Roboy/iceboard/datasheets/pcb_components.png

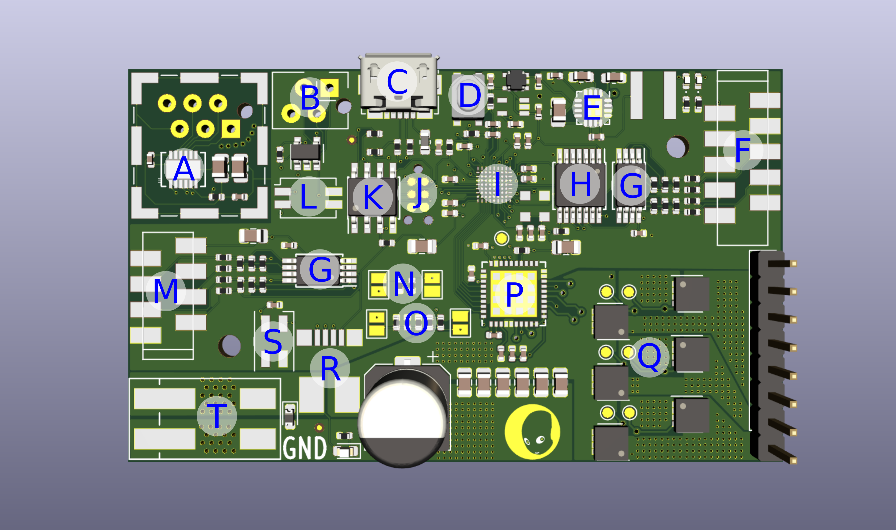
datasheets/pcb_components.png
