Roboy/iceboard/datasheets/tinyfpga_bx-pinout.jpg

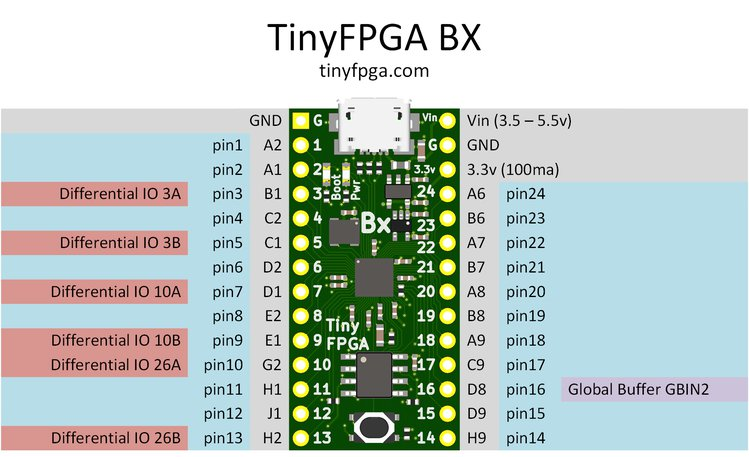
datasheets/tinyfpga_bx-pinout.jpg
