Roboy/iceboard/README.md

# bldc_motorboard
awesome motorboard for myoFamily muscles
