Roboy/iceboard/board/icebus.png

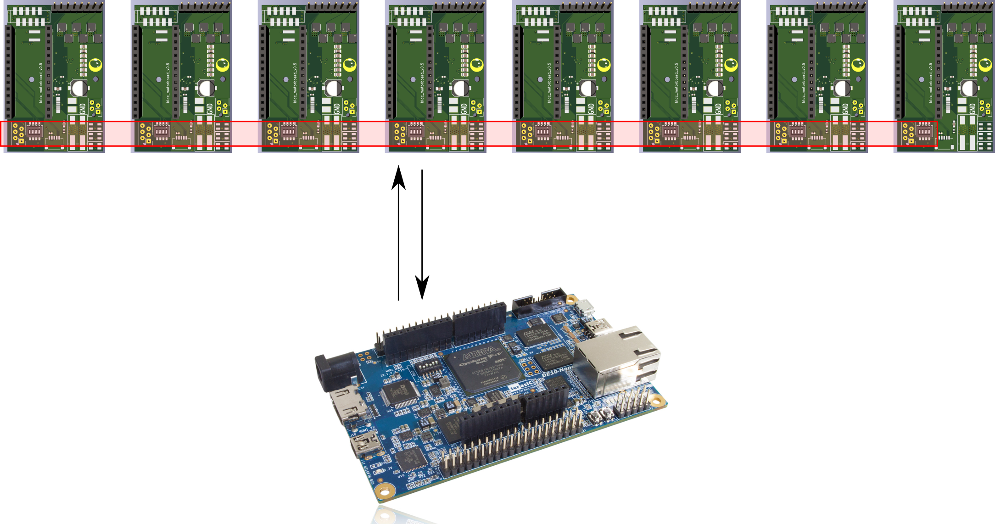
board/icebus.png
