Roboy/iceboard/board/overview.png

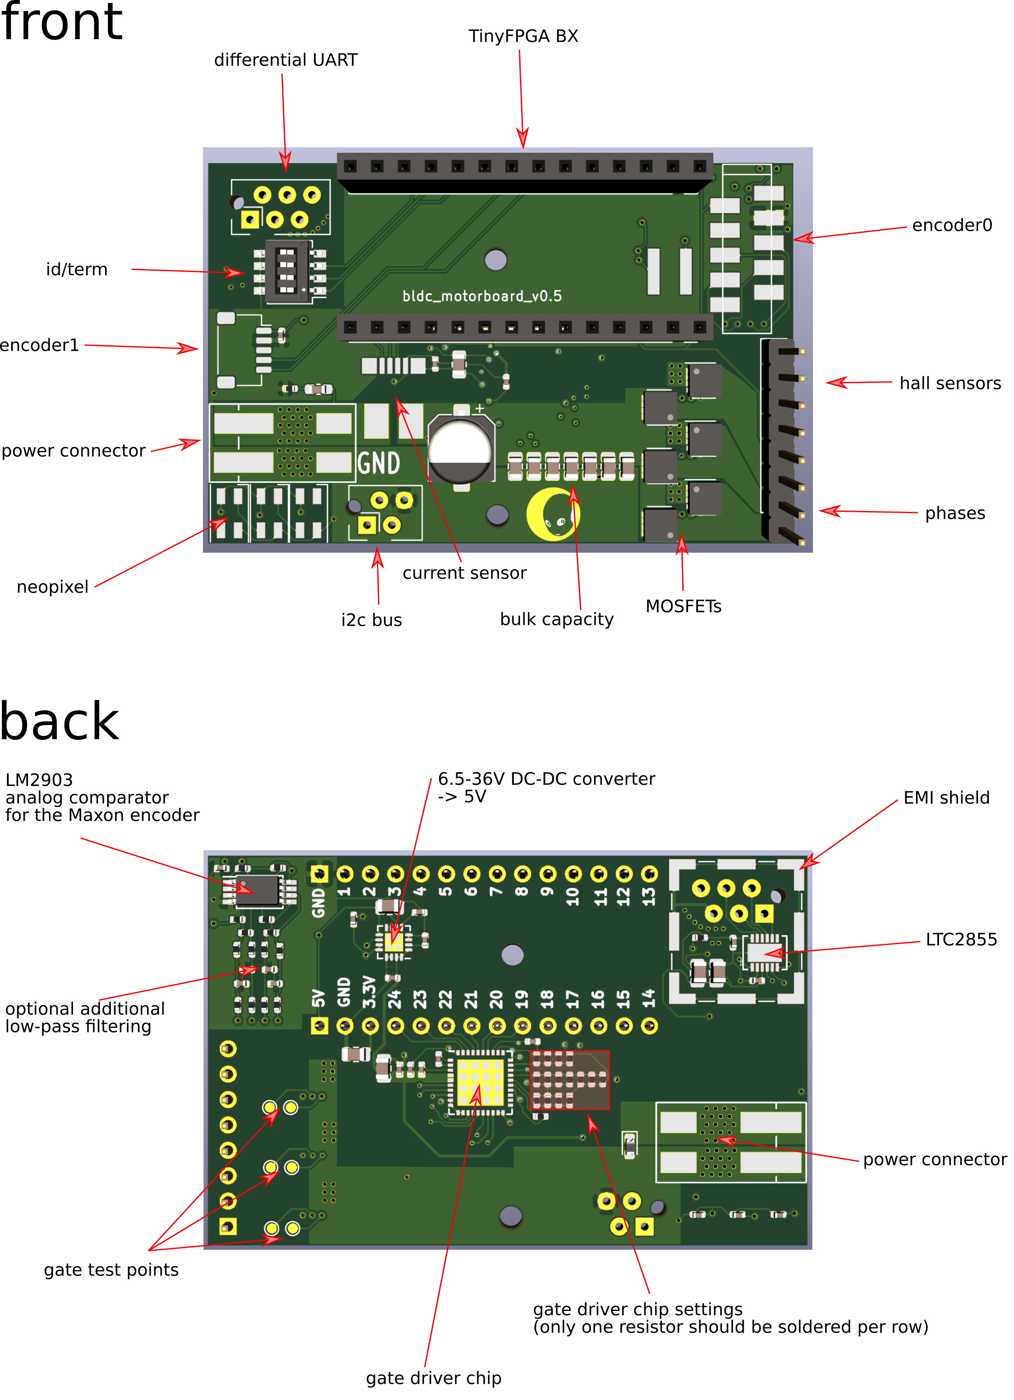
board/overview.png
