Roboy/iceboard/board/shield.png

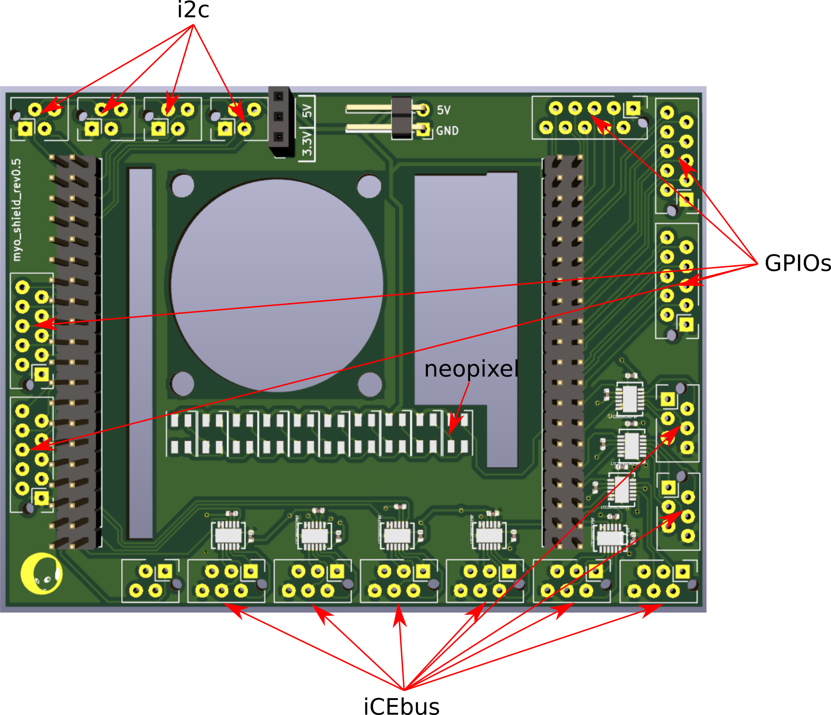
board/shield.png
