Roboy/iceboard/board/uart_protocol.jpg

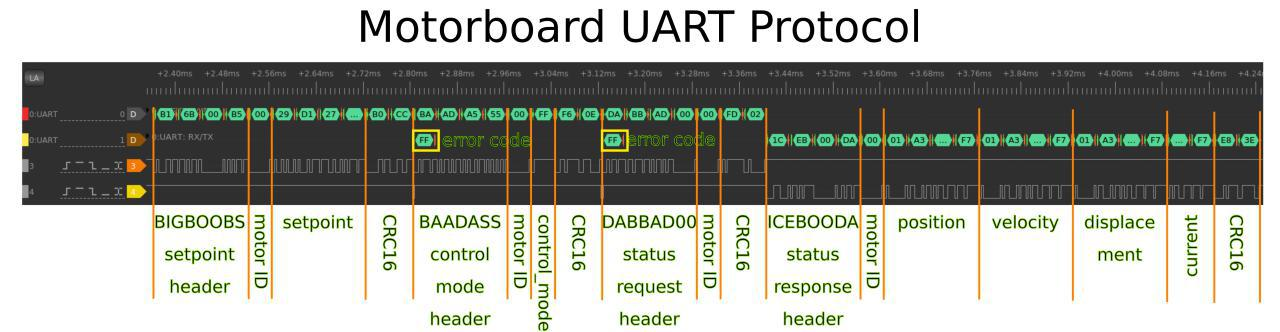
board/uart_protocol.jpg
