Roboy/iceboard/datasheets/icebus_command.png

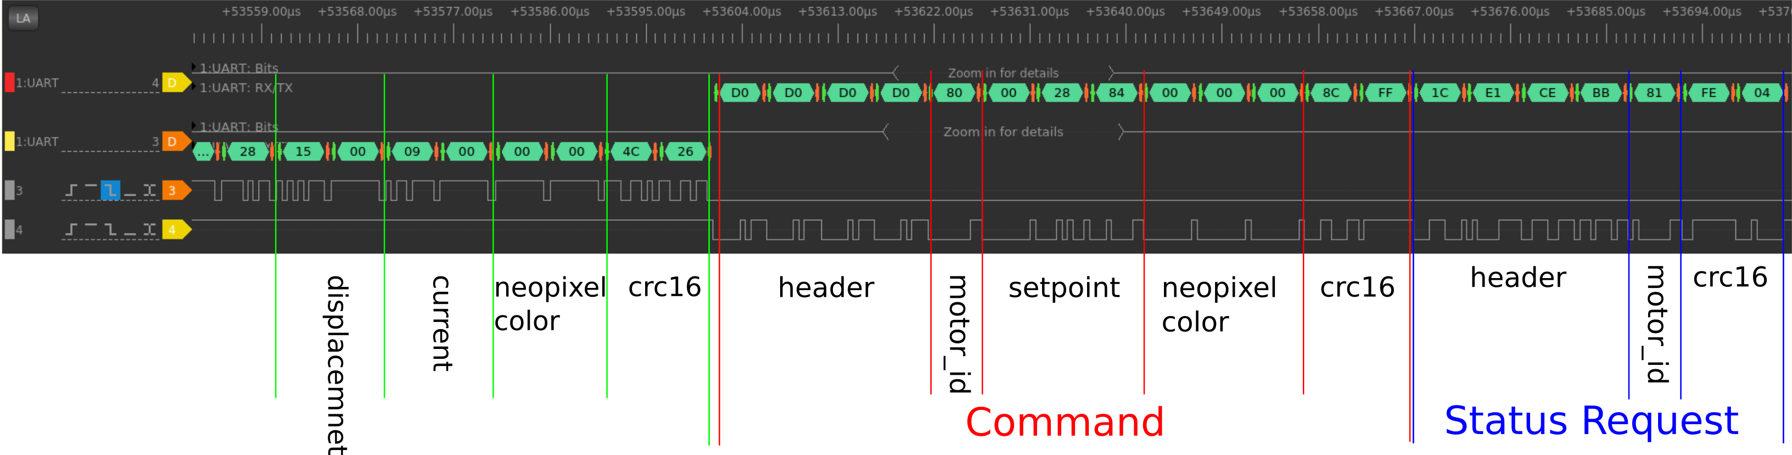
datasheets/icebus_command.png
