Roboy/iceboard/datasheets/icebus_status.png

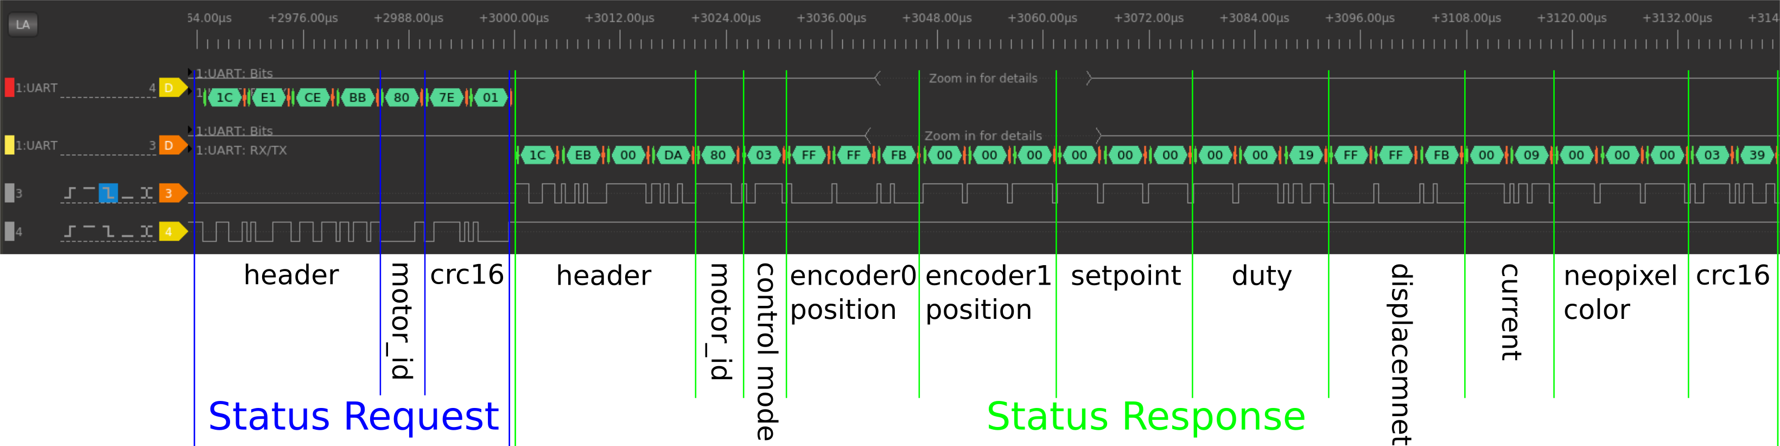
datasheets/icebus_status.png
