Roboy/iceboard/board/BOM.ods

Id | Designator | Package | Quantity | Designation | Supplier and ref
4 | C29,C26,C24,C15,C23,C18,C17,Cf1,C16,C14,C13,C8,C6,C2 | C_0402_1005Metric | 14 | 0.1uF
5 | U1 | BGA-25_6.35x6.35mm_Layout5x5_P1.27mm | 1 | LTM8074 | https://www.mouser.de/ProductDetail/Analog-Devices-Linear-Technology/LTM8074IYPBF
6 | D3 | LED_WS2812B-PLCC4_3.5x3.5 | 1 | NeoPixel_THT
7 | U2 | TSSOP-8_3x3mm_P0.65mm | 1 | LM2903 | https://www.mouser.de/ProductDetail/595-LM2903EPWRQ1
8 | R17,R16 | R_0402_1005Metric | 2 | 100k
9 | R15,R14,R13,R12,R11,R10,R9,R8,R7,R6,R5,R4,Rled1,R3 | R_0402_1005Metric | 14 | 10k
12 | D2 | D_0603_1608Metric | 1 | D_TVS
13 | J1 | MIRCO_MATCH | 1 | OpticalEncoder
14 | U3 | LTC8252_DD_DFN-10_DD | 1 | LTC2852HDDPBF
15 | J2 | PinHeader_1x08_P2.54mm_Vertical | 1 | PHASES
16 | D1 | C_0603_1608Metric_Pad1.05x0.95mm_HandSolder | 1 | LED
17 | Rt1 | R_0402_1005Metric | 1 | 22k
18 | Rfb1 | R_0402_1005Metric | 1 | 45.6k
19 | C12,C11,C10,C9 | C_0402_1005Metric | 4 | 22u
20 | J8 | Wago_2060_2_SMD | 1 | POWER_OUT
21 | J3 | Wago_2060_2_SMD | 1 | POWER_IN
22 | U7,U6,U5 | TLI4970 | 3 | TLI4970 | https://www.mouser.de/Sensors/Current-Sensors/Board-Mount-Current-Sensors/_/N-7gqfe?Keyword=TLI4970&FS=True
23 | Q1,Q4,Q5,Q3,Q2,Q6 | VSON-8_3.3x3.3mm_P0.65mm_NexFET | 6 | CSD18534Q5A
24 | R2 | R_0402_1005Metric | 1 | >500k -> 20V/V
25 | R1 | R_0402_1005Metric | 1 | 18k -> 570/1140mA
26 | DRV8323H1 | QFN-40-1EP_6x6mm_Pitch0.5mm | 1 | DRV8323HRTA | https://www.mouser.de/ProductDetail/Texas-Instruments/DRV8323HRTAR
27 | C27,C22,C21,C20,C19,C7 | C_0805_2012Metric | 6 | 22u/50V
28 | C25 | CP_Elec_6.3x4.5 | 1 | 220u
29 | C5,C3 | C_0402_1005Metric | 2 | 1uF
30 | C4 | C_0402_1005Metric | 1 | 47nF
31 | C1 | C_0402_1005Metric | 1 | 10uF
32 | J5 | TE-Connectivity_Micro-Match_connector_02x03_Pitch_1.27mm | 1 | UART
33 | J4 | TE-Connectivity_Micro-Match_connector_02x02_Pitch_1.27mm | 1 | Encoder1
34 | SW1 | SW_DIP_SPSTx03_Slide_KingTek_DSHP03TS_W7.62mm_P1.27mm | 1 | SW_DIP_x03
