Roboy/iceboard/board/bldc_board_v0.8.6/BOM.csv

Pos | Package | Value | Weborder | Quantity
C35,C34,C32,C31,C40 | C_0805_2012Metric | 100u/6.3V | https://www.mouser.de/ProductDetail/Murata-Electronics/GRM21BR60J107ME15L | 5
U11 | TSSOP-14_4.4x5mm_P0.65mm | TXB0104PW | https://www.mouser.de/ProductDetail/Texas-Instruments/TXB0104PWR | 1
L1 | XAL5050-103MEC | 10uH | https://www.mouser.de/ProductDetail/Coilcraft/XAL5050-103MEC | 1
U8 | iCE40-PL9K-CM81 | iCE40-LP8K-CM81 | https://www.mouser.de/ProductDetail/Lattice/iCE40LP8K-CM81 | 1
J4 | micro_match_female_8pos_SMT | ENCODER1 | https://www.mouser.de/ProductDetail/?qs=tddCKBGf4%252BORyb3AeIHMhg%3D%3D | 1
DRV8323H1 | QFN-40-1EP_6x6mm_Pitch0.5mm | DRV8323HRTA | https://www.mouser.de/ProductDetail/Texas-Instruments/DRV8323HRTAR | 1
U2,U5 | TSSOP-8_4.4x3mm_P0.65mm | LM2903 | https://www.mouser.de/ProductDetail/Texas-Instruments/LM2903PWR | 2
Q2,Q1,Q4,Q5,Q3,Q6 | VSON-8_3.3x3.3mm_P0.65mm_NexFET | BSZ100N06NS | https://www.mouser.de/ProductDetail/Infineon-Technologies/BSZ100N06NS | 6
U1 | ltc2855 | LTC2855CDEPBF | https://www.mouser.de/ProductDetail/Analog-Devices/LTC2855CDEPBF | 1
R27,R15,R14,R4,Rled1,R3,R35,R36,R45,R46,R48,R49,R47 | R_0402_1005Metric | 10k |  | 21
C23,C22,C11,Cf1,C6,C2,C24,Cf2,C13,C14,C16,C29,C41,C44,C46,C47 | C_0402_1005Metric | 0.1uF | https://www.mouser.de/ProductDetail/Wurth-Elektronik/885012105018 | 16
C21,C19,C18,C27,C20,C7,C30 | C_0805_2012Metric | 22uF/35V | https://www.mouser.de/ProductDetail/TDK/C2012JB1V226M125AC | 7
C25 | CP_Elec_6.3x4.5 | 220uF | https://www.mouser.de/ProductDetail/Nichicon/UUR1V221MNL6GS?qs=sGAEpiMZZMvwFf0viD3Y3drhLzO8cB0SKlUrwx8MzyQ%3D | 1
C8,C9 | C_0603_1608Metric | 2.2uF | https://www.mouser.de/ProductDetail/Murata-Electronics/GRM188R6YA225MA12D | 2
C12 | C_0805_2012Metric | 22uF | https://www.mouser.de/ProductDetail/KEMET/C0805C226M9PACTU?qs=sGAEpiMZZMs0AnBnWHyRQHfJxnYD9SALQCiwVfbOcCo%3D | 1
MAX176321 | QFN-16-1EP_3x3mm_Pitch0.5mm | MAX17632 | https://www.mouser.de/ProductDetail/Maxim-Integrated/MAX17632BATE%2b | 1
C10 | C_0402_1005Metric | 5600pF/6.3V |  | 1
R11,R10,R9,R8,R7,R6,R5,R32,R17,R16,R37,R38 | R_0402_1005Metric | 1k |  | 8
D2 | D_0603_1608Metric | D_TVS | https://www.mouser.de/ProductDetail/Comchip-Technology/CPDU24V0U-HF | 1
J3 | Wago_2060_2_SMD | POWER_IN | https://www.reichelt.com/de/en/smd-pcb-terminal-2-pole-rm-4-mm-white-wago-2060-452-p163243.html?trstct=vrt_pdn | 1
C5,C3,C17,C26,C28,C36 | C_0402_1005Metric | 1uF |  | 6
C4 | C_0402_1005Metric | 47nF |  | 1
C15,C38 | C_0402_1005Metric | 10uF | https://www.mouser.de/ProductDetail/Murata-Electronics/GRJ155R60J106ME11D | 2
D3 | LED_SK6812MINI_PLCC4_3.5x3.5mm_P1.75mm | SK6812MINI | https://www.aliexpress.com/item/32434844290.html | 1
U3 | TLI4970 | TLI4970 | https://www.mouser.de/ProductDetail/Infineon-Technologies/TLI4970D025T5XUMA1 | 1
J1 | micro_match_female_10pos_SMT | ENCODER0 | https://www.mouser.de/ProductDetail/TE-Connectivity/1-2178711-0 | 1
R39 | R_0402_1005Metric | 100 |  | 1
R40 | R_0402_1005Metric | 1.5k |  | 1
R41,R42 | R_0402_1005Metric | 68 |  | 2
R43,R44 | R_0402_1005Metric | 270 |  | 2
U4 | SOT-23-5 | EEPROM | https://www.mouser.de/ProductDetail/Microchip-Technology-Atmel/AT24C16D-STUM-T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 | 1
J6 | USB_Micro-B_Molex_47346-0001 | USB_OTG | https://www.mouser.de/ProductDetail/Molex/47346-0001 | 1
U9 | SOIC-8_3.9x4.9mm_P1.27mm | AT25SF081-SSHD-B | https://www.mouser.de/ProductDetail/Adesto-Technologies/AT25SF081-SSHD-B | 1
SW2 | PTS_810_SMT_Switch | SW_Push | https://www.mouser.de/ProductDetail/CK/PTS810SJK250SMTRLFS?qs=sGAEpiMZZMsgGjVA3toVBGTSKfeK9LPKcu5sgFDgdHE%3D | 1
U6 | SC70-5 | TLV70033DCKR | https://www.mouser.de/ProductDetail/595-TLV70033DCKR | 1
U7 | SC-70-C5 | MIC5365-1.2YC5-TR | https://www.mouser.de/ProductDetail/Microchip-Technology-Micrel/MIC5365-12YC5-TR | 1
U10 | CDFN3225-4LD-PL-1 | DSC6001CI2A-016.0000T | https://www.mouser.de/ProductDetail/Microchip-Technology/DSC6001CI2A-0160000T | 1
C37,C39,C42,C43 | C_0402_1005Metric | 10nF/6.3V |  | 4
D1 | LED_0603_1608Metric | LED | https://www.mouser.de/ProductDetail/ROHM-Semiconductor/SMLD12BN1WT86 | 1
L2 | L_0603_1608Metric | Bead | https://www.mouser.de/ProductDetail/Murata-Electronics/BLM18PG600SZ1D | 1
SW1 | SW_DIP_SPSTx02_Slide_Copal_CHS-02A_W5.08mm_P1.27mm_JPin | SW_DIP_x02 | https://www.digikey.de/product-detail/de/nidec-copal-electronics/CHS-02TB/563-1006-1-ND/948407 | 1
D4,D5 | LED_0402_1005Metric | LED_Small | https://www.mouser.de/ProductDetail/ROHM-Semiconductor/SML-P11VTT86R | 2
J10 | BMI-S-201-F_13.66x12.7mm | Shielding | https://www.mouser.de/ProductDetail/Laird-Performance-Materials/BMI-S-201-F | 1
 |  |  |  | 113
