Roboy/iceboard/board/bldc_board_v0.8.6/assembly.png

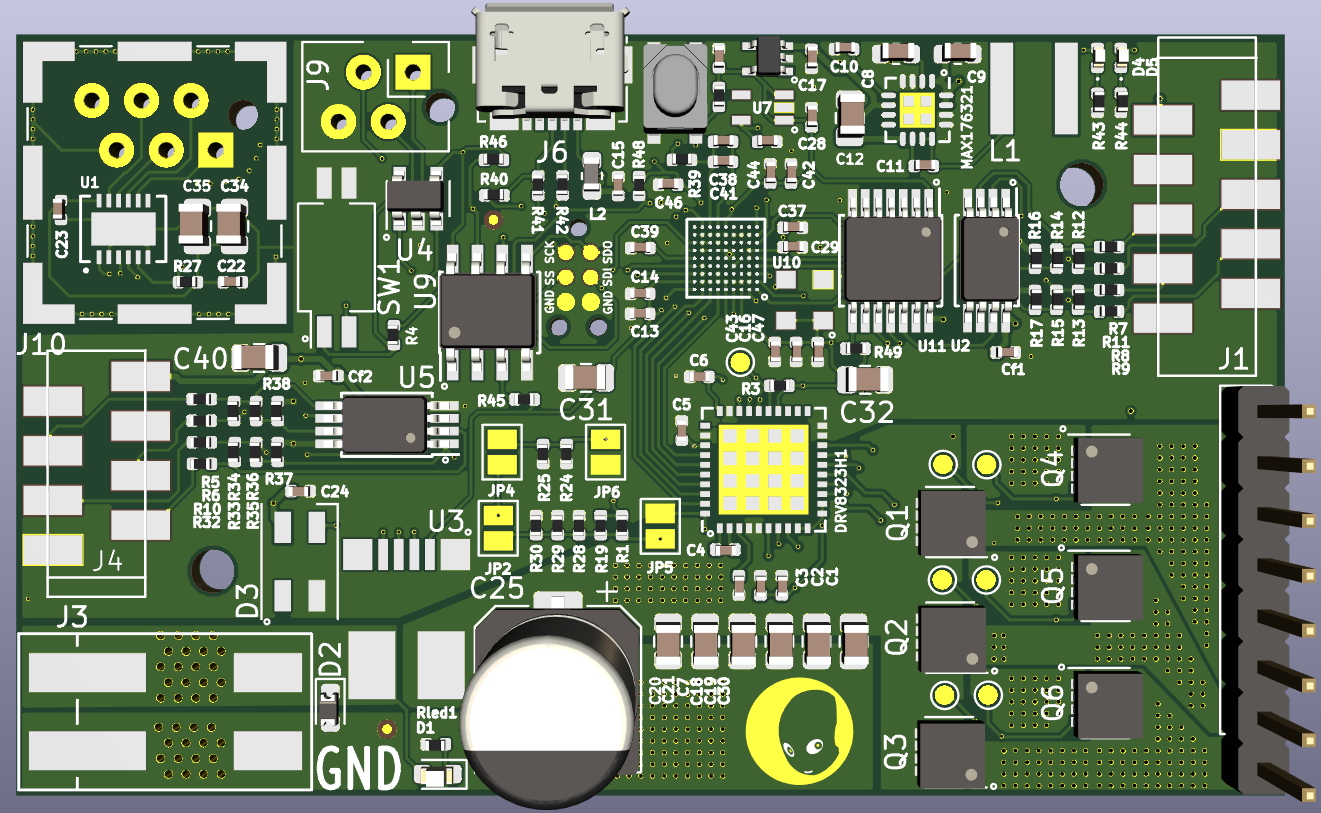
board/bldc_board_v0.8.6/assembly.png
