Roboy/iceboard/(threads)

Thread 3 (2023-08-08):

decimation

peepo, 2023-08-08:
Hi there,

is this: https://github.com/Roboy/iceboard/blob/master/software/adc_lvds/verilog/cic.v
working code?

Two queries:
1]  data_in <= diff_input; but one is wire the other [7:0] which might not normally be intentional?
ie what am I not understanding?

2] output d_clk is not currently connected. Does it have an essential purpose?

thanks for any guidance!!

I need a CIC module for ADC and there are few available
