Roboy/iceboard/board/overview.pdf

# front

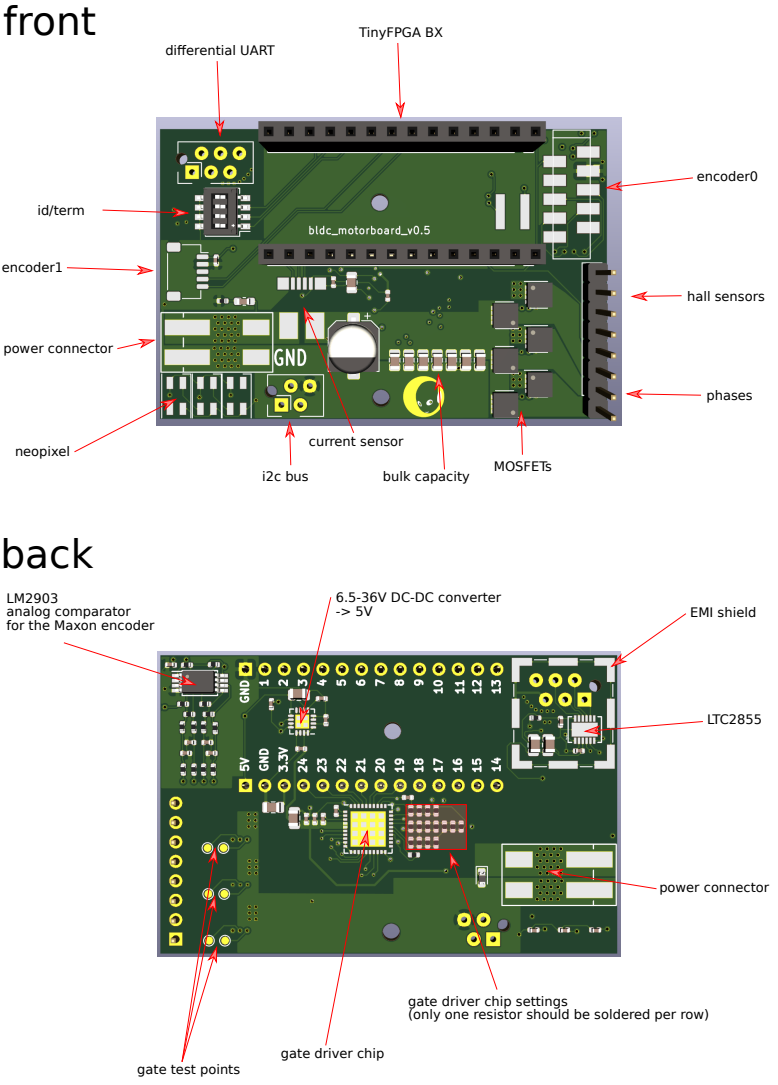
[picture p10: page 1]
back; power connector; neopixel; encoder1; id/term; differential UART; TinyFPGA BX; encoder0; phases; hall sensors; i2c bus; current sensor; LTC2855; EMI shield

MOSFETs bulk capacity

6.5-36V DC-DC converter

analog comparator
for the Maxon encoder

gate driver chip settings
(only one resistor should be soldered per row)

gate driver chip

gate test points
