Roboy/iceboard/board/board.pdf

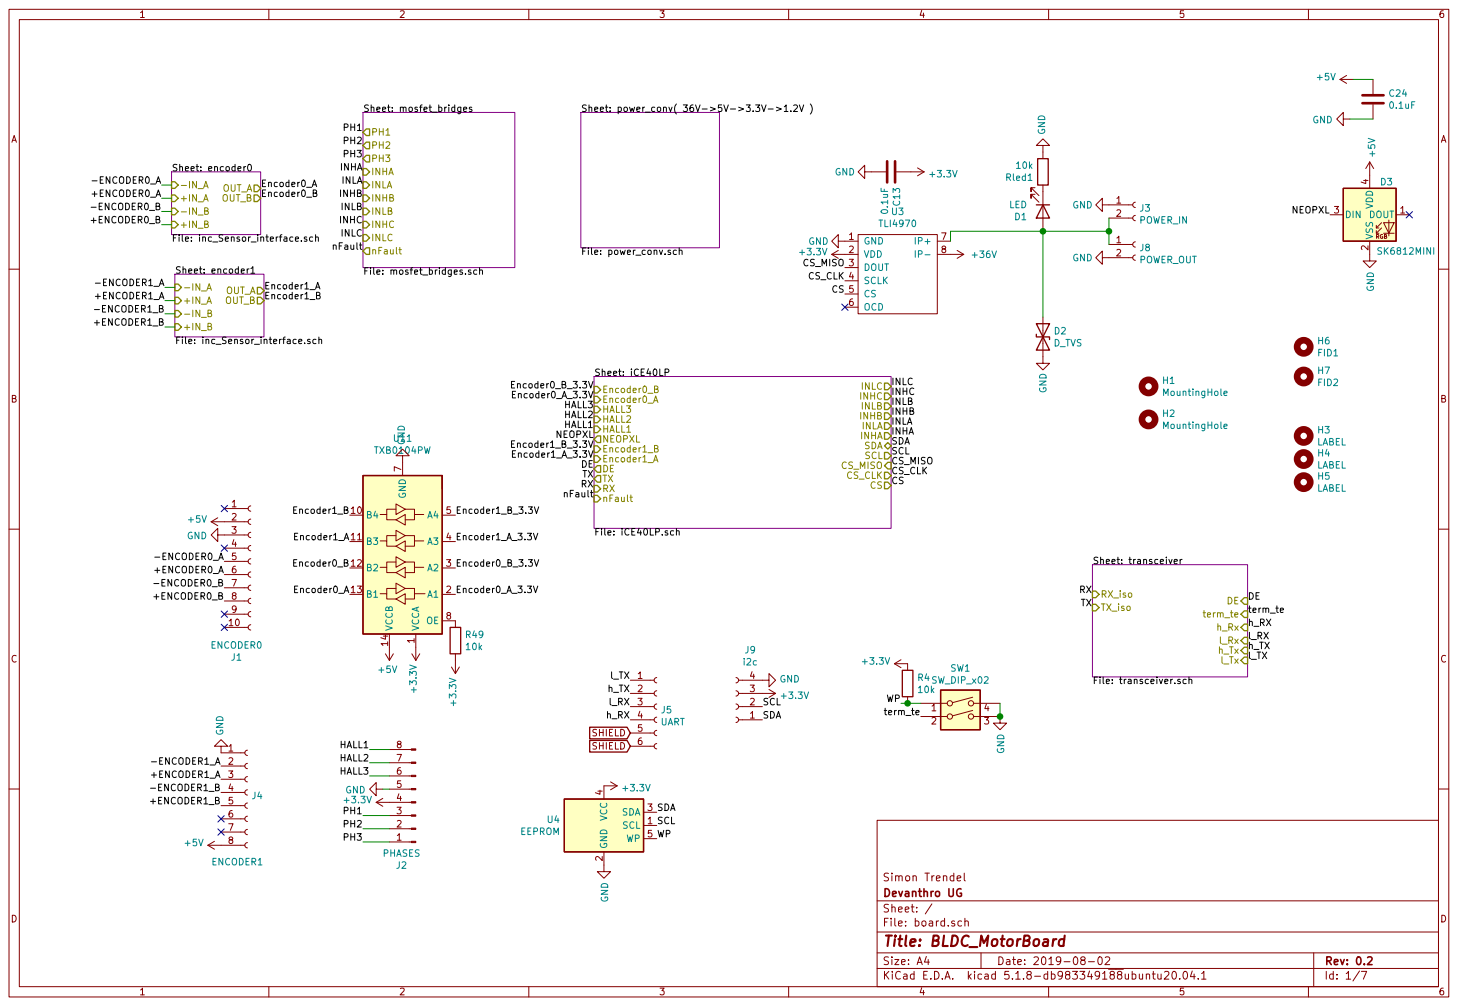
[picture p11: page 1]

4 WP 5 U4 EEPROM GND GND GND

File: power_conv.sch Sheet: encoder0 File: inc_Sensor_interface.sch +IN_A

Sheet: transceiver File: transceiver.sch RX_iso TX_iso

Simon Trendel
File: board.sch Sheet: / Devanthro UG
