Roboy/iceboard/board/board.kicad_pcb

## KiCad design board/board.kicad_pcb (2020-05-19)

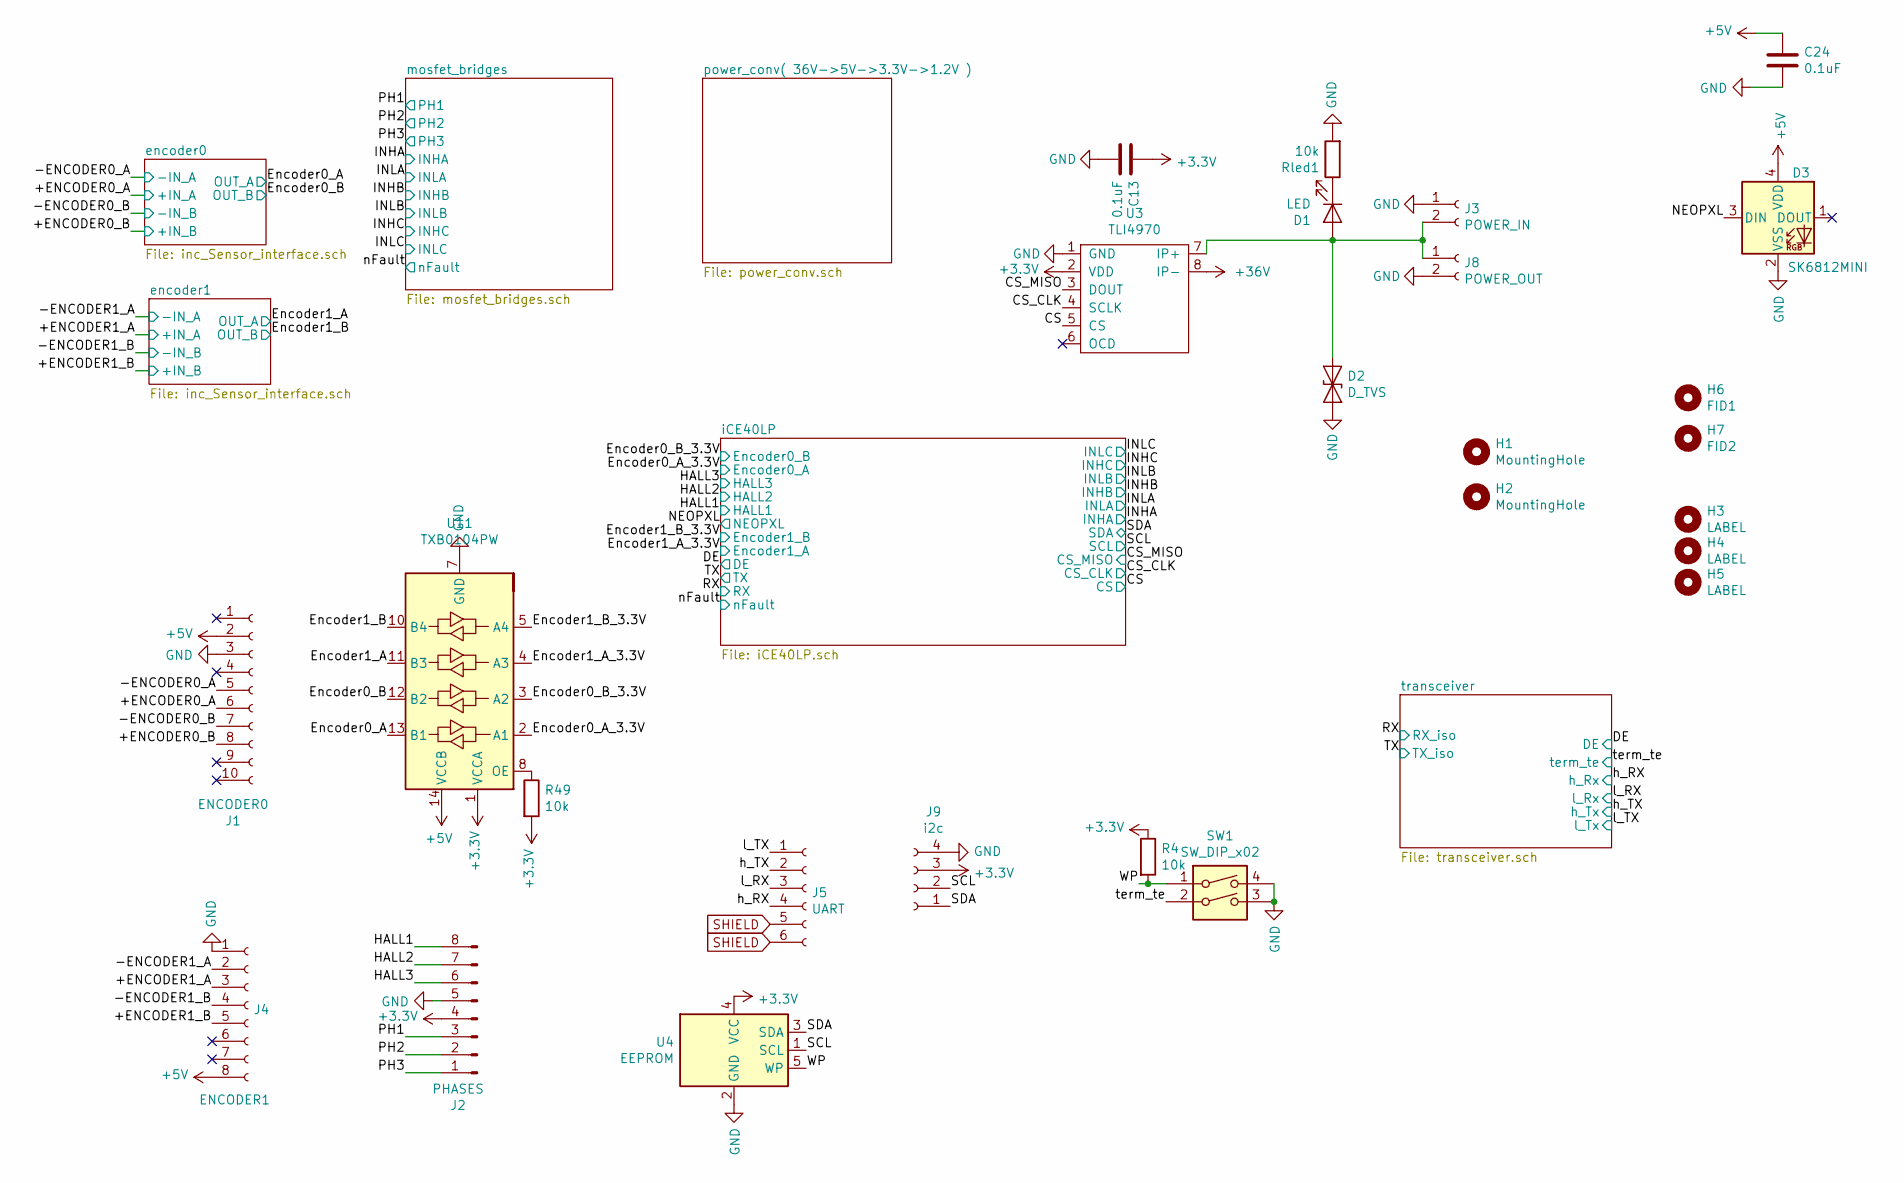
[picture p12: schematic board.sch, BLDC_MotorBoard]

Parts:
C13, C24: 0.1uF; C_0402_1005Metric
D1: LED; LED_0603_1608Metric
D2: D_TVS; D_0603_1608Metric
D3: SK6812MINI; LED_SK6812MINI_PLCC4_3.5x3.5mm_P1.75mm
H1, H2: MountingHole; MountingHole_2.2mm_M2
H3: LABEL; R1_ear_silk_5.5mm
H4: LABEL; R1_eyes_mask_5.5mm
H5: LABEL; R1_face_mask_5.5mm
H6: FID1; Fiducial_0.5mm_Dia_1mm_Outer
H7: FID2; Fiducial_0.5mm_Dia_1mm_Outer
J1: ENCODER0; micro_match_female_10pos_SMT
J2: PHASES; PinHeader_1x08_P2.54mm_Vertical
J3: POWER_IN; Wago_2060_2_SMD
J4: ENCODER1; micro_match_female_8pos_SMT
J5: UART; TE-Connectivity_Micro-Match_connector_02x03_Pitch_1.27mm
J8: POWER_OUT; Wago_2060_2_SMD
J9: i2c; TE-Connectivity_Micro-Match_connector_02x02_Pitch_1.27mm
R4, R49: 10k; R_0402_1005Metric
Rled1: 10k; R_0402_1005Metric
SW1: SW_DIP_x02; SW_DIP_SPSTx02_Slide_Copal_CHS-02B_W7.62mm_P1.27mm
U3: TLI4970
U4: EEPROM; SOT-23-5
U11: TXB0104PW; TSSOP-14_4.4x5mm_P0.65mm

Connections:
+5V: C24.1, D3.4 (VDD), J1.2, J4.8, U11.14 (VCCB); also elsewhere on the board
+36V: U3.8 (IP-); also elsewhere on the board
/+ENCODER0_A: J1.6; also elsewhere on the board
/+ENCODER0_B: J1.8; also elsewhere on the board
/+ENCODER1_A: J4.3; also elsewhere on the board
/+ENCODER1_B: J4.5; also elsewhere on the board
/-ENCODER0_A: J1.5; also elsewhere on the board
/-ENCODER0_B: J1.7; also elsewhere on the board
/-ENCODER1_A: J4.2; also elsewhere on the board
/-ENCODER1_B: J4.4; also elsewhere on the board
/CS: U3.5 (CS); also elsewhere on the board
/CS_CLK: U3.4 (SCLK); also elsewhere on the board
/CS_MISO: U3.3 (DOUT); also elsewhere on the board
/Encoder0_A: U11.13 (B1); also elsewhere on the board
/Encoder0_A_3.3V: U11.2 (A1); also elsewhere on the board
/Encoder0_B: U11.12 (B2); also elsewhere on the board
/Encoder0_B_3.3V: U11.3 (A2); also elsewhere on the board
/Encoder1_A: U11.11 (B3); also elsewhere on the board
/Encoder1_A_3.3V: U11.4 (A3); also elsewhere on the board
/Encoder1_B: U11.10 (B4); also elsewhere on the board
/Encoder1_B_3.3V: U11.5 (A4); also elsewhere on the board
/HALL1: J2.8; also elsewhere on the board
/HALL2: J2.7; also elsewhere on the board
/HALL3: J2.6; also elsewhere on the board
/NEOPXL: D3.3 (DIN); also elsewhere on the board
/PH1: J2.3; also elsewhere on the board
/PH2: J2.2; also elsewhere on the board
/PH3: J2.1; also elsewhere on the board
/SCL: J9.2, U4.1 (SCL); also elsewhere on the board
/SDA: J9.1, U4.3 (SDA); also elsewhere on the board
/WP: R4.2, SW1.1, U4.5 (WP)
/h_RX: J5.4; also elsewhere on the board
/h_TX: J5.2; also elsewhere on the board
/l_RX: J5.3; also elsewhere on the board
/l_TX: J5.1; also elsewhere on the board
/term_te: SW1.2; also elsewhere on the board
GND: C13.2, C24.2, D2.2 (A2), D3.2 (VSS), J1.3, J2.5, J3.1, J4.1, J8.2, J9.4, Rled1.2, SW1.3, SW1.4, U3.1 (GND), U4.2 (GND), U11.7 (GND); also elsewhere on the board
unnamed: D1.1 (K), Rled1.1
unnamed: D1.2 (A), D2.1 (A1), J3.2, J8.1, U3.7 (IP+)
unnamed: R49.1, U11.8 (OE)
SHIELD: J5.5, J5.6; also elsewhere on the board

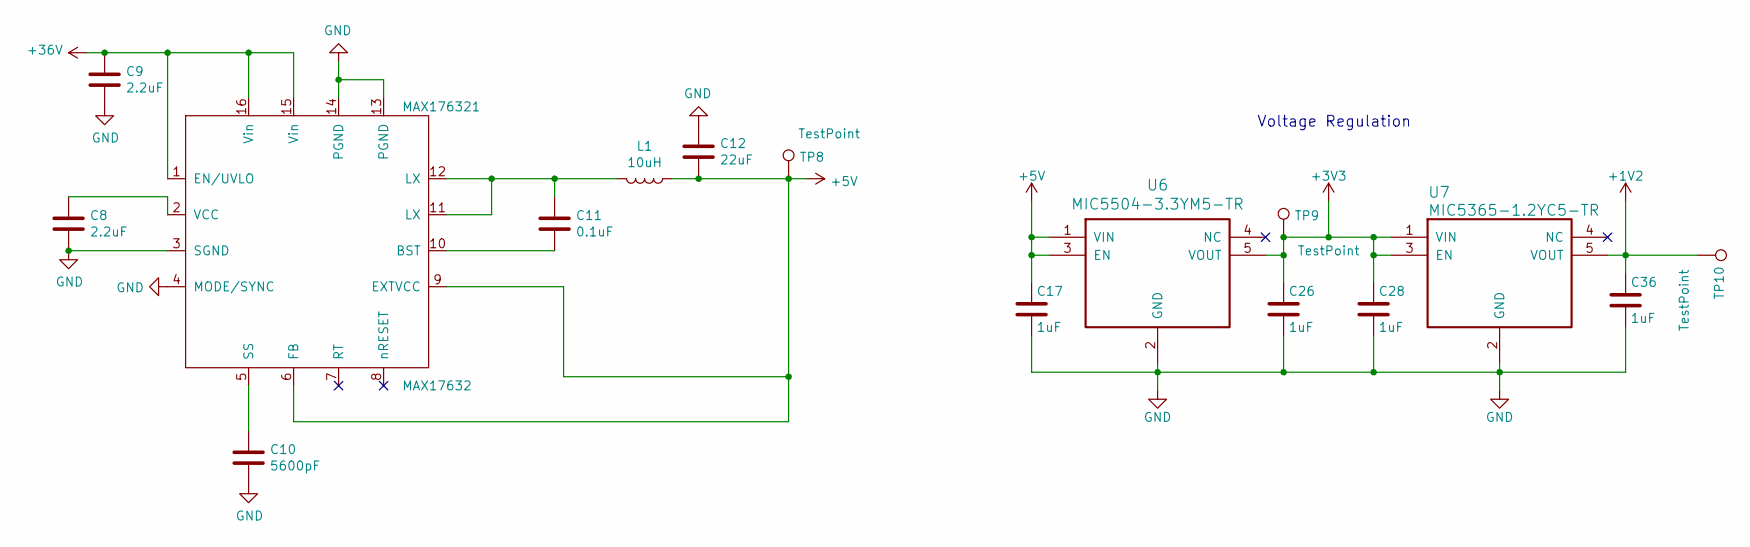
[picture p13: schematic power_conv.sch]

Parts:
C8, C9: 2.2uF; C_0603_1608Metric
C10: 5600pF; C_0402_1005Metric
C11: 0.1uF; C_0402_1005Metric
C12: 22uF; C_0805_2012Metric
C17, C26, C28, C36: 1uF; C_0402_1005Metric
L1: 10uH; XAL5050-103MEC
MAX176321: MAX17632; QFN-16-1EP_3x3mm_Pitch0.5mm
TP8, TP9, TP10: TestPoint; TestPoint_Pad_D1.0mm
U6: MIC5504-3.3YM5-TR; SC70-5
U7: MIC5365-1.2YC5-TR; SC-70-C5

Connections:
+1V2: C36.1, TP10.1, U7.5 (VOUT); also elsewhere on the board
+5V: C12.2, C17.1, L1.1, MAX176321.6 (FB), MAX176321.9 (EXTVCC), TP8.1, U6.1 (VIN), U6.3 (EN); also elsewhere on the board
+36V: C9.1, MAX176321.1 (EN/UVLO), MAX176321.15 (Vin), MAX176321.16 (Vin); also elsewhere on the board
GND: C8.2, C9.2, C10.2, C12.1, C17.2, C26.2, C28.2, C36.2, MAX176321.3 (SGND), MAX176321.4 (MODE/SYNC), MAX176321.13 (PGND), MAX176321.14 (PGND), U6.2 (GND), U7.2 (GND); also elsewhere on the board
unnamed: C8.1, MAX176321.2 (VCC)
unnamed: C10.1, MAX176321.5 (SS)
unnamed: C11.1, L1.2, MAX176321.11 (LX), MAX176321.12 (LX)
unnamed: C11.2, MAX176321.10 (BST)
unnamed 107: U6.4 (NC); also elsewhere on the board

Notes on the sheet:
Voltage Regulation

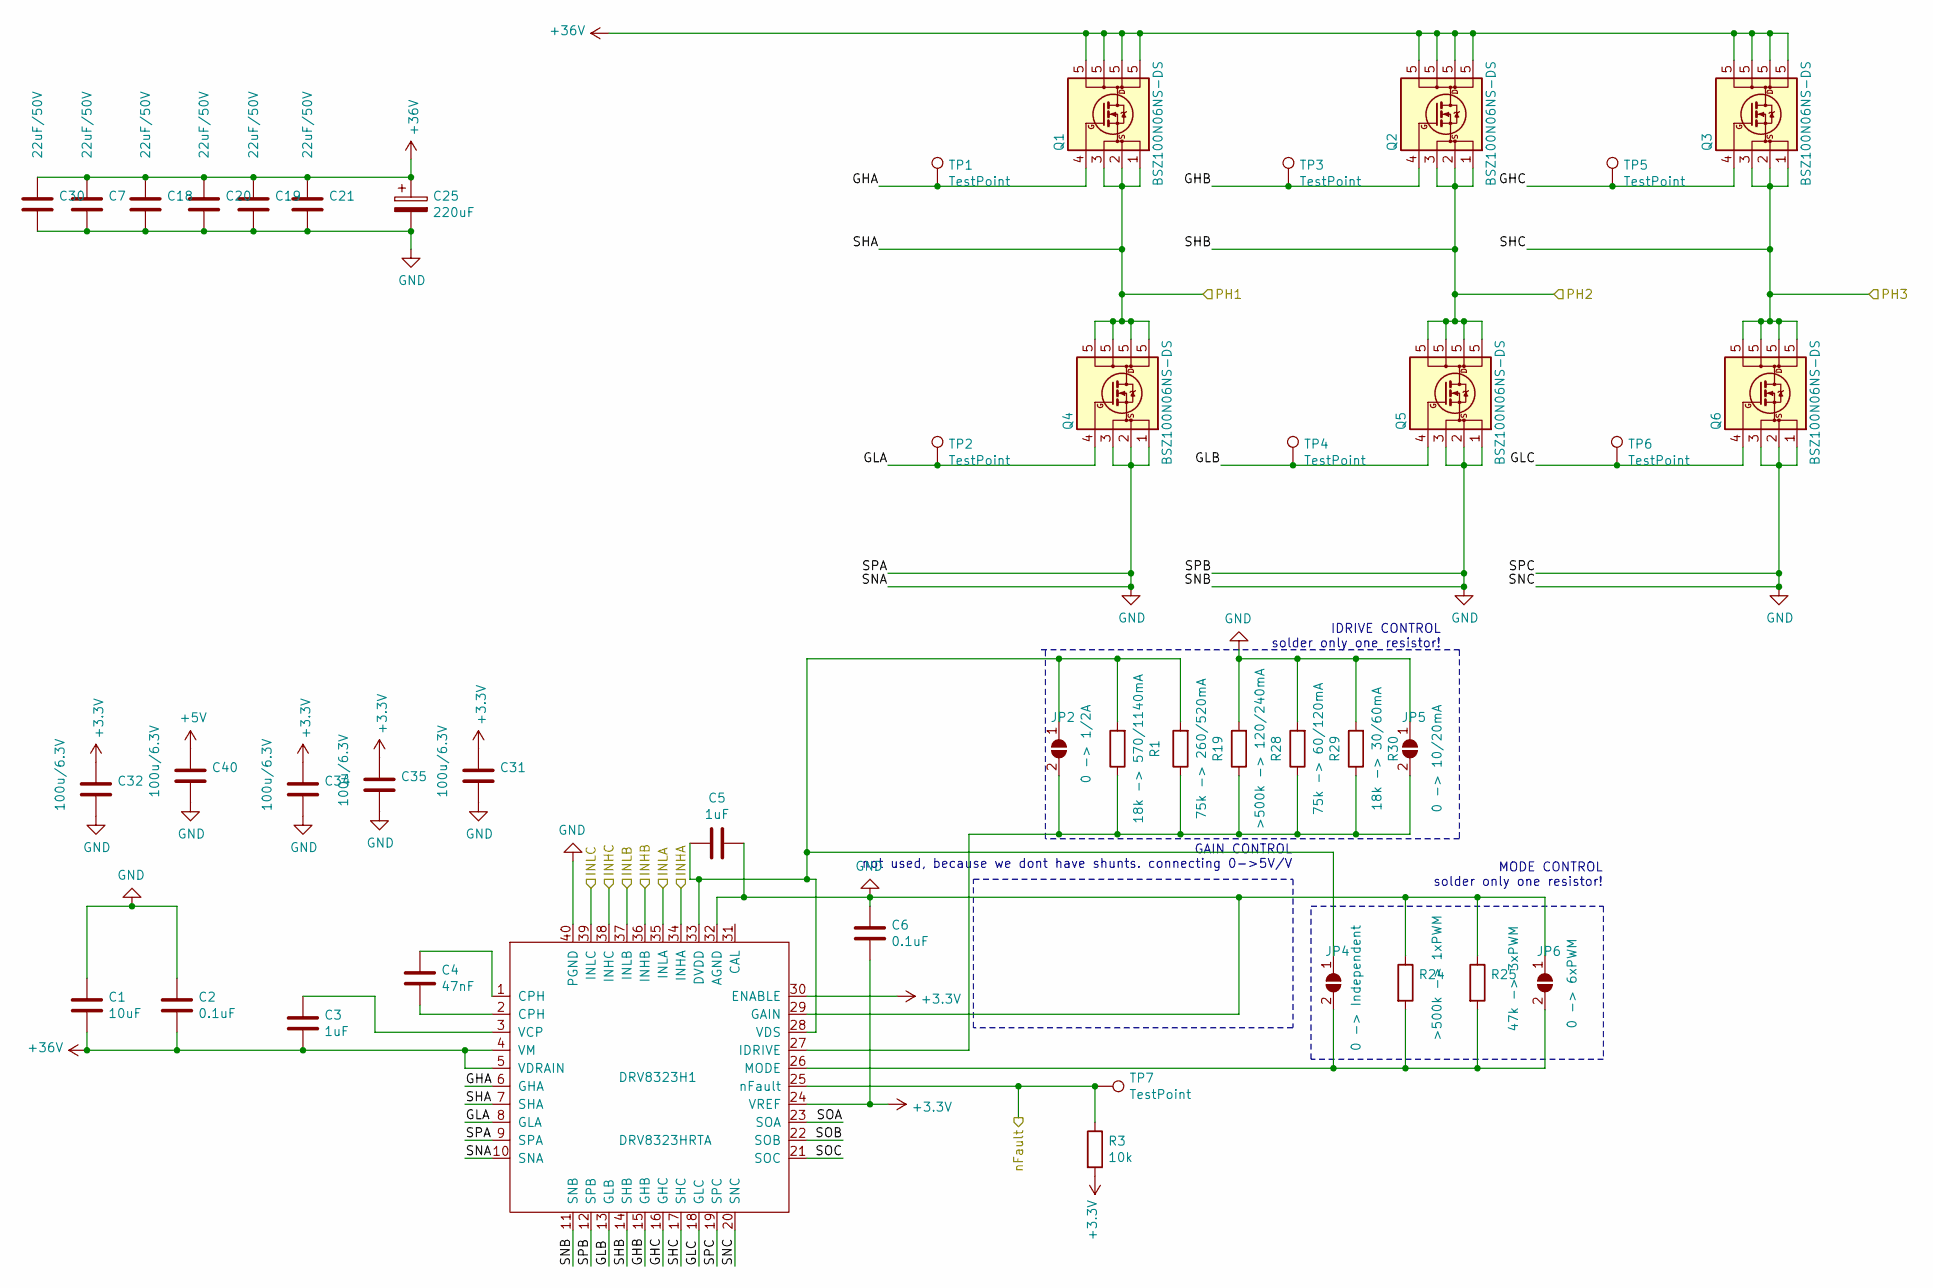
[picture p14: schematic mosfet_bridges.sch, BLDC_MotorBoard]

Parts:
C1: 10uF; C_0402_1005Metric
C2, C6: 0.1uF; C_0402_1005Metric
C3, C5: 1uF; C_0402_1005Metric
C4: 47nF; C_0402_1005Metric
C7, C18, C19, C20, C21, C30: 22uF/50V; C_0805_2012Metric
C25: 220uF; CP_Elec_8x10
C31, C32, C34, C35, C40: 100u/6.3V; C_0805_2012Metric
DRV8323H1: DRV8323HRTA; QFN-40-1EP_6x6mm_Pitch0.5mm
JP2: 0 -> 1/2A; SolderJumper-2_P1.3mm_Open_Pad1.0x1.5mm
JP4: 0 -> Independent; SolderJumper-2_P1.3mm_Open_Pad1.0x1.5mm
JP5: 0 -> 10/20mA; SolderJumper-2_P1.3mm_Open_Pad1.0x1.5mm
JP6: 0 -> 6xPWM; SolderJumper-2_P1.3mm_Open_Pad1.0x1.5mm
Q1, Q2, Q3, Q4, Q5, Q6: BSZ100N06NS-DS; VSON-8_3.3x3.3mm_P0.65mm_NexFET
R1: 18k -> 570/1140mA; R_0402_1005Metric
R3: 10k; R_0402_1005Metric
R19: 75k -> 260/520mA; R_0402_1005Metric
R24: >500k -> 1xPWM; R_0402_1005Metric
R25: 47k -> 3xPWM; R_0402_1005Metric
R28: >500k -> 120/240mA; R_0402_1005Metric
R29: 75k -> 60/120mA; R_0402_1005Metric
R30: 18k -> 30/60mA; R_0402_1005Metric
TP1, TP2, TP3, TP4, TP5, TP6, TP7: TestPoint; TestPoint_Pad_D1.0mm

Connections:
+5V: C40.1; also elsewhere on the board
+36V: C1.2, C2.2, C3.2, C7.1, C18.1, C19.1, C20.1, C21.1, C25.1, C30.1, DRV8323H1.4 (VM), DRV8323H1.5 (VDRAIN), Q1.5 (D), Q2.5 (D), Q3.5 (D); also elsewhere on the board
/INHA: DRV8323H1.34 (INHA); also elsewhere on the board
/INHB: DRV8323H1.36 (INHB); also elsewhere on the board
/INHC: DRV8323H1.38 (INHC); also elsewhere on the board
/INLA: DRV8323H1.35 (INLA); also elsewhere on the board
/INLB: DRV8323H1.37 (INLB); also elsewhere on the board
/INLC: DRV8323H1.39 (INLC); also elsewhere on the board
/PH1: DRV8323H1.7 (SHA), Q1.1 (S), Q1.2 (S), Q1.3 (S), Q4.5 (D); also elsewhere on the board
/PH2: DRV8323H1.14 (SHB), Q2.1 (S), Q2.2 (S), Q2.3 (S), Q5.5 (D); also elsewhere on the board
/PH3: DRV8323H1.17 (SHC), Q3.1 (S), Q3.2 (S), Q3.3 (S), Q6.5 (D); also elsewhere on the board
/mosfet_bridges/GHA: DRV8323H1.6 (GHA), Q1.4 (G), TP1.1
/mosfet_bridges/GHB: DRV8323H1.15 (GHB), Q2.4 (G), TP3.1
/mosfet_bridges/GHC: DRV8323H1.16 (GHC), Q3.4 (G), TP5.1
/mosfet_bridges/GLA: DRV8323H1.8 (GLA), Q4.4 (G), TP2.1
/mosfet_bridges/GLB: DRV8323H1.13 (GLB), Q5.4 (G), TP4.1
/mosfet_bridges/GLC: DRV8323H1.18 (GLC), Q6.4 (G), TP6.1
/mosfet_bridges/SOA: DRV8323H1.23 (SOA)
/mosfet_bridges/SOB: DRV8323H1.22 (SOB)
/mosfet_bridges/SOC: DRV8323H1.21 (SOC)
/nFault: DRV8323H1.25 (nFault), R3.1, TP7.1; also elsewhere on the board
GND: C1.1, C2.1, C5.1, C6.1, C7.2, C18.2, C19.2, C20.2, C21.2, C25.2, C30.2, C31.2, C32.2, C34.2, C35.2, C40.2, DRV8323H1.9 (SPA), DRV8323H1.10 (SNA), DRV8323H1.11 (SNB), DRV8323H1.12 (SPB), DRV8323H1.19 (SPC), DRV8323H1.20 (SNC), DRV8323H1.29 (GAIN), DRV8323H1.32 (AGND), DRV8323H1.40 (PGND), JP5.1 (A), JP6.1 (A), Q4.1 (S), Q4.2 (S), Q4.3 (S), Q5.1 (S), Q5.2 (S), Q5.3 (S), Q6.1 (S), Q6.2 (S), Q6.3 (S), R24.1, R25.1, R28.2, R29.2, R30.2; also elsewhere on the board
unnamed: C3.1, DRV8323H1.3 (VCP)
unnamed: C4.1, DRV8323H1.1 (CPH)
unnamed: C4.2, DRV8323H1.2 (CPH)
unnamed: C5.2, DRV8323H1.28 (VDS), DRV8323H1.33 (DVDD), JP2.1 (A), JP4.1 (A), R1.2, R19.2
unnamed: DRV8323H1.26 (MODE), JP4.2 (B), JP6.2 (B), R24.2, R25.2
unnamed: DRV8323H1.27 (IDRIVE), JP2.2 (B), JP5.2 (B), R1.1, R19.1, R28.1, R29.1, R30.1

Notes on the sheet:
MODE CONTROL solder only one resistor!
GAIN CONTROL not used, because we dont have shunts. connecting 0->5V/V
IDRIVE CONTROL solder only one resistor!

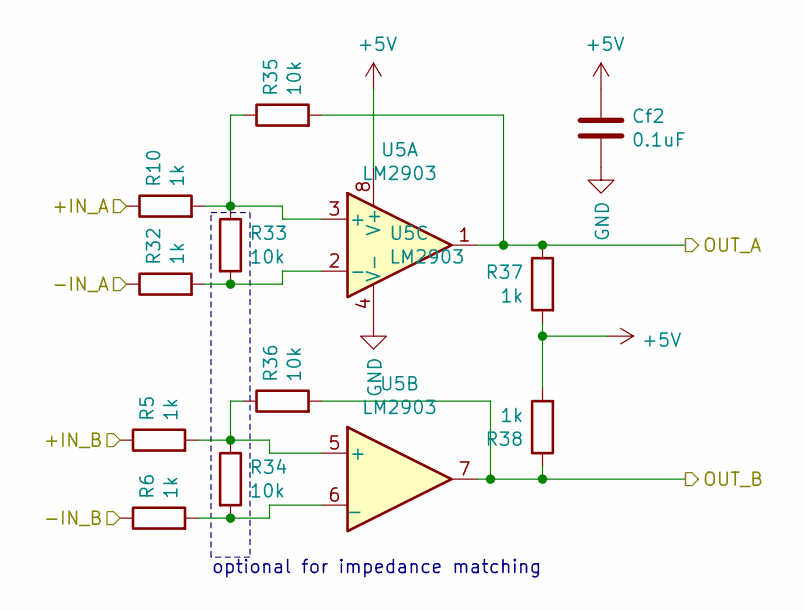
[picture p15: schematic inc_Sensor_interface.sch]

Parts:
Cf1: 0.1uF; C_0402_1005Metric
R7, R8, R9, R11, R16, R17: 1k; R_0402_1005Metric
R12, R13, R14, R15: 10k; R_0402_1005Metric
U2: LM2903; TSSOP-8_4.4x3mm_P0.65mm

Connections:
+5V: Cf1.1, R16.2, R17.2, U2.8 (V+); also elsewhere on the board
/+ENCODER0_A: R7.1; also elsewhere on the board
/+ENCODER0_B: R8.1; also elsewhere on the board
/-ENCODER0_A: R11.1; also elsewhere on the board
/-ENCODER0_B: R9.1; also elsewhere on the board
/Encoder0_A: R14.2, R16.1, U2.1; also elsewhere on the board
/Encoder0_B: R15.2, R17.1, U2.7; also elsewhere on the board
GND: Cf1.2, U2.4 (V-); also elsewhere on the board
unnamed: R11.2, R12.2, U2.2 (-)
unnamed: R7.2, R12.1, R14.1, U2.3 (+)
unnamed: R8.2, R13.1, R15.1, U2.5 (+)
unnamed: R9.2, R13.2, U2.6 (_)

Parts of its further copies:
Cf2, Cf3: 0.1uF; C_0402_1005Metric
R5, R6, R10, R32, R37, R38: 1k; R_0402_1005Metric
R33, R34, R35, R36: 10k; R_0402_1005Metric
U5: LM2903; TSSOP-8_4.4x3mm_P0.65mm

Connections of its further copies:
+5V: Cf2.1, R37.2, R38.2, U5.8 (V+); also elsewhere on the board
/+ENCODER1_A: R10.1; also elsewhere on the board
/+ENCODER1_B: R5.1; also elsewhere on the board
/-ENCODER1_A: R32.1; also elsewhere on the board
/-ENCODER1_B: R6.1; also elsewhere on the board
/Encoder1_A: R35.2, R37.1, U5.1; also elsewhere on the board
/Encoder1_B: R36.2, R38.1, U5.7; also elsewhere on the board
GND: Cf2.2, U5.4 (V-); also elsewhere on the board
unnamed: R10.2, R33.1, R35.1, U5.3 (+)
unnamed: R32.2, R33.2, U5.2 (-)
unnamed: R5.2, R34.1, R36.1, U5.5 (+)
unnamed: R6.2, R34.2, U5.6 (_)

Notes on the sheet:
optional for impedance matching

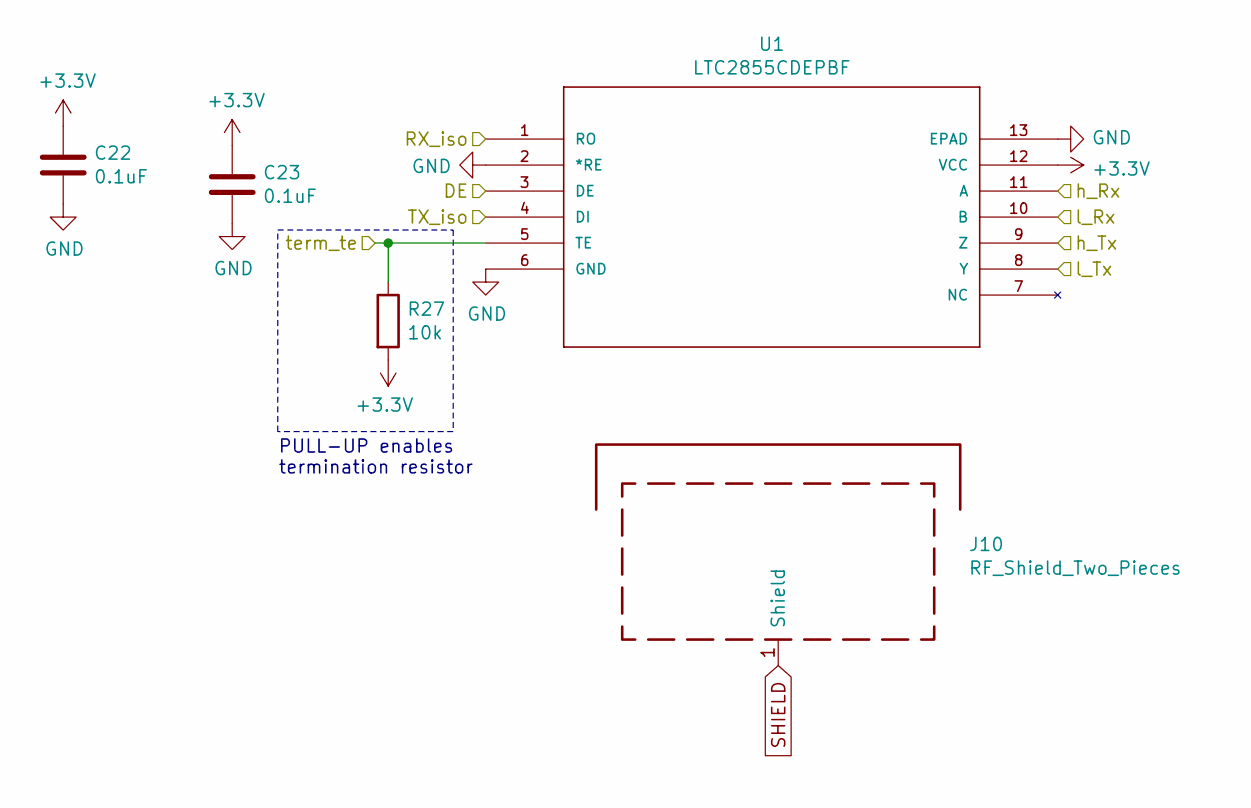
[picture p16: schematic transceiver.sch]

Parts:
C22, C23: 0.1uF; C_0402_1005Metric
J10: RF_Shield_Two_Pieces; Laird_Technologies_BMI-S-201-F_13.66x12.70mm
R27: 10k; R_0402_1005Metric
U1: LTC2855CDEPBF; ltc2855

Connections:
/DE: U1.3 (DE); also elsewhere on the board
/RX: U1.1 (RO); also elsewhere on the board
/TX: U1.4 (DI); also elsewhere on the board
/h_RX: U1.11 (A); also elsewhere on the board
/h_TX: U1.9 (Z); also elsewhere on the board
/l_RX: U1.10 (B); also elsewhere on the board
/l_TX: U1.8 (Y); also elsewhere on the board
/term_te: R27.1, U1.5 (TE); also elsewhere on the board
GND: C22.2, C23.2, U1.2 (*RE), U1.6 (GND), U1.13 (EPAD); also elsewhere on the board
SHIELD: J10.1; also elsewhere on the board

Notes on the sheet:
PULL-UP enables termination resistor

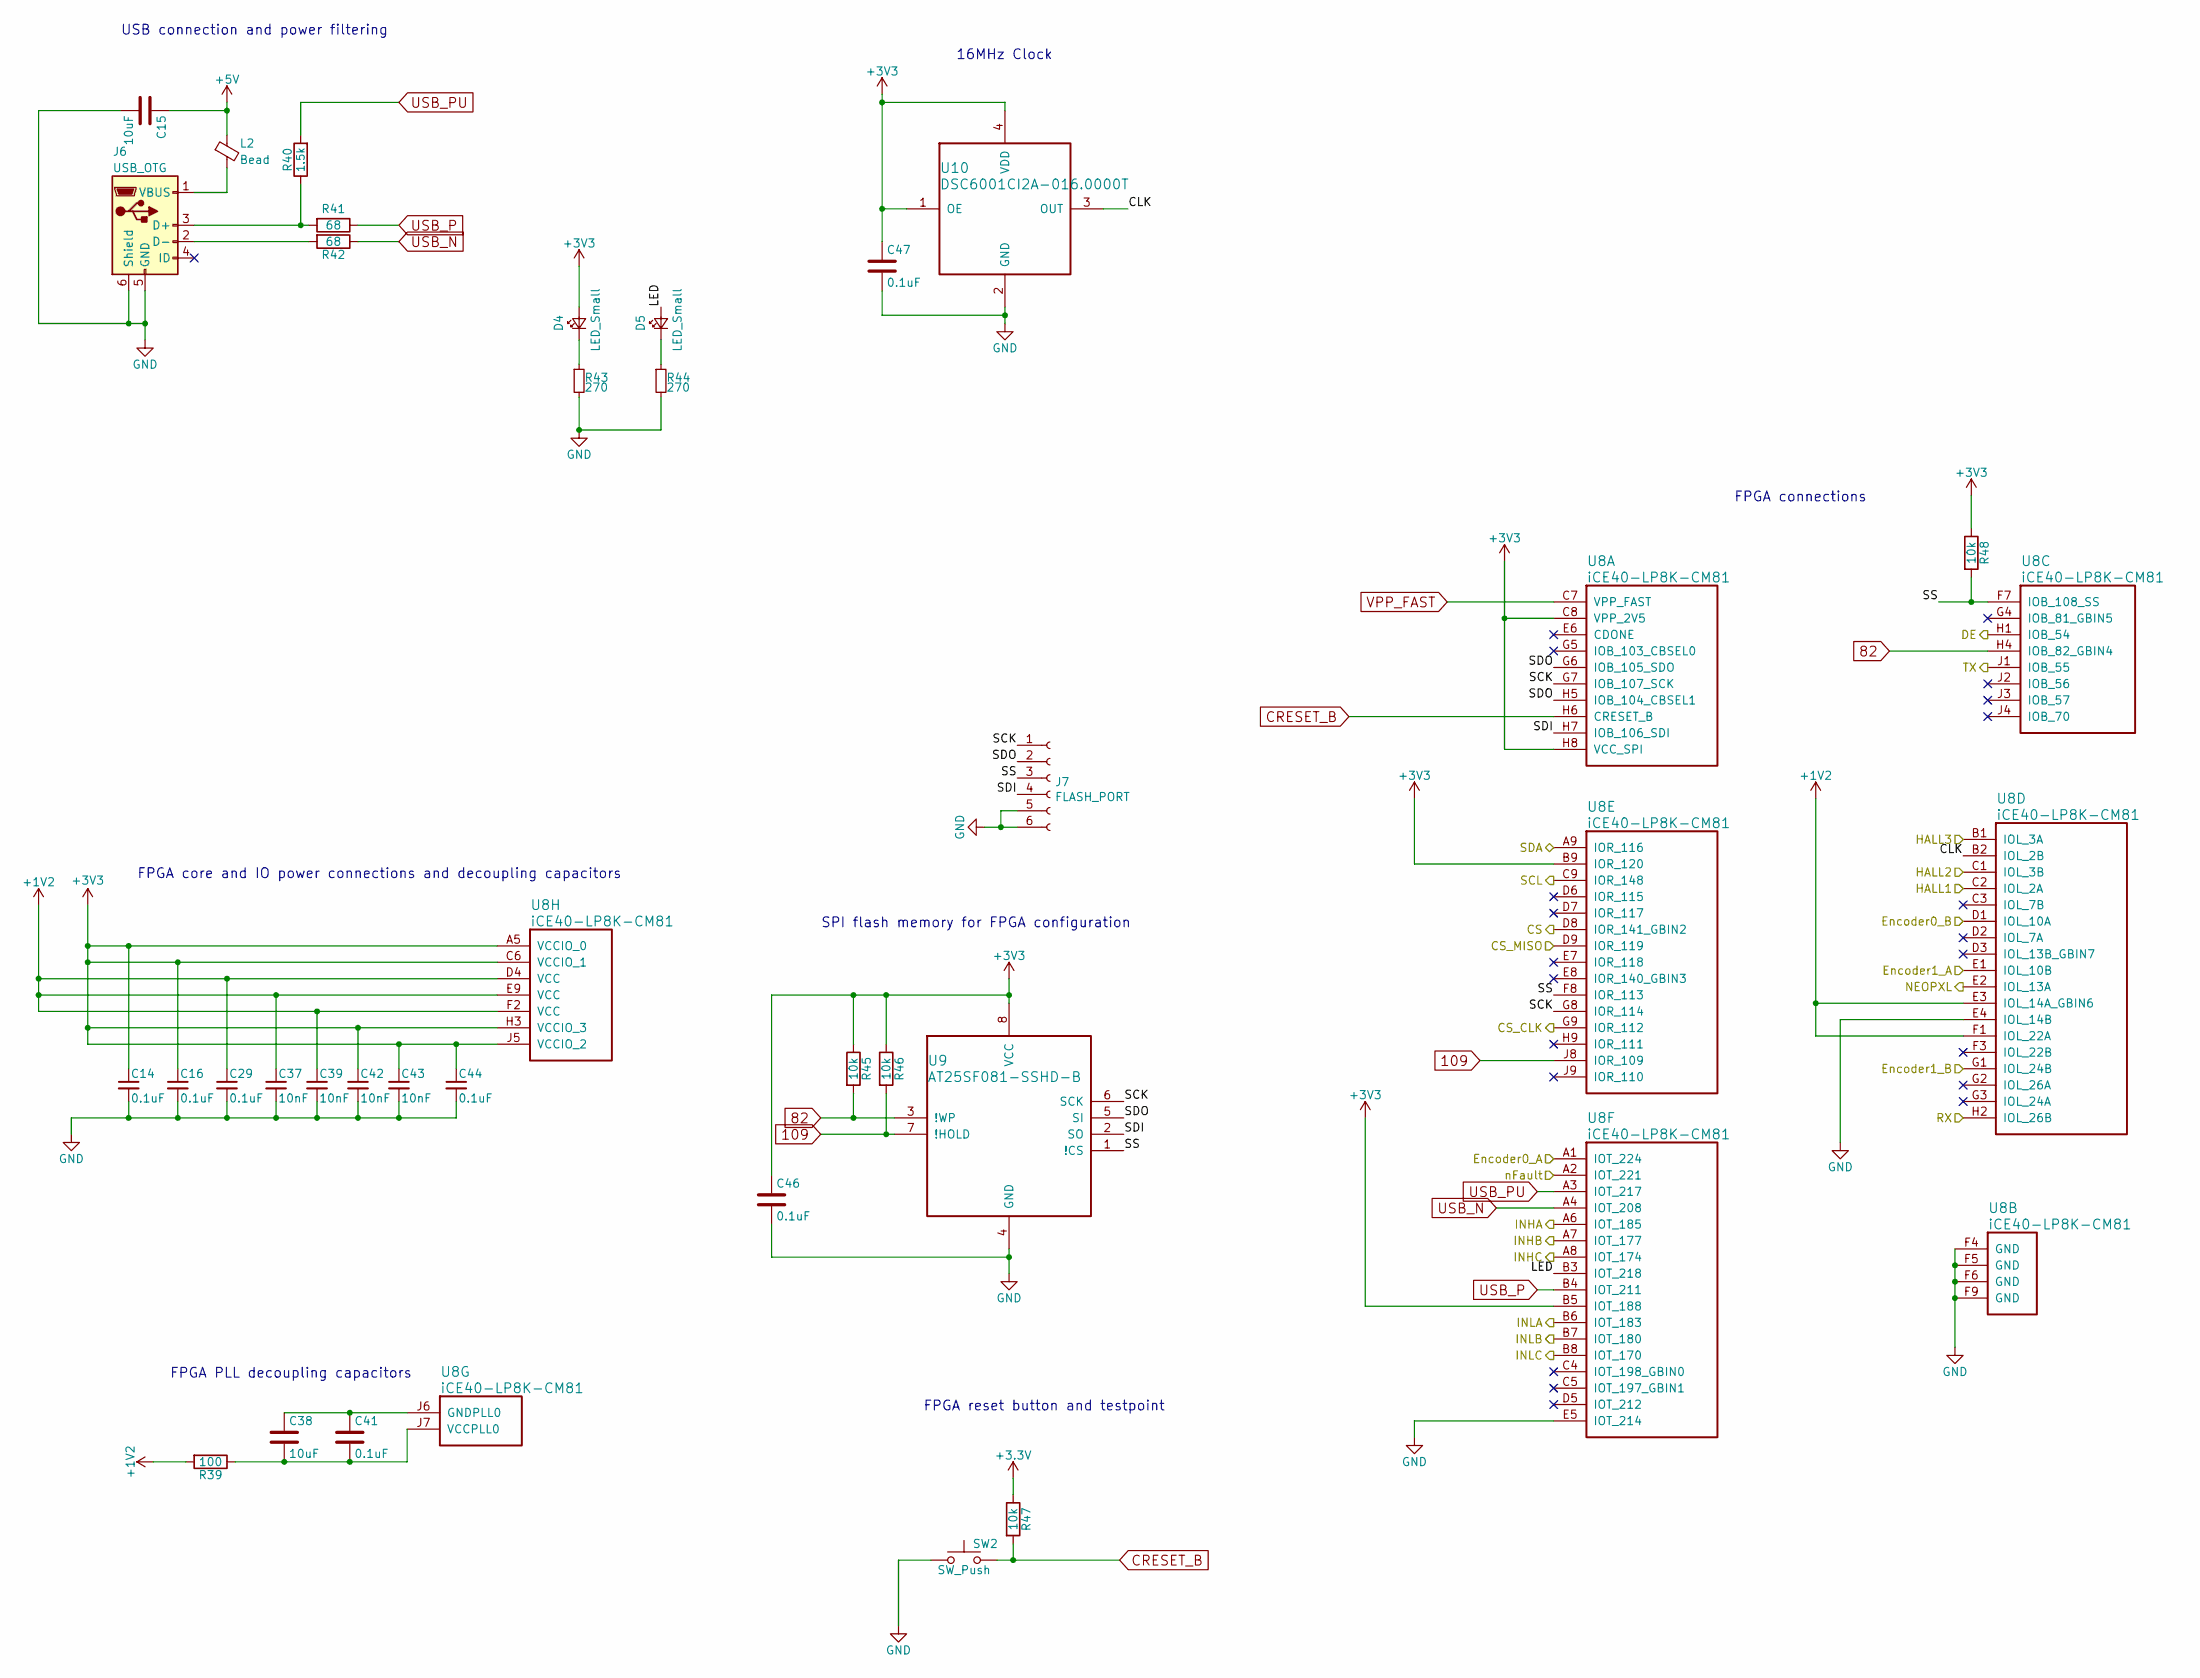
[picture p17: schematic iCE40LP.sch]

Parts:
C14, C16, C29, C41, C44, C46, C47: 0.1uF; C_0402_1005Metric
C15, C38: 10uF; C_0402_1005Metric
C37, C39, C42, C43: 10nF; C_0402_1005Metric
D4, D5: LED_Small; LED_0402_1005Metric
J6: USB_OTG; USB_Micro-B_Molex_47346-0001
J7: FLASH_PORT; TC2030-MCP-NL
L2: Bead; L_0603_1608Metric
R39: 100; R_0402_1005Metric
R40: 1.5k; R_0402_1005Metric
R41, R42: 68; R_0402_1005Metric
R43, R44: 270; R_0402_1005Metric
R45, R46, R47, R48: 10k; R_0402_1005Metric
SW2: SW_Push; PTS_810_SMT_Switch
U8: iCE40-LP8K-CM81; CM81
U9: AT25SF081-SSHD-B; SOIC-8_3.9x4.9mm_P1.27mm
U10: DSC6001CI2A-016.0000T; CDFN3225-4LD-PL-1

Connections:
82: R45.2, U8.H4 (IOB_82_GBIN4), U9.3 (!WP)
109: R46.2, U8.J8 (IOR_109), U9.7 (!HOLD)
+1V2: C29.1, C37.1, C39.1, R39.2, U8.D4 (VCC), U8.E3 (IOL_14A_GBIN6), U8.E9 (VCC), U8.F1 (IOL_22A), U8.F2 (VCC); also elsewhere on the board
+5V: C15.1, L2.1; also elsewhere on the board
/CS: U8.D8 (IOR_141_GBIN2); also elsewhere on the board
/CS_CLK: U8.G9 (IOR_112); also elsewhere on the board
/CS_MISO: U8.D9 (IOR_119); also elsewhere on the board
/DE: U8.H1 (IOB_54); also elsewhere on the board
/Encoder0_A_3.3V: U8.A1 (IOT_224); also elsewhere on the board
/Encoder0_B_3.3V: U8.D1 (IOL_10A); also elsewhere on the board
/Encoder1_A_3.3V: U8.E1 (IOL_10B); also elsewhere on the board
/Encoder1_B_3.3V: U8.G1 (IOL_24B); also elsewhere on the board
/HALL1: U8.C2 (IOL_2A); also elsewhere on the board
/HALL2: U8.C1 (IOL_3B); also elsewhere on the board
/HALL3: U8.B1 (IOL_3A); also elsewhere on the board
/INHA: U8.A6 (IOT_185); also elsewhere on the board
/INHB: U8.A7 (IOT_177); also elsewhere on the board
/INHC: U8.A8 (IOT_174); also elsewhere on the board
/INLA: U8.B6 (IOT_183); also elsewhere on the board
/INLB: U8.B7 (IOT_180); also elsewhere on the board
/INLC: U8.B8 (IOT_170); also elsewhere on the board
/NEOPXL: U8.E2 (IOL_13A); also elsewhere on the board
/RX: U8.H2 (IOL_26B); also elsewhere on the board
/SCL: U8.C9 (IOR_148); also elsewhere on the board
/SDA: U8.A9 (IOR_116); also elsewhere on the board
/TX: U8.J1 (IOB_55); also elsewhere on the board
/iCE40LP/CLK: U8.B2 (IOL_2B), U10.3 (OUT)
/iCE40LP/LED: D5.2 (A), U8.B3 (IOT_218)
/iCE40LP/SCK: J7.1, U8.G7 (IOB_107_SCK), U8.G8 (IOR_114), U9.6 (SCK)
/iCE40LP/SDI: J7.4, U8.H7 (IOB_106_SDI), U9.2 (SO)
/iCE40LP/SDO: J7.2, U8.G6 (IOB_105_SDO), U8.H5 (IOB_104_CBSEL1), U9.5 (SI)
/iCE40LP/SS: J7.3, R48.2, U8.F7 (IOB_108_SS), U8.F8 (IOR_113), U9.1 (!CS)
/nFault: U8.A2 (IOT_221); also elsewhere on the board
CRESET_B: R47.2, SW2.2, U8.H6 (CRESET_B)
GND: C14.2, C15.2, C16.2, C29.2, C37.2, C39.2, C42.2, C43.2, C44.2, C46.2, C47.2, J6.5 (GND), J6.6 (Shield), J7.5, J7.6, R43.2, R44.2, SW2.1, U8.E4 (IOL_14B), U8.E5 (IOT_214), U8.F4 (GND), U8.F5 (GND), U8.F6 (GND), U8.F9 (GND), U9.4 (GND), U10.2 (GND); also elsewhere on the board
unnamed: C38.1, C41.1, U8.J6 (GNDPLL0)
unnamed: C38.2, C41.2, R39.1, U8.J7 (VCCPLL0)
unnamed: D4.1 (K), R43.1
unnamed: D5.1 (K), R44.1
unnamed: J6.1 (VBUS), L2.2
unnamed: J6.2 (D-), R42.2
unnamed: J6.3 (D+), R40.1, R41.2
USB_N: R42.1, U8.A4 (IOT_208)
USB_P: R41.1, U8.B4 (IOT_211)
USB_PU: R40.2, U8.A3 (IOT_217)
VPP_FAST: U8.C7 (VPP_FAST)

Notes on the sheet:
FPGA core and IO power connections and decoupling capacitors
FPGA PLL decoupling capacitors
USB connection and power filtering
16MHz Clock
SPI flash memory for FPGA configuration
FPGA reset button and testpoint
FPGA connections

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
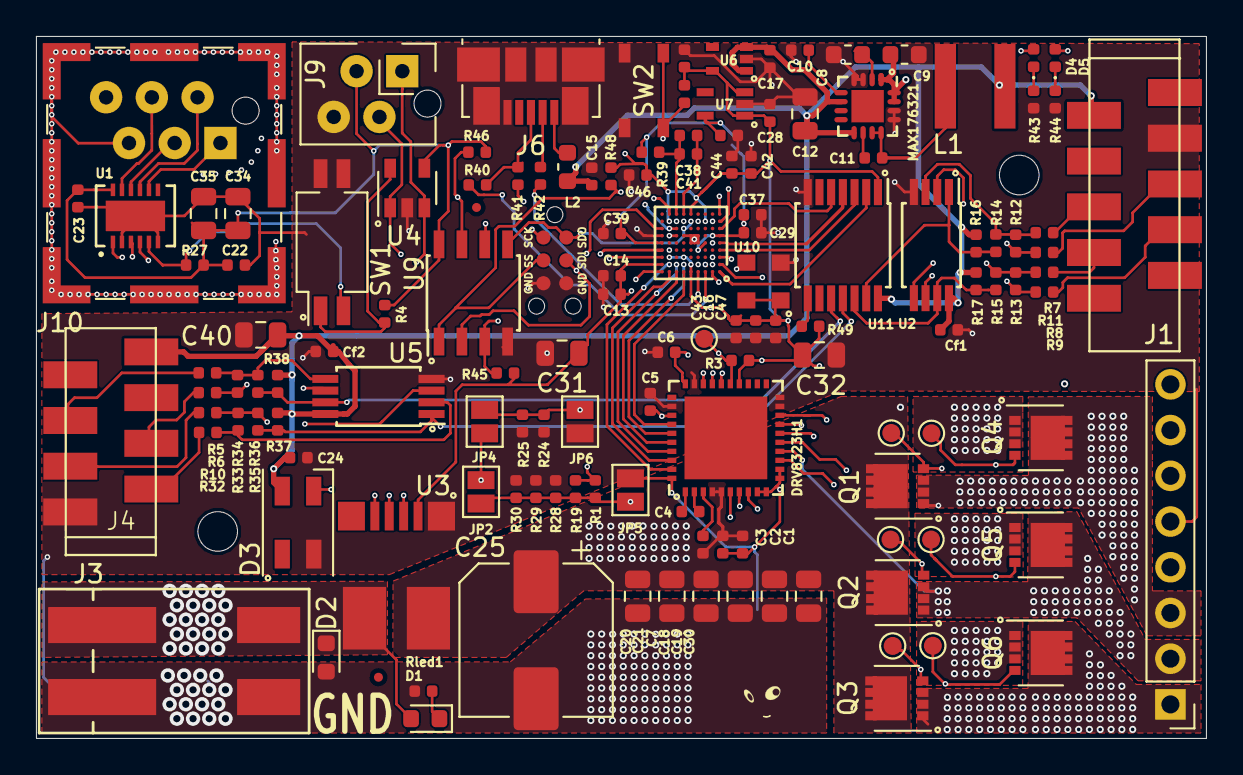
[picture p18: board board.kicad_pcb from above]

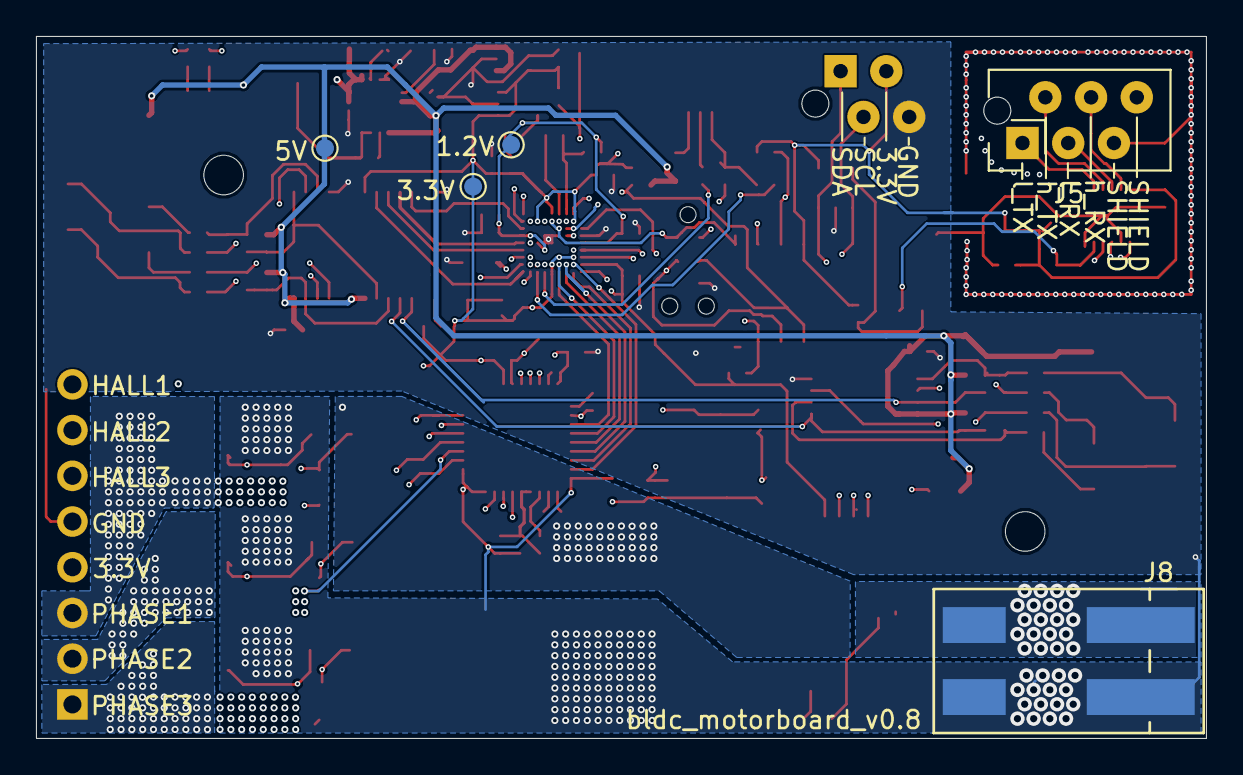
[picture p19: board board.kicad_pcb from below]

Board: 4 copper layers, 65.0 x 39.0 mm, 148 parts (5 on the bottom side), 97 nets.

Other parts of the board:
U6#2, U6#3: MIC5504-3.3YM5-TR; SC70-5

Their connections:
+5V: U6#2.1, U6#2.3, U6#3.1, U6#3.3; also elsewhere on the board
GND: U6#2.2, U6#3.2; also elsewhere on the board
unnamed 107: U6#2.4, U6#3.4; also elsewhere on the board
