Roboy/iceboard/board/rs485_adapter/rs485_adapter.kicad_pcb

## KiCad design board/rs485_adapter/rs485_adapter.kicad_pcb (2020-05-04)

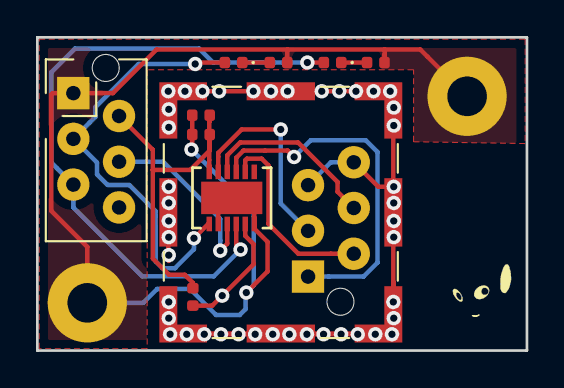
[picture p20: board rs485_adapter.kicad_pcb from above]

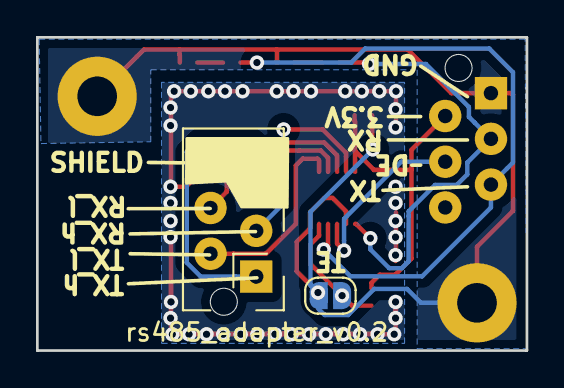
[picture p21: board rs485_adapter.kicad_pcb from below]

Board: 2 copper layers, 27.2 x 17.4 mm, 17 parts (2 on the bottom side), 13 nets.

Parts:
C1, C2: 0.1uF; C_0402_1005Metric
D1, D2: LED; LED_0402_1005Metric
H1, H2: MountingHole_Pad; MountingHole_2.2mm_M2_Pad
H3: ears; R1_ear_silk_5.5mm
H4: eyes; R1_eyes_mask_5.5mm
H5: face; R1_face_mask_5.5mm
J1: RF_Shield_Two_Pieces; Laird_Technologies_BMI-S-201-F_13.66x12.70mm
J2: uart; TE-Connectivity_Micro-Match_connector_02x03_Pitch_1.27mm
J3: diff_uart; TE-Connectivity_Micro-Match_connector_02x03_Pitch_1.27mm
JP1: SolderJumper_2_Open; SolderJumper-2_P1.3mm_Open_RoundedPad1.0x1.5mm
R1: 10k; R_0402_1005Metric
R2, R3: 1k; R_0402_1005Metric
U1: LTC2855CDEPBF; ltc2855

Connections:
+3V3: C1.1, C2.1, J2.2, R1.2, U1.12
/DE: J2.4, U1.3
/RX_iso: D2.2, J2.3, U1.1
/TX_iso: D1.2, J2.5, U1.4
/h_Rx: J3.3, U1.11
/h_Tx: J3.1, U1.9
/l_Rx: J3.4, U1.10
/l_Tx: J3.2, U1.8
/term_te: JP1.1, R1.1, U1.5
GND: C1.2, C2.2, H1.1, H2.1, J2.1, JP1.2, R2.1, R3.1, U1.2, U1.6, U1.13
unnamed: D1.1, R2.2
unnamed: D2.1, R3.2
SHIELD: J1.1, J3.5, J3.6
