Roboy/iceboard/board/rs485_usb_adapter/rs485_usb_adapter.kicad_pcb

## KiCad design board/rs485_usb_adapter/rs485_usb_adapter.kicad_pcb (2020-05-04)

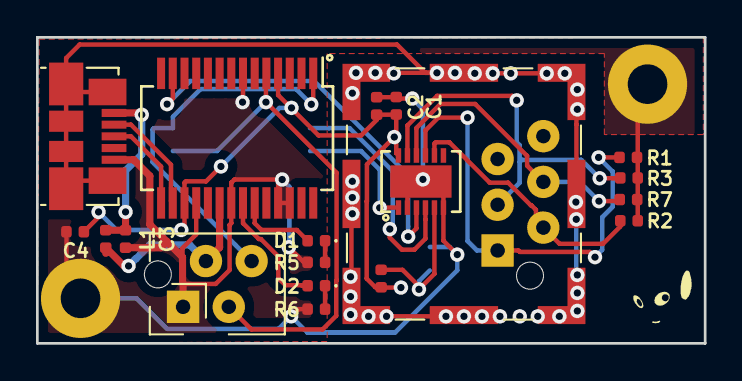
[picture p22: board rs485_usb_adapter.kicad_pcb from above]

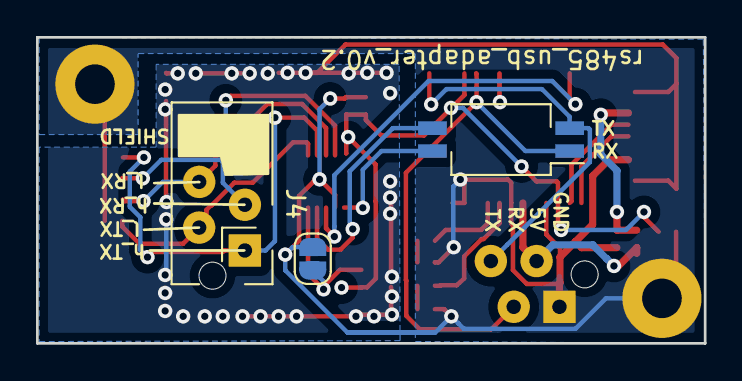
[picture p23: board rs485_usb_adapter.kicad_pcb from below]

Board: 2 copper layers, 37.1 x 17.0 mm, 27 parts (3 on the bottom side), 21 nets.

Parts:
C1, C2, C4: 0.1uF; C_0402_1005Metric
C3: 10nF; C_0402_1005Metric
D1, D2: LED; LED_0402_1005Metric
H1, H2: MountingHole_Pad; MountingHole_2.2mm_M2_Pad
H3: ears; R1_ear_silk_5.5mm
H4: eyes; R1_eyes_mask_5.5mm
H5: face; R1_face_mask_5.5mm
J1: USB_OTG; USB_Micro-B_Molex_47346-0001
J2: RF_Shield_Two_Pieces; Laird_Technologies_BMI-S-201-F_13.66x12.70mm
J3: uart; TE-Connectivity_Micro-Match_connector_02x02_Pitch_1.27mm
J4: diff_uart; TE-Connectivity_Micro-Match_connector_02x03_Pitch_1.27mm
JP1: SolderJumper_2_Open; SolderJumper-2_P1.3mm_Open_RoundedPad1.0x1.5mm
L1: Ferrite_Bead_Small; R_0402_1005Metric
R1, R2, R3, R4, R7: 10k; R_0402_1005Metric
R5, R6: 1k; R_0402_1005Metric
SW1: RS485_enable; SW_DIP_SPSTx02_Slide_Copal_CHS-02B_W7.62mm_P1.27mm
U1: LTC2855CDEPBF; ltc2855
U2: FT232RL; SSOP-28_5.3x10.2mm_P0.65mm

Connections:
+3V3: C1.1, C2.1, C4.1, R4.2, U1.12, U2.4, U2.17
+5V: J3.2, L1.1, U2.20
/DE: U1.3, U2.13
/RX_iso: J3.3, SW1.1, U2.5
/TX_iso: J3.4, SW1.2, U2.1
/USB_N: J1.2, U2.16
/USB_P: J1.3, U2.15
/h_Rx: J4.3, R3.2, U1.11
/h_Tx: J4.1, R1.2, U1.9
/l_Rx: J4.4, R7.2, U1.10
/l_Tx: J4.2, R2.2, U1.8
/term_te: JP1.1, R4.1, U1.5
GND: C1.2, C2.2, C3.2, C4.2, H1.1, H2.1, J1.5, J3.1, JP1.2, R1.1, R2.1, R3.1, R5.1, R6.1, R7.1, U1.2, U1.6, U1.13, U2.7, U2.18, U2.21, U2.25, U2.26
unnamed: C3.1, J1.1, L1.2
unnamed: D1.1, R5.2
unnamed: D1.2, U2.23
unnamed: D2.1, R6.2
unnamed: D2.2, U2.22
unnamed: SW1.3, U1.4
unnamed: SW1.4, U1.1
SHIELD: J1.6, J2.1, J4.5, J4.6
