Roboy/iceboard/board/rs422/rs422.kicad_pcb

## KiCad design board/rs422/rs422.kicad_pcb (2020-01-23)

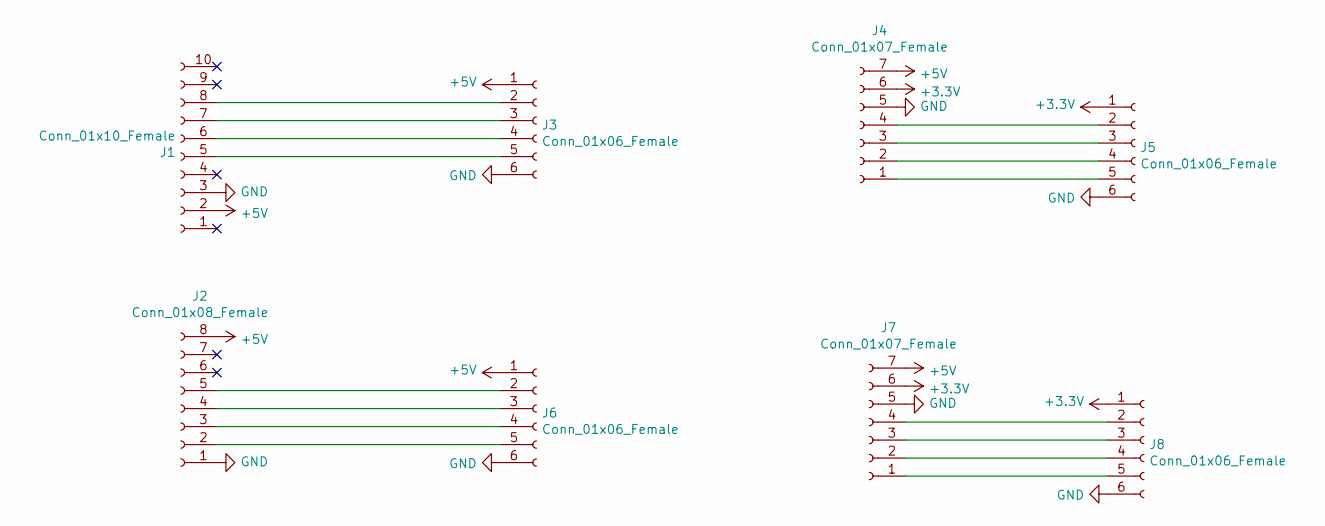
[picture p24: schematic rs422.sch]

Parts:
J1: Conn_01x10_Female; micro_match_female_10pos_SMT
J2: Conn_01x08_Female; micro_match_female_8pos_SMT
J3, J5, J6, J8: Conn_01x06_Female; PinSocket_1x06_P2.54mm_Vertical
J4, J7: Conn_01x07_Female; PinSocket_1x07_P2.54mm_Vertical

Connections:
+3V3: J4.6, J5.1, J7.6, J8.1
+5V: J1.2, J2.8, J3.1, J4.7, J6.1, J7.7
GND: J1.3, J2.1, J3.6, J4.5, J5.6, J6.6, J7.5, J8.6
unnamed: J1.5, J3.5
unnamed: J1.6, J3.4
unnamed: J1.7, J3.3
unnamed: J1.8, J3.2
unnamed: J2.2, J6.5
unnamed: J2.3, J6.4
unnamed: J2.4, J6.3
unnamed: J2.5, J6.2
unnamed: J4.1, J5.5
unnamed: J4.2, J5.4
unnamed: J4.3, J5.3
unnamed: J4.4, J5.2
unnamed: J7.1, J8.5
unnamed: J7.2, J8.4
unnamed: J7.3, J8.3
unnamed: J7.4, J8.2

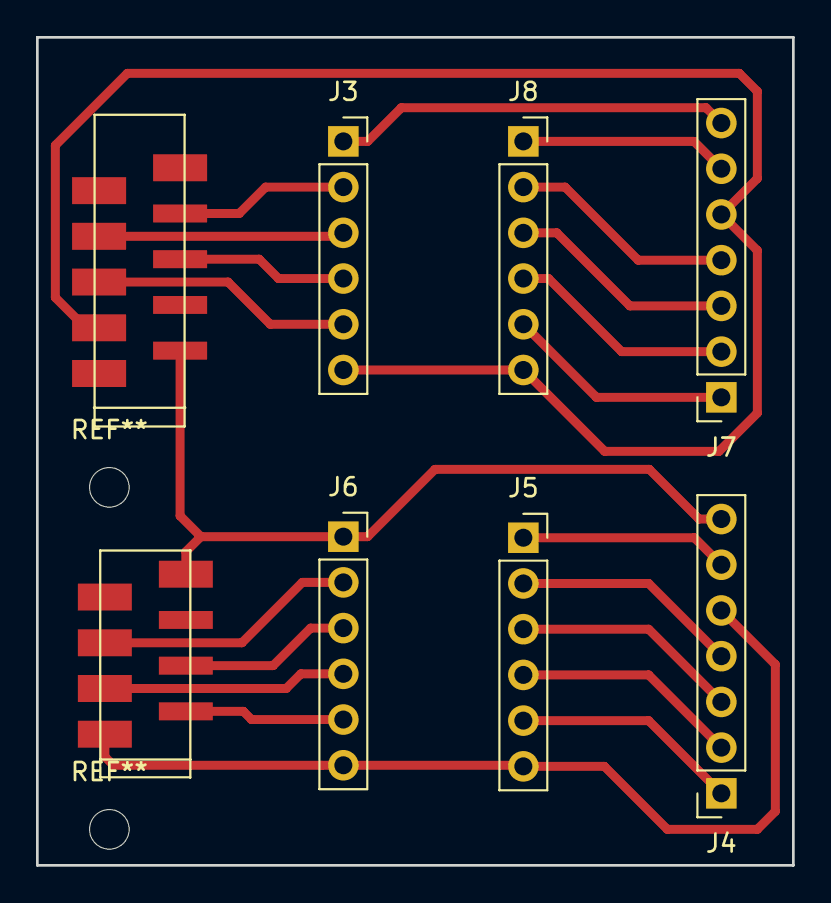
[picture p25: board rs422.kicad_pcb from above]

Board: 2 copper layers, 42.0 x 46.0 mm, 8 parts (0 on the bottom side), 19 nets.
