Roboy/iceboard/board/position_encoder/position_encoder.kicad_pcb

## KiCad design board/position_encoder/position_encoder.kicad_pcb (2019-09-22)

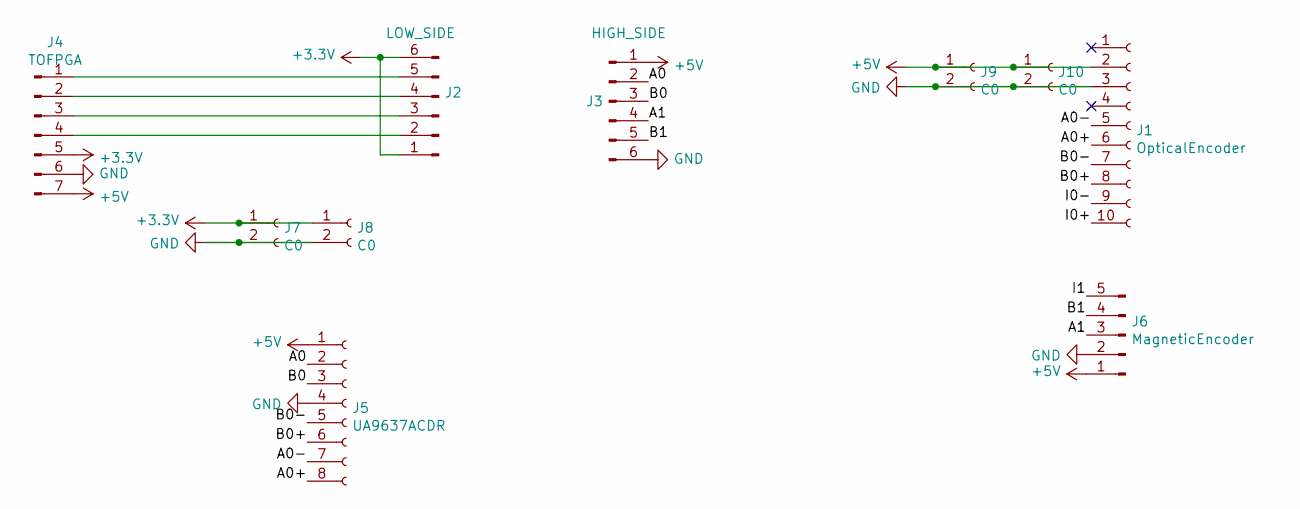
[picture p26: schematic position_encoder.sch]

Parts:
J1: OpticalEncoder; PinSocket_1x10_P2.54mm_Vertical
J2: LOW_SIDE; PinSocket_1x06_P2.54mm_Vertical
J3: HIGH_SIDE; PinSocket_1x06_P2.54mm_Vertical
J4: TOFPGA; PinSocket_1x07_P2.54mm_Vertical
J5: UA9637ACDR; SOIC-8_3.9x4.9mm_P1.27mm
J6: MagneticEncoder; PinHeader_1x05_P2.54mm_Vertical
J7, J8, J9, J10: C0; PinHeader_1x02_P2.54mm_Vertical

Connections:
+3V3: J2.1, J2.6, J4.5, J7.1, J8.1
+5V: J1.2, J3.1, J4.7, J5.1, J6.1, J9.1, J10.1
/A0: J3.2, J5.2
/A0+: J1.6, J5.8
/A0-: J1.5, J5.7
/A1: J3.4, J6.3
/B0: J3.3, J5.3
/B0+: J1.8, J5.6
/B0-: J1.7, J5.5
/B1: J3.5, J6.4
/I0+: J1.10
/I0-: J1.9
/I1: J6.5
GND: J1.3, J3.6, J4.6, J5.4, J6.2, J7.2, J8.2, J9.2, J10.2
unnamed: J2.2, J4.4
unnamed: J2.3, J4.3
unnamed: J2.4, J4.2
unnamed: J2.5, J4.1

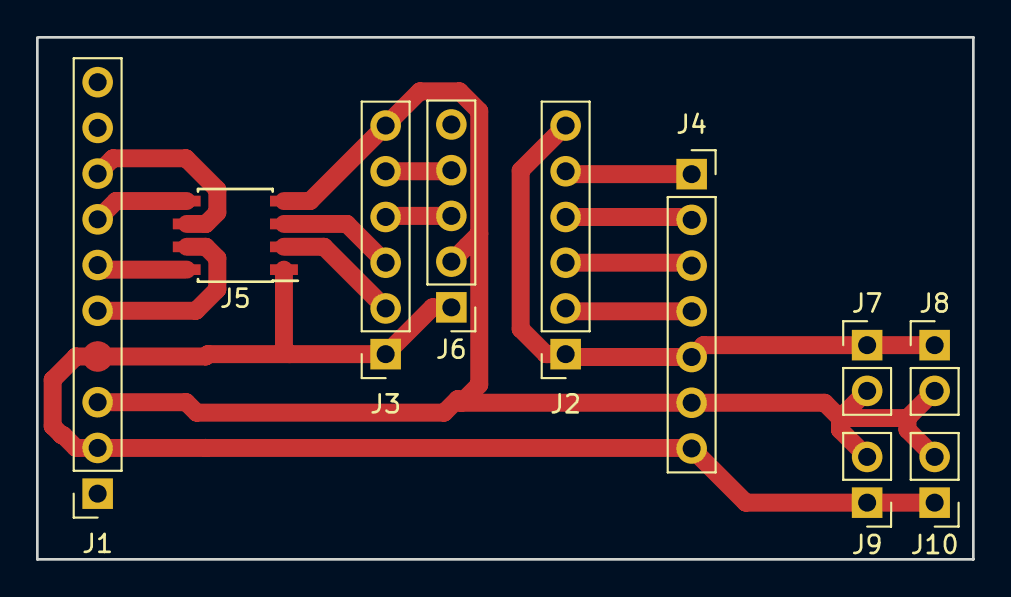
[picture p27: board position_encoder.kicad_pcb from above]

Board: 2 copper layers, 52.0 x 29.0 mm, 10 parts (0 on the bottom side), 15 nets.
