Roboy/iceboard/board/differential_uart/differential_uart.kicad_pcb

## KiCad design board/differential_uart/differential_uart.kicad_pcb (2019-09-22)

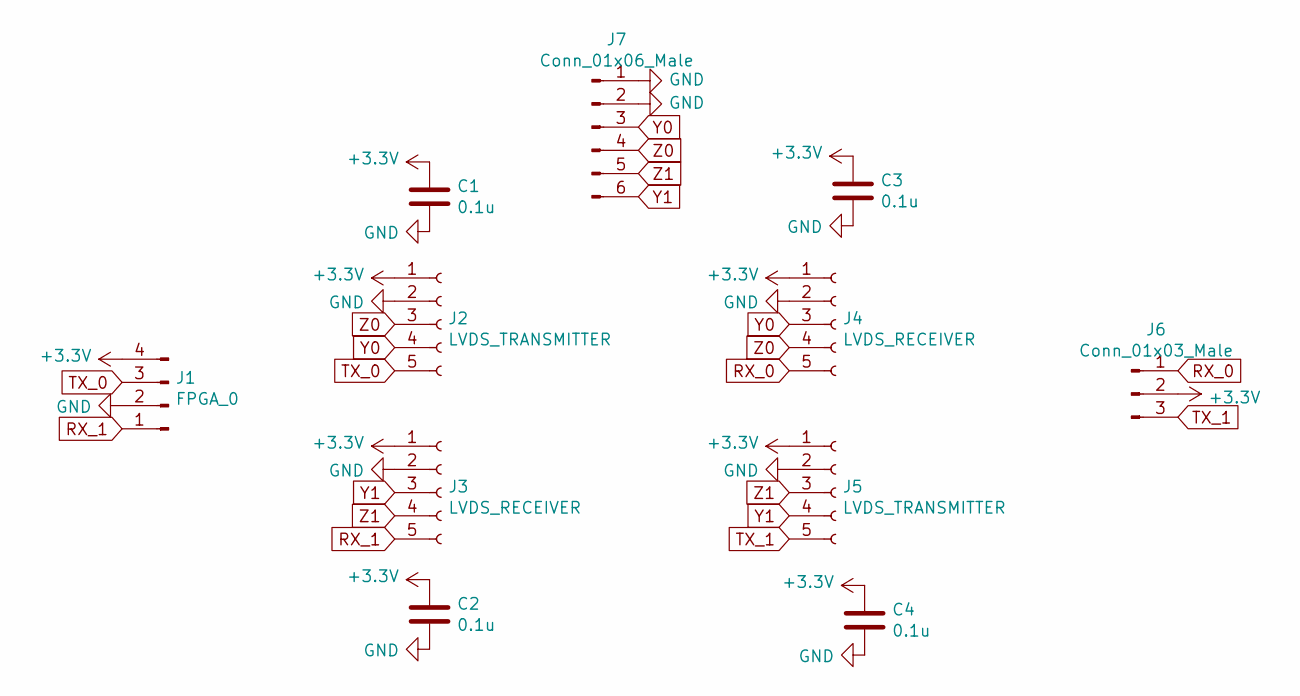
[picture p28: schematic differential_uart.sch]

Parts:
C1, C2, C3, C4: 0.1u; C_01005_0402Metric
J1: FPGA_0; PinHeader_1x04_P2.54mm_Vertical
J2, J5: LVDS_TRANSMITTER; SOT-23-5
J3, J4: LVDS_RECEIVER; SOT-23-5
J6: Conn_01x03_Male; PinHeader_1x03_P2.54mm_Vertical
J7: Conn_01x06_Male; PinHeader_1x06_P2.54mm_Vertical

Connections:
+3V3: C1.1, C2.1, C3.1, C4.1, J1.4, J2.1, J3.1, J4.1, J5.1, J6.2
GND: C1.2, C2.2, C3.2, C4.2, J1.2, J2.2, J3.2, J4.2, J5.2, J7.1, J7.2
RX_0: J4.5, J6.1
RX_1: J1.1, J3.5
TX_0: J1.3, J2.5
TX_1: J5.5, J6.3
Y0: J2.4, J4.3, J7.3
Y1: J3.3, J5.4, J7.6
Z0: J2.3, J4.4, J7.4
Z1: J3.4, J5.3, J7.5

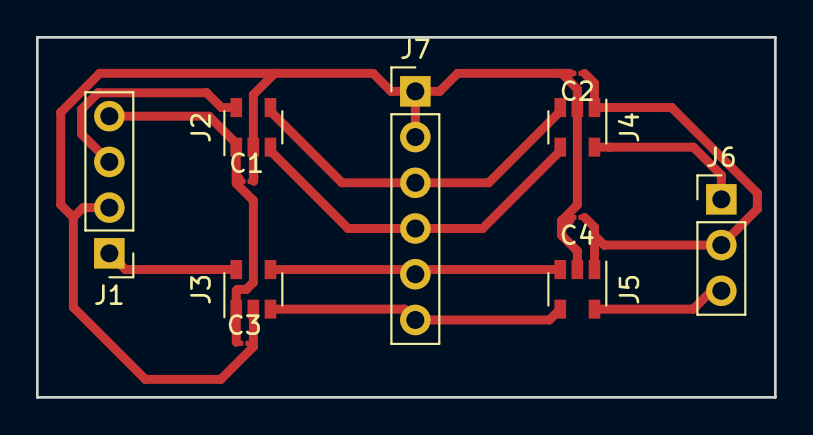
[picture p29: board differential_uart.kicad_pcb from above]

Board: 2 copper layers, 41.0 x 20.0 mm, 11 parts (0 on the bottom side), 10 nets.
