Roboy/iceboard/software/spidriver/hardware/spidriver1.kicad_pcb

## KiCad design software/spidriver/hardware/spidriver1.kicad_pcb (2020-01-23)

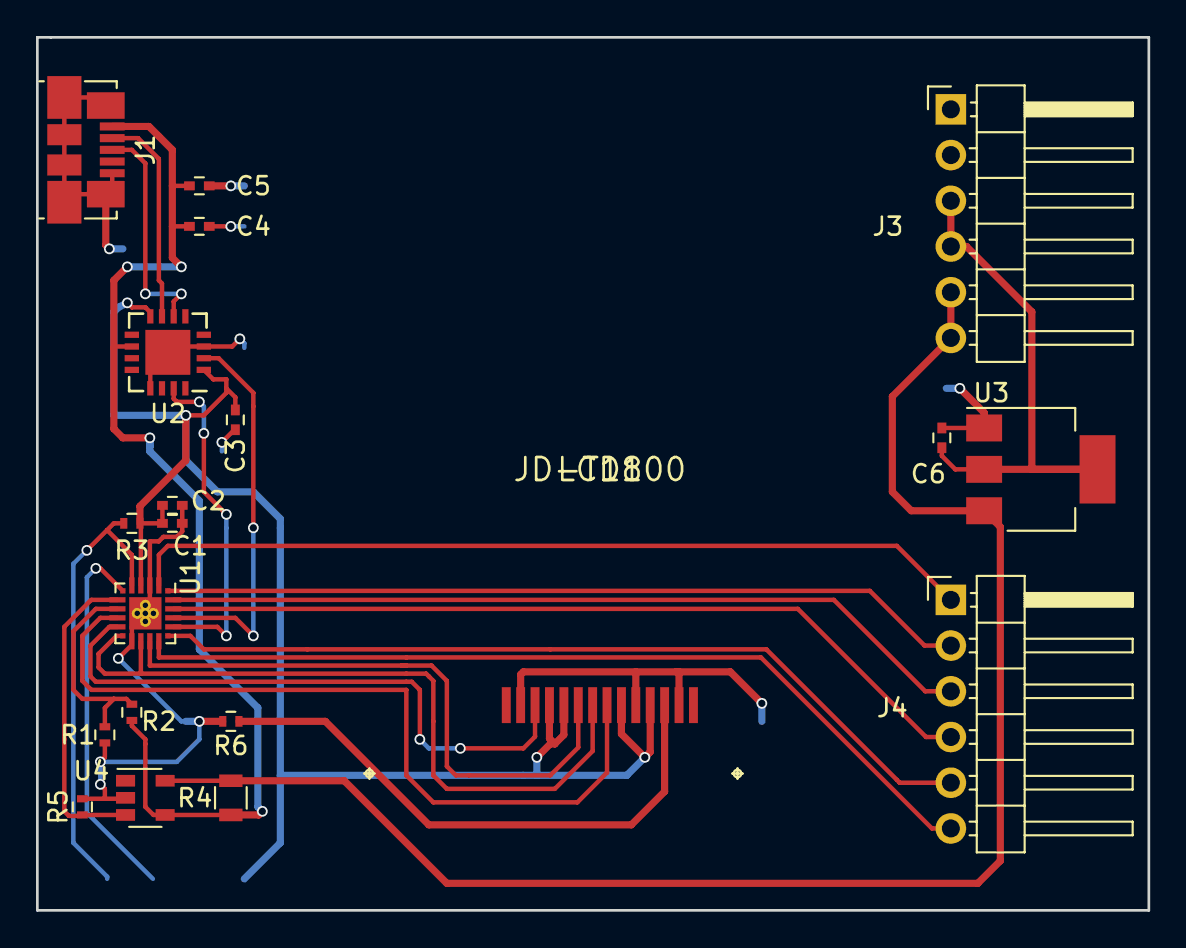
[picture p30: board spidriver1.kicad_pcb from above]

Board: 2 copper layers, 61.8 x 48.5 mm, 21 parts (1 on the bottom side), 24 nets.

Parts:
C1, C3, C4, C6: 0.1uF; C_0402
C2: 1uF; C_0402
C5: 10uF; C_0402
J1: USB_OTG; USB_Micro-B_Molex_47346-0001
J2: Conn_01x04_Male; POGO4
J3, J4: Conn_01x06_Male; Pin_Header_Angled_1x06_Pitch2.54mm
LCD1: JD-T1800
R1: 1180; R_0402
R2: 1000; R_0402
R3: 1K; R_0402
R4: .1; R_0805
R5: 12K; R_0402
R6: 22; R_0402
U1: EFM8BB10F8G-A-QFN20; SiliconLabs_QFN-20-1EP_3x3mm_Pitch0.5mm_ThermalVias
U2: FT230XQ; QFN-16-1EP_4x4mm_Pitch0.65mm
U3: AP1117-15; SOT-223-3Lead_TabPin2
U4: ZXCT1110; SOT-23-5

Connections:
3.3V: C1.1, C2.1, C3.1, J2.1, LCD1.4, LCD1.6, LCD1.10, LCD1.11, R3.2, U1.4, U2.1, U2.8
3.3VB: C6.1, J3.3, J3.4, U3.2
5V: C4.1, C5.1, J1.1, R1.1, R4.1, U2.10, U4.4
5VB: J3.5, J3.6, R4.2, U3.3, U4.5
GND: C1.2, C2.2, C3.2, C4.2, C5.2, C6.2, J1.5, J1.6, J2.2, J3.1, J3.2, LCD1.2, LCD1.5, LCD1.13, R2.2, R5.2, R6.2, U1.3, U1.12, U1.21, U2.3, U2.13, U2.17, U3.1, U4.2
unnamed: R1.2, R2.1, U1.8
unnamed: J2.4, R3.1, U1.5
unnamed: U1.18, U2.2
unnamed: U1.17, U2.15
unnamed: R5.1, U1.7, U4.3
unnamed: J2.3, U1.6
unnamed: J4.1, U1.2
unnamed: J4.2, U1.1
unnamed: J4.3, U1.20
unnamed: J4.4, U1.19
unnamed: J4.5, U1.16
unnamed: J4.6, U1.15
unnamed: LCD1.9, U1.14
unnamed: LCD1.8, U1.11, U1.13
unnamed: LCD1.12, U1.10
unnamed: LCD1.7, U1.9
unnamed: LCD1.3, R6.1
unnamed: J1.3, U2.6
unnamed: J1.2, U2.7
