Roboy/iceboard/software/spidriver/flashtest/flashtest.brd

## EAGLE design software/spidriver/flashtest/flashtest.brd (2020-01-23)

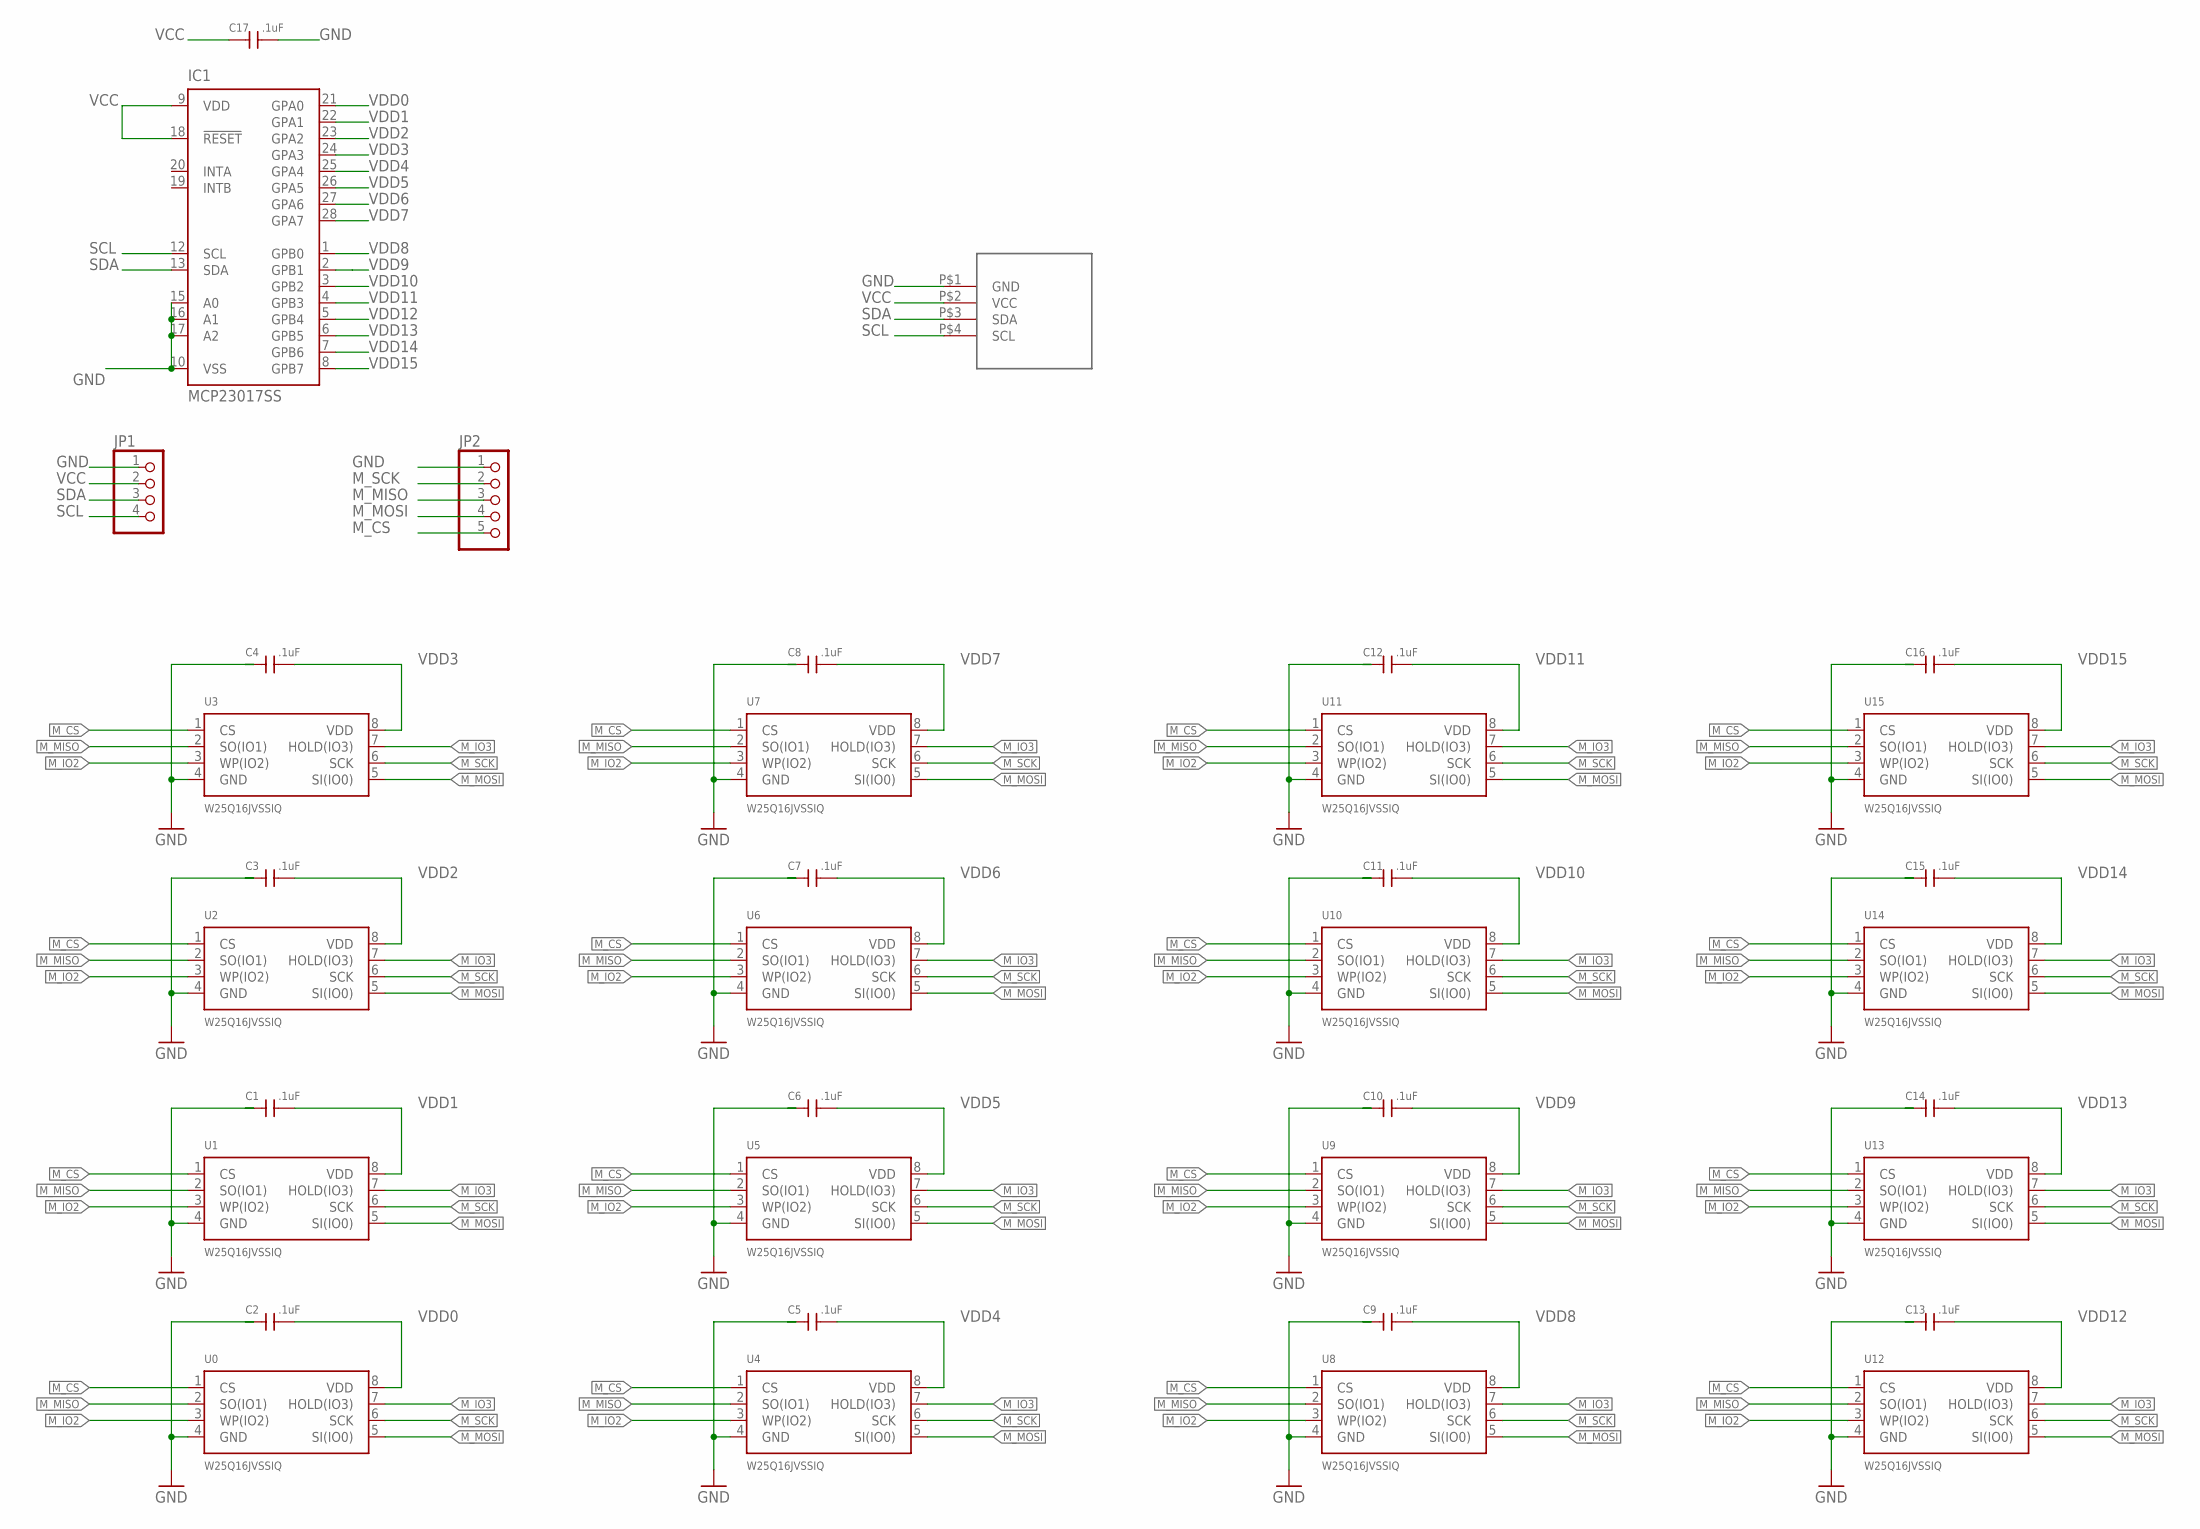
[picture p31: schematic flashtest.sch]

Parts:
C1, C2, C3, C4, C5, C6, C7, C8, C9, C10, C11, C12, C13, C14, C15, C16, C17: .1uF; 0603@1
IC1: MCP23017SS; SSOP28
JP1: PINHD-1X4; 1X04
JP2: PINHD-1X5; 1X05
U0, U1, U2, U3, U4, U5, U6, U7, U8, U9, U10, U11, U12, U13, U14, U15: W25Q16JVSSIQ; SOIC-8
U$1: I2C

Connections:
GND: C1.1, C2.1, C3.1, C4.1, C5.1, C6.1, C7.1, C8.1, C9.1, C10.1, C11.1, C12.1, C13.1, C14.1, C15.1, C16.1, C17.2, IC1.10 (VSS), IC1.15 (A0), IC1.16 (A1), IC1.17 (A2), JP1.1, JP2.1, U0.4 (GND), U1.4 (GND), U2.4 (GND), U3.4 (GND), U4.4 (GND), U5.4 (GND), U6.4 (GND), U7.4 (GND), U8.4 (GND), U9.4 (GND), U10.4 (GND), U11.4 (GND), U12.4 (GND), U13.4 (GND), U14.4 (GND), U15.4 (GND), U$1.P$1 (GND)
M_CS: JP2.5, U0.1 (CS), U1.1 (CS), U2.1 (CS), U3.1 (CS), U4.1 (CS), U5.1 (CS), U6.1 (CS), U7.1 (CS), U8.1 (CS), U9.1 (CS), U10.1 (CS), U11.1 (CS), U12.1 (CS), U13.1 (CS), U14.1 (CS), U15.1 (CS)
M_IO2: U0.3 (WP(IO2)), U1.3 (WP(IO2)), U2.3 (WP(IO2)), U3.3 (WP(IO2)), U4.3 (WP(IO2)), U5.3 (WP(IO2)), U6.3 (WP(IO2)), U7.3 (WP(IO2)), U8.3 (WP(IO2)), U9.3 (WP(IO2)), U10.3 (WP(IO2)), U11.3 (WP(IO2)), U12.3 (WP(IO2)), U13.3 (WP(IO2)), U14.3 (WP(IO2)), U15.3 (WP(IO2))
M_IO3: U0.7 (HOLD(IO3)), U1.7 (HOLD(IO3)), U2.7 (HOLD(IO3)), U3.7 (HOLD(IO3)), U4.7 (HOLD(IO3)), U5.7 (HOLD(IO3)), U6.7 (HOLD(IO3)), U7.7 (HOLD(IO3)), U8.7 (HOLD(IO3)), U9.7 (HOLD(IO3)), U10.7 (HOLD(IO3)), U11.7 (HOLD(IO3)), U12.7 (HOLD(IO3)), U13.7 (HOLD(IO3)), U14.7 (HOLD(IO3)), U15.7 (HOLD(IO3))
M_MISO: JP2.3, U0.2 (SO(IO1)), U1.2 (SO(IO1)), U2.2 (SO(IO1)), U3.2 (SO(IO1)), U4.2 (SO(IO1)), U5.2 (SO(IO1)), U6.2 (SO(IO1)), U7.2 (SO(IO1)), U8.2 (SO(IO1)), U9.2 (SO(IO1)), U10.2 (SO(IO1)), U11.2 (SO(IO1)), U12.2 (SO(IO1)), U13.2 (SO(IO1)), U14.2 (SO(IO1)), U15.2 (SO(IO1))
M_MOSI: JP2.4, U0.5 (SI(IO0)), U1.5 (SI(IO0)), U2.5 (SI(IO0)), U3.5 (SI(IO0)), U4.5 (SI(IO0)), U5.5 (SI(IO0)), U6.5 (SI(IO0)), U7.5 (SI(IO0)), U8.5 (SI(IO0)), U9.5 (SI(IO0)), U10.5 (SI(IO0)), U11.5 (SI(IO0)), U12.5 (SI(IO0)), U13.5 (SI(IO0)), U14.5 (SI(IO0)), U15.5 (SI(IO0))
M_SCK: JP2.2, U0.6 (SCK), U1.6 (SCK), U2.6 (SCK), U3.6 (SCK), U4.6 (SCK), U5.6 (SCK), U6.6 (SCK), U7.6 (SCK), U8.6 (SCK), U9.6 (SCK), U10.6 (SCK), U11.6 (SCK), U12.6 (SCK), U13.6 (SCK), U14.6 (SCK), U15.6 (SCK)
SCL: IC1.12 (SCL), JP1.4, U$1.P$4 (SCL)
SDA: IC1.13 (SDA), JP1.3, U$1.P$3 (SDA)
VCC: C17.1, IC1.9 (VDD), IC1.18 (!RESET), JP1.2, U$1.P$2 (VCC)
VDD0: C2.2, IC1.21 (GPA0), U0.8 (VDD)
VDD1: C1.2, IC1.22 (GPA1), U1.8 (VDD)
VDD2: C3.2, IC1.23 (GPA2), U2.8 (VDD)
VDD3: C4.2, IC1.24 (GPA3), U3.8 (VDD)
VDD4: C5.2, IC1.25 (GPA4), U4.8 (VDD)
VDD5: C6.2, IC1.26 (GPA5), U5.8 (VDD)
VDD6: C7.2, IC1.27 (GPA6), U6.8 (VDD)
VDD7: C8.2, IC1.28 (GPA7), U7.8 (VDD)
VDD8: C9.2, IC1.1 (GPB0), U8.8 (VDD)
VDD9: C10.2, IC1.2 (GPB1), U9.8 (VDD)
VDD10: C11.2, IC1.3 (GPB2), U10.8 (VDD)
VDD11: C12.2, IC1.4 (GPB3), U11.8 (VDD)
VDD12: C13.2, IC1.5 (GPB4), U12.8 (VDD)
VDD13: C14.2, IC1.6 (GPB5), U13.8 (VDD)
VDD14: C15.2, IC1.7 (GPB6), U14.8 (VDD)
VDD15: C16.2, IC1.8 (GPB7), U15.8 (VDD)

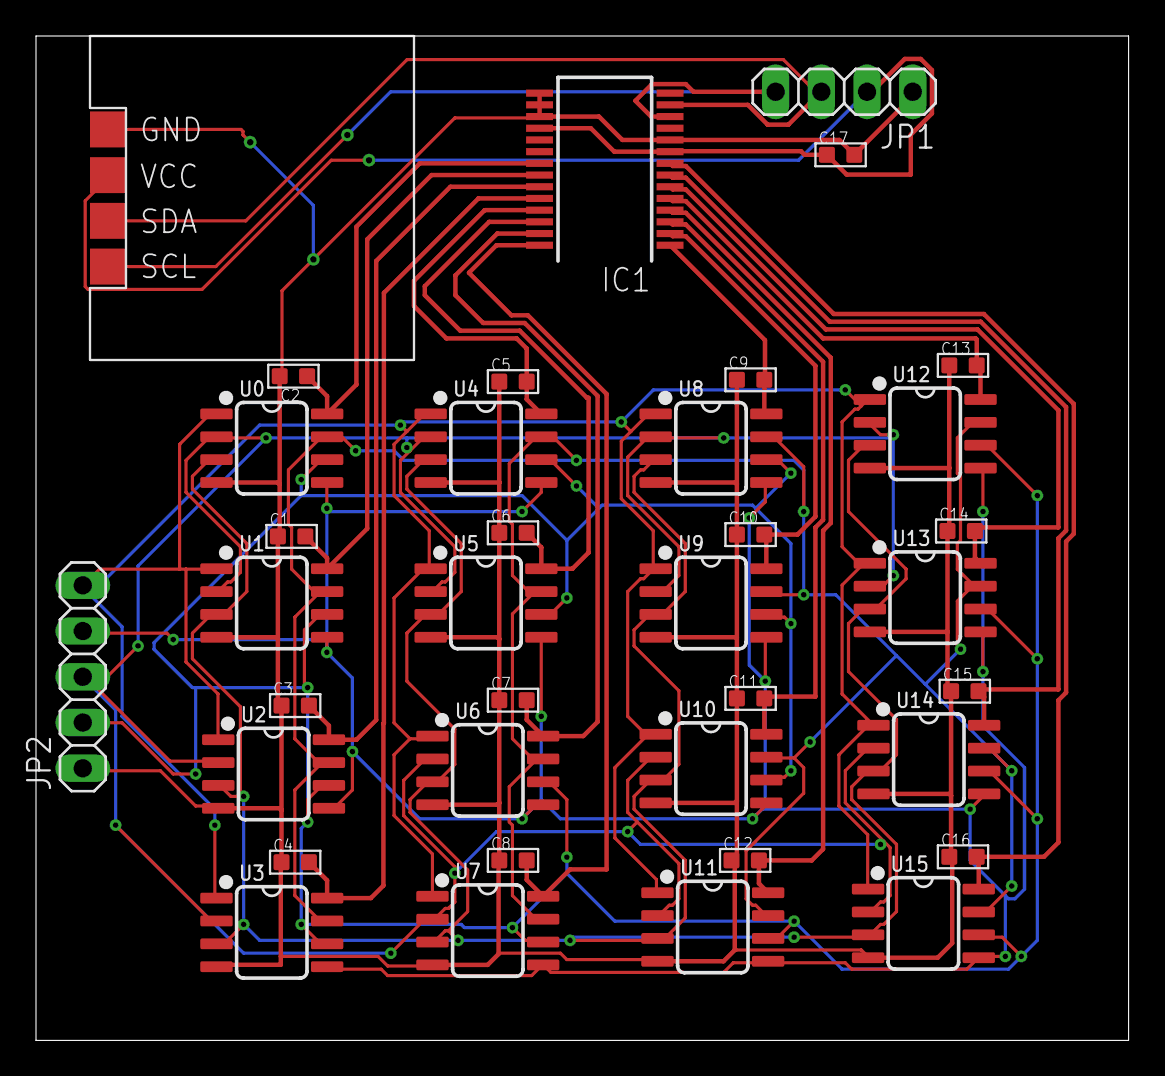
[picture p32: board flashtest.brd from above]

Board: 2 copper layers, 60.7 x 55.8 mm, 37 parts (0 on the bottom side), 26 nets.
