Roboy/iceboard/software/adc_lvds/top_prim.v

// Verilog netlist produced by program LSE :  version Diamond Version 0.0.0
// Netlist written on Sun Aug 25 21:33:58 2019
//
// Verilog Description of module top
//

module top (CLK, LED, USBPU, PIN_1, PIN_2, PIN_3, PIN_4, PIN_5, 
            PIN_6, PIN_7, PIN_8, PIN_9, PIN_10, PIN_11, PIN_12, 
            PIN_13, PIN_14, PIN_15, PIN_16, PIN_17, PIN_18, PIN_19, 
            PIN_20, PIN_21, PIN_22, PIN_23, PIN_24) /* synthesis syn_preserve=0, syn_noprune=0, syn_module_defined=1 */ ;   // verilog/TinyFPGA_B.v(2[8:11])
    input CLK;   // verilog/TinyFPGA_B.v(3[9:12])
    output LED;   // verilog/TinyFPGA_B.v(4[10:13])
    output USBPU;   // verilog/TinyFPGA_B.v(5[10:15])
    output PIN_1 /* synthesis .original_dir=IN_OUT */ ;   // verilog/TinyFPGA_B.v(6[9:14])
    input PIN_2 /* synthesis .original_dir=IN_OUT */ ;   // verilog/TinyFPGA_B.v(7[9:14])
    output PIN_3 /* synthesis .original_dir=IN_OUT */ ;   // verilog/TinyFPGA_B.v(8[9:14])
    input PIN_4 /* synthesis .original_dir=IN_OUT */ ;   // verilog/TinyFPGA_B.v(9[9:14])
    input PIN_5 /* synthesis .original_dir=IN_OUT */ ;   // verilog/TinyFPGA_B.v(10[9:14])
    input PIN_6 /* synthesis .original_dir=IN_OUT */ ;   // verilog/TinyFPGA_B.v(11[9:14])
    input PIN_7 /* synthesis .original_dir=IN_OUT */ ;   // verilog/TinyFPGA_B.v(12[9:14])
    input PIN_8 /* synthesis .original_dir=IN_OUT */ ;   // verilog/TinyFPGA_B.v(13[9:14])
    input PIN_9 /* synthesis .original_dir=IN_OUT */ ;   // verilog/TinyFPGA_B.v(14[9:14])
    input PIN_10 /* synthesis .original_dir=IN_OUT */ ;   // verilog/TinyFPGA_B.v(15[9:15])
    input PIN_11 /* synthesis .original_dir=IN_OUT */ ;   // verilog/TinyFPGA_B.v(16[9:15])
    input PIN_12 /* synthesis .original_dir=IN_OUT */ ;   // verilog/TinyFPGA_B.v(17[9:15])
    input PIN_13 /* synthesis .original_dir=IN_OUT */ ;   // verilog/TinyFPGA_B.v(18[9:15])
    input PIN_14 /* synthesis .original_dir=IN_OUT */ ;   // verilog/TinyFPGA_B.v(19[9:15])
    input PIN_15 /* synthesis .original_dir=IN_OUT */ ;   // verilog/TinyFPGA_B.v(20[9:15])
    input PIN_16 /* synthesis .original_dir=IN_OUT */ ;   // verilog/TinyFPGA_B.v(21[9:15])
    input PIN_17 /* synthesis .original_dir=IN_OUT */ ;   // verilog/TinyFPGA_B.v(22[9:15])
    input PIN_18 /* synthesis .original_dir=IN_OUT */ ;   // verilog/TinyFPGA_B.v(23[9:15])
    input PIN_19 /* synthesis .original_dir=IN_OUT */ ;   // verilog/TinyFPGA_B.v(24[9:15])
    input PIN_20 /* synthesis .original_dir=IN_OUT */ ;   // verilog/TinyFPGA_B.v(25[9:15])
    input PIN_21 /* synthesis .original_dir=IN_OUT */ ;   // verilog/TinyFPGA_B.v(26[9:15])
    input PIN_22 /* synthesis .original_dir=IN_OUT */ ;   // verilog/TinyFPGA_B.v(27[9:15])
    input PIN_23 /* synthesis .original_dir=IN_OUT */ ;   // verilog/TinyFPGA_B.v(28[9:15])
    input PIN_24 /* synthesis .original_dir=IN_OUT */ ;   // verilog/TinyFPGA_B.v(29[9:15])
    
    wire CLK_c /* synthesis SET_AS_NETWORK=CLK_c, is_clock=1 */ ;   // verilog/TinyFPGA_B.v(3[9:12])
    
    wire GND_net, VCC_net, LED_c, PIN_1_c, PIN_2_c, PIN_3_c;
    wire [25:0]blink_counter;   // verilog/TinyFPGA_B.v(39[14:27])
    
    wire n10, n9, n8, n7, n6, n1864, n1874;
    wire [7:0]\data_out[7] ;   // coms.v(13[12:20])
    wire [7:0]\data_out[6] ;   // coms.v(13[12:20])
    
    wire data_out_field_43, data_out_field_34, data_out_field_31, data_out_field_30, 
        data_out_field_29, data_out_field_28, data_out_field_27, data_out_field_26, 
        data_out_field_25, data_out_field_24, data_out_field_23, data_out_field_22, 
        data_out_field_21, data_out_field_20, data_out_field_19, data_out_field_18, 
        data_out_field_17, data_out_field_16, data_out_field_15, data_out_field_14, 
        data_out_field_13, data_out_field_12, data_out_field_11, data_out_field_10, 
        data_out_field_9, data_out_field_8, data_out_field_7, data_out_field_6, 
        data_out_field_5, data_out_field_4, data_out_field_3, data_out_field_2, 
        data_out_field_1, data_out_field_0, rx_data_ready_keep, n1882_adj_917, 
        n1884_adj_918, n1886_adj_919, n1888_adj_920, n1890_adj_921, 
        n1892_adj_922, n1894_adj_923;
    wire [7:0]\data_in[7] ;   // coms.v(143[13:20])
    wire [7:0]\data_in[6] ;   // coms.v(143[13:20])
    wire [7:0]\data_in[5] ;   // coms.v(143[13:20])
    wire [7:0]\data_in[4] ;   // coms.v(143[13:20])
    wire [7:0]\data_in[3] ;   // coms.v(143[13:20])
    wire [7:0]\data_in[2] ;   // coms.v(143[13:20])
    wire [7:0]\data_in[1] ;   // coms.v(143[13:20])
    wire [7:0]\data_in[0] ;   // coms.v(143[13:20])
    
    wire n607, n21, n13;
    wire [7:0]i_Tx_Byte;   // roboy_fpga_code/roboy_fpga_code/uart/uart_tx.v(18[16:25])
    
    wire n3848, n4331, n2030, n2029, n2028, n2027, n2026, n2025, 
        n2024, n2023, n2022, n2021, n2020, n2019, n2018, n2017, 
        n2016, n2015, n2014, n2013, n2012, n2011, n2010, n2009, 
        n2008, n2007, n2006, n2005, n2004, n2003, n2002, n2001, 
        n2000, n1999, n1998, n1997, n1996, n1995, n1994, n1993, 
        n1992, n1991, n1990, n1989, n1988, n1987, n1986, n1985, 
        n1984, n1983, n1982, n1981, n1980, n1979, n1978, n1977, 
        n1976, n1975, n1974, n1973, n1972, n1971, n1970, n1969, 
        n1968, n3847, n1965, n1964, n1963, n1962, n1961, n1960, 
        n1959, n1940, n1939, n1938, n1936, n1935, n1932, n1291, 
        n1906, n1905, n1904, n1903, n1902, n1300, n1901, n1900, 
        n1899, n1898, n1897, n1896, n1895, n1894, n1893, n1892, 
        n1891, n1890, n1889, n1888, n1887, n1886, n1843, n1867, 
        n1801, n1800, n1799, n1797, n1796, n1795, n1793, n1792, 
        n1789, n1788, n4322, n26, n3846, n114, n1868, n115, 
        n3845, n1869, n1870, n3, n117, n1862, n3844, n1871, 
        n116, n1872, n41, n3843, n3842, n4259, n4116, n1880_adj_924, 
        n2717, n1844, n1834, n1880, n3_adj_925, n1833, n135, n134, 
        n133, n132, n131, n130, n129, n128, n127, n126, n125, 
        n124, n123, n122, n121, n120, n1832;
    wire [7:0]i_Tx_Byte_adj_973;   // roboy_fpga_code/roboy_fpga_code/uart/uart_tx.v(18[16:25])
    
    wire n1831, n1556, n1553, n1522, n1777, n1879, n3841, n3840, 
        n11, n4258, n4108, n1809, n3839, n3838, n3837, n4256, 
        n1883, n1828, n1884, n1885, n12, n20, n11_adj_926, n4, 
        n4_adj_927, n1267, n4_adj_928, n1876, n19, n3836, n4334, 
        n18, n17, n1878, n16, n15, n14, n3835, n859, n4448, 
        n4583, n110, n111, n112, n4573, n113, n4_adj_929, tx_active, 
        tx_o, tx_done, rx_data_ready;
    wire [7:0]o_Rx_Byte;   // roboy_fpga_code/roboy_fpga_code/uart/uart_rx.v(19[17:26])
    
    wire n25, tx2_active, tx2_o, tx2_done;
    wire [2:0]r_SM_Main;   // roboy_fpga_code/roboy_fpga_code/uart/uart_tx.v(30[16:25])
    wire [8:0]r_Clock_Count;   // roboy_fpga_code/roboy_fpga_code/uart/uart_tx.v(31[16:29])
    wire [2:0]r_Bit_Index;   // roboy_fpga_code/roboy_fpga_code/uart/uart_tx.v(32[16:27])
    wire [7:0]r_Tx_Data;   // roboy_fpga_code/roboy_fpga_code/uart/uart_tx.v(33[16:25])
    wire [2:0]r_SM_Main_2__N_733;
    
    wire n312, n313, n314, n1873, n1776, n1774, n1771, n1768, 
        n315, n316, n1863, r_Rx_Data;
    wire [2:0]r_Bit_Index_adj_968;   // roboy_fpga_code/roboy_fpga_code/uart/uart_rx.v(33[17:28])
    wire [2:0]r_SM_Main_adj_969;   // roboy_fpga_code/roboy_fpga_code/uart/uart_rx.v(36[17:26])
    
    wire n24;
    wire [2:0]r_SM_Main_2__N_789;
    
    wire n1347, n1765, n4270;
    wire [2:0]r_SM_Main_adj_974;   // roboy_fpga_code/roboy_fpga_code/uart/uart_tx.v(30[16:25])
    wire [8:0]r_Clock_Count_adj_975;   // roboy_fpga_code/roboy_fpga_code/uart/uart_tx.v(31[16:29])
    wire [7:0]r_Tx_Data_adj_977;   // roboy_fpga_code/roboy_fpga_code/uart/uart_tx.v(33[16:25])
    
    wire n4423, n1855, n23, n314_adj_945, n119, n22, n10_adj_946, 
        n1049, n118, n8_adj_947, n7_adj_948, n1755, n1752, n317, 
        n318, n319, n320, n1671, n4078, n9_adj_949, n1859, n1866, 
        n1865, n1853, n1861, n1882, n1845, n1881, n1877, n1740, 
        n1749, n1739, n1737, n3859, n8_adj_950, n7_adj_951, n1875, 
        n8_adj_952, n7_adj_953, n3858, n3857, n8_adj_954, n7_adj_955, 
        n1815, n12_adj_956, n11_adj_957, n4300, n3856, n1149, n3855, 
        n3854, n10_adj_958, n10_adj_959, n1272, n9_adj_960, n4449, 
        n8_adj_961, n7_adj_962, n4_adj_963, n21_adj_964, n9_adj_965, 
        n3853, n3852, n3851, n3850, n4326, n4_adj_966, n3849;
    
    VCC i2 (.Y(VCC_net));
    SB_LUT4 i1749_3_lut (.I0(\data_in[0] [3]), .I1(\data_in[1] [3]), .I2(rx_data_ready_keep), 
            .I3(GND_net), .O(n1970));   // coms.v(146[10] 154[6])
    defparam i1749_3_lut.LUT_INIT = 16'hcaca;
    SB_LUT4 i1750_3_lut (.I0(\data_in[0] [4]), .I1(\data_in[1] [4]), .I2(rx_data_ready_keep), 
            .I3(GND_net), .O(n1971));   // coms.v(146[10] 154[6])
    defparam i1750_3_lut.LUT_INIT = 16'hcaca;
    SB_LUT4 blink_counter_308_add_4_11_lut (.I0(GND_net), .I1(GND_net), 
            .I2(n17), .I3(n3843), .O(n126)) /* synthesis syn_instantiated=1 */ ;
    defparam blink_counter_308_add_4_11_lut.LUT_INIT = 16'hC33C;
    SB_CARRY blink_counter_308_add_4_11 (.CI(n3843), .I0(GND_net), .I1(n17), 
            .CO(n3844));
    SB_LUT4 i1781_3_lut (.I0(\data_in[4] [3]), .I1(\data_in[5] [3]), .I2(rx_data_ready_keep), 
            .I3(GND_net), .O(n2002));   // coms.v(146[10] 154[6])
    defparam i1781_3_lut.LUT_INIT = 16'hcaca;
    SB_LUT4 blink_counter_308_add_4_10_lut (.I0(GND_net), .I1(GND_net), 
            .I2(n18), .I3(n3842), .O(n127)) /* synthesis syn_instantiated=1 */ ;
    defparam blink_counter_308_add_4_10_lut.LUT_INIT = 16'hC33C;
    SB_LUT4 i1771_3_lut (.I0(\data_in[3] [1]), .I1(\data_in[4] [1]), .I2(rx_data_ready_keep), 
            .I3(GND_net), .O(n1992));   // coms.v(146[10] 154[6])
    defparam i1771_3_lut.LUT_INIT = 16'hcaca;
    SB_LUT4 i1782_3_lut (.I0(\data_in[4] [4]), .I1(\data_in[5] [4]), .I2(rx_data_ready_keep), 
            .I3(GND_net), .O(n2003));   // coms.v(146[10] 154[6])
    defparam i1782_3_lut.LUT_INIT = 16'hcaca;
    SB_LUT4 i1772_3_lut (.I0(\data_in[3] [2]), .I1(\data_in[4] [2]), .I2(rx_data_ready_keep), 
            .I3(GND_net), .O(n1993));   // coms.v(146[10] 154[6])
    defparam i1772_3_lut.LUT_INIT = 16'hcaca;
    SB_LUT4 i1761_3_lut (.I0(\data_in[1] [7]), .I1(\data_in[2] [7]), .I2(rx_data_ready_keep), 
            .I3(GND_net), .O(n1982));   // coms.v(146[10] 154[6])
    defparam i1761_3_lut.LUT_INIT = 16'hcaca;
    SB_LUT4 i4284_4_lut (.I0(n1291), .I1(data_out_field_20), .I2(data_out_field_34), 
            .I3(n4334), .O(n4583));   // coms.v(115[10] 136[6])
    defparam i4284_4_lut.LUT_INIT = 16'h6996;
    SB_LUT4 i1654_3_lut (.I0(\data_out[6] [0]), .I1(n4583), .I2(n1553), 
            .I3(GND_net), .O(n1875));   // coms.v(115[10] 136[6])
    defparam i1654_3_lut.LUT_INIT = 16'hcaca;
    SB_LUT4 i1655_2_lut (.I0(n1553), .I1(data_out_field_31), .I2(GND_net), 
            .I3(GND_net), .O(n1876));   // coms.v(115[10] 136[6])
    defparam i1655_2_lut.LUT_INIT = 16'h4444;
    SB_LUT4 i1547_4_lut (.I0(n1776), .I1(r_Clock_Count[7]), .I2(n313), 
            .I3(r_SM_Main[2]), .O(n1768));   // roboy_fpga_code/roboy_fpga_code/uart/uart_tx.v(37[10] 140[8])
    defparam i1547_4_lut.LUT_INIT = 16'h88a0;
    SB_LUT4 i1528_4_lut (.I0(n1739), .I1(r_Clock_Count_adj_975[3]), .I2(n317), 
            .I3(r_SM_Main_adj_974[2]), .O(n1749));   // roboy_fpga_code/roboy_fpga_code/uart/uart_tx.v(37[10] 140[8])
    defparam i1528_4_lut.LUT_INIT = 16'h88a0;
    SB_LUT4 i1805_3_lut (.I0(\data_in[7] [3]), .I1(n1888_adj_920), .I2(rx_data_ready_keep), 
            .I3(GND_net), .O(n2026));   // coms.v(146[10] 154[6])
    defparam i1805_3_lut.LUT_INIT = 16'hcaca;
    SB_LUT4 i1715_3_lut (.I0(r_Tx_Data[2]), .I1(i_Tx_Byte[2]), .I2(n1149), 
            .I3(GND_net), .O(n1936));   // roboy_fpga_code/roboy_fpga_code/uart/uart_tx.v(37[10] 140[8])
    defparam i1715_3_lut.LUT_INIT = 16'hcaca;
    SB_LUT4 i1717_3_lut (.I0(r_Tx_Data[4]), .I1(i_Tx_Byte[4]), .I2(n1149), 
            .I3(GND_net), .O(n1938));   // roboy_fpga_code/roboy_fpga_code/uart/uart_tx.v(37[10] 140[8])
    defparam i1717_3_lut.LUT_INIT = 16'hcaca;
    SB_LUT4 i1806_3_lut (.I0(\data_in[7] [4]), .I1(n1886_adj_919), .I2(rx_data_ready_keep), 
            .I3(GND_net), .O(n2027));   // coms.v(146[10] 154[6])
    defparam i1806_3_lut.LUT_INIT = 16'hcaca;
    SB_CARRY blink_counter_308_add_4_10 (.CI(n3842), .I0(GND_net), .I1(n18), 
            .CO(n3843));
    SB_LUT4 i1718_3_lut (.I0(r_Tx_Data[5]), .I1(i_Tx_Byte[5]), .I2(n1149), 
            .I3(GND_net), .O(n1939));   // roboy_fpga_code/roboy_fpga_code/uart/uart_tx.v(37[10] 140[8])
    defparam i1718_3_lut.LUT_INIT = 16'hcaca;
    SB_LUT4 i1773_3_lut (.I0(\data_in[3] [3]), .I1(\data_in[4] [3]), .I2(rx_data_ready_keep), 
            .I3(GND_net), .O(n1994));   // coms.v(146[10] 154[6])
    defparam i1773_3_lut.LUT_INIT = 16'hcaca;
    SB_LUT4 blink_counter_308_add_4_9_lut (.I0(GND_net), .I1(GND_net), .I2(n19), 
            .I3(n3841), .O(n128)) /* synthesis syn_instantiated=1 */ ;
    defparam blink_counter_308_add_4_9_lut.LUT_INIT = 16'hC33C;
    SB_CARRY blink_counter_308_add_4_9 (.CI(n3841), .I0(GND_net), .I1(n19), 
            .CO(n3842));
    SB_LUT4 blink_counter_308_add_4_8_lut (.I0(GND_net), .I1(GND_net), .I2(n20), 
            .I3(n3840), .O(n129)) /* synthesis syn_instantiated=1 */ ;
    defparam blink_counter_308_add_4_8_lut.LUT_INIT = 16'hC33C;
    SB_CARRY blink_counter_308_add_4_8 (.CI(n3840), .I0(GND_net), .I1(n20), 
            .CO(n3841));
    SB_LUT4 blink_counter_308_add_4_7_lut (.I0(GND_net), .I1(GND_net), .I2(n21), 
            .I3(n3839), .O(n130)) /* synthesis syn_instantiated=1 */ ;
    defparam blink_counter_308_add_4_7_lut.LUT_INIT = 16'hC33C;
    SB_CARRY blink_counter_308_add_4_7 (.CI(n3839), .I0(GND_net), .I1(n21), 
            .CO(n3840));
    SB_LUT4 i1785_3_lut (.I0(\data_in[4] [7]), .I1(\data_in[5] [7]), .I2(rx_data_ready_keep), 
            .I3(GND_net), .O(n2006));   // coms.v(146[10] 154[6])
    defparam i1785_3_lut.LUT_INIT = 16'hcaca;
    SB_LUT4 i1719_3_lut (.I0(r_Tx_Data[6]), .I1(i_Tx_Byte[6]), .I2(n1149), 
            .I3(GND_net), .O(n1940));   // roboy_fpga_code/roboy_fpga_code/uart/uart_tx.v(37[10] 140[8])
    defparam i1719_3_lut.LUT_INIT = 16'hcaca;
    SB_LUT4 i1807_3_lut (.I0(\data_in[7] [5]), .I1(n1884_adj_918), .I2(rx_data_ready_keep), 
            .I3(GND_net), .O(n2028));   // coms.v(146[10] 154[6])
    defparam i1807_3_lut.LUT_INIT = 16'hcaca;
    SB_LUT4 i1783_3_lut (.I0(\data_in[4] [5]), .I1(\data_in[5] [5]), .I2(rx_data_ready_keep), 
            .I3(GND_net), .O(n2004));   // coms.v(146[10] 154[6])
    defparam i1783_3_lut.LUT_INIT = 16'hcaca;
    SB_LUT4 i1774_3_lut (.I0(\data_in[3] [4]), .I1(\data_in[4] [4]), .I2(rx_data_ready_keep), 
            .I3(GND_net), .O(n1995));   // coms.v(146[10] 154[6])
    defparam i1774_3_lut.LUT_INIT = 16'hcaca;
    SB_LUT4 i1762_3_lut (.I0(\data_in[2] [0]), .I1(\data_in[3] [0]), .I2(rx_data_ready_keep), 
            .I3(GND_net), .O(n1983));   // coms.v(146[10] 154[6])
    defparam i1762_3_lut.LUT_INIT = 16'hcaca;
    SB_LUT4 i1775_3_lut (.I0(\data_in[3] [5]), .I1(\data_in[4] [5]), .I2(rx_data_ready_keep), 
            .I3(GND_net), .O(n1996));   // coms.v(146[10] 154[6])
    defparam i1775_3_lut.LUT_INIT = 16'hcaca;
    SB_LUT4 blink_counter_308_add_4_6_lut (.I0(GND_net), .I1(GND_net), .I2(n22), 
            .I3(n3838), .O(n131)) /* synthesis syn_instantiated=1 */ ;
    defparam blink_counter_308_add_4_6_lut.LUT_INIT = 16'hC33C;
    SB_LUT4 i1610_3_lut (.I0(tx_o), .I1(n3), .I2(r_SM_Main[2]), .I3(GND_net), 
            .O(n1831));   // roboy_fpga_code/roboy_fpga_code/uart/uart_tx.v(37[10] 140[8])
    defparam i1610_3_lut.LUT_INIT = 16'hacac;
    SB_CARRY blink_counter_308_add_4_6 (.CI(n3838), .I0(GND_net), .I1(n22), 
            .CO(n3839));
    SB_IO PIN_1_pad (.PACKAGE_PIN(PIN_1), .OUTPUT_ENABLE(VCC_net), .D_OUT_0(PIN_1_c));   // /home/letrend/lscc/iCEcube2.2017.08/LSE/userware/unix/SYNTHESIS_HEADERS/sb_ice40.v(502[8:13])
    defparam PIN_1_pad.PIN_TYPE = 6'b011001;
    defparam PIN_1_pad.PULLUP = 1'b0;
    defparam PIN_1_pad.NEG_TRIGGER = 1'b0;
    defparam PIN_1_pad.IO_STANDARD = "SB_LVCMOS";
    SB_LUT4 i1611_4_lut (.I0(tx_active), .I1(r_SM_Main[1]), .I2(r_SM_Main[2]), 
            .I3(n4270), .O(n1832));   // roboy_fpga_code/roboy_fpga_code/uart/uart_tx.v(37[10] 140[8])
    defparam i1611_4_lut.LUT_INIT = 16'ha3aa;
    SB_LUT4 i1612_3_lut (.I0(r_Tx_Data[0]), .I1(i_Tx_Byte[0]), .I2(n1149), 
            .I3(GND_net), .O(n1833));   // roboy_fpga_code/roboy_fpga_code/uart/uart_tx.v(37[10] 140[8])
    defparam i1612_3_lut.LUT_INIT = 16'hcaca;
    SB_LUT4 i1763_3_lut (.I0(\data_in[2] [1]), .I1(\data_in[3] [1]), .I2(rx_data_ready_keep), 
            .I3(GND_net), .O(n1984));   // coms.v(146[10] 154[6])
    defparam i1763_3_lut.LUT_INIT = 16'hcaca;
    SB_LUT4 blink_counter_308_add_4_5_lut (.I0(GND_net), .I1(GND_net), .I2(n23), 
            .I3(n3837), .O(n132)) /* synthesis syn_instantiated=1 */ ;
    defparam blink_counter_308_add_4_5_lut.LUT_INIT = 16'hC33C;
    SB_LUT4 i1613_4_lut (.I0(r_SM_Main[2]), .I1(n41), .I2(r_SM_Main_2__N_733[1]), 
            .I3(r_SM_Main[0]), .O(n1834));   // roboy_fpga_code/roboy_fpga_code/uart/uart_tx.v(37[10] 140[8])
    defparam i1613_4_lut.LUT_INIT = 16'h0544;
    SB_LUT4 i1756_3_lut (.I0(\data_in[1] [2]), .I1(\data_in[2] [2]), .I2(rx_data_ready_keep), 
            .I3(GND_net), .O(n1977));   // coms.v(146[10] 154[6])
    defparam i1756_3_lut.LUT_INIT = 16'hcaca;
    SB_LUT4 i1607_3_lut (.I0(n1788), .I1(r_Bit_Index_adj_968[0]), .I2(n4423), 
            .I3(GND_net), .O(n1828));   // roboy_fpga_code/roboy_fpga_code/uart/uart_rx.v(49[10] 144[8])
    defparam i1607_3_lut.LUT_INIT = 16'h8282;
    SB_LUT4 i1764_3_lut (.I0(\data_in[2] [2]), .I1(\data_in[3] [2]), .I2(rx_data_ready_keep), 
            .I3(GND_net), .O(n1985));   // coms.v(146[10] 154[6])
    defparam i1764_3_lut.LUT_INIT = 16'hcaca;
    SB_LUT4 i1776_3_lut (.I0(\data_in[3] [6]), .I1(\data_in[4] [6]), .I2(rx_data_ready_keep), 
            .I3(GND_net), .O(n1997));   // coms.v(146[10] 154[6])
    defparam i1776_3_lut.LUT_INIT = 16'hcaca;
    SB_LUT4 i1784_3_lut (.I0(\data_in[4] [6]), .I1(\data_in[5] [6]), .I2(rx_data_ready_keep), 
            .I3(GND_net), .O(n2005));   // coms.v(146[10] 154[6])
    defparam i1784_3_lut.LUT_INIT = 16'hcaca;
    SB_LUT4 i1622_3_lut (.I0(tx2_o), .I1(n3_adj_925), .I2(r_SM_Main_adj_974[2]), 
            .I3(GND_net), .O(n1843));   // roboy_fpga_code/roboy_fpga_code/uart/uart_tx.v(37[10] 140[8])
    defparam i1622_3_lut.LUT_INIT = 16'hacac;
    SB_LUT4 i1808_3_lut (.I0(\data_in[7] [6]), .I1(n1882_adj_917), .I2(rx_data_ready_keep), 
            .I3(GND_net), .O(n2029));   // coms.v(146[10] 154[6])
    defparam i1808_3_lut.LUT_INIT = 16'hcaca;
    SB_LUT4 i1809_3_lut (.I0(\data_in[7] [7]), .I1(n1880_adj_924), .I2(rx_data_ready_keep), 
            .I3(GND_net), .O(n2030));   // coms.v(146[10] 154[6])
    defparam i1809_3_lut.LUT_INIT = 16'hcaca;
    SB_LUT4 i1685_2_lut (.I0(n1553), .I1(data_out_field_1), .I2(GND_net), 
            .I3(GND_net), .O(n1906));   // coms.v(115[10] 136[6])
    defparam i1685_2_lut.LUT_INIT = 16'heeee;
    SB_LUT4 i1777_3_lut (.I0(\data_in[3] [7]), .I1(\data_in[4] [7]), .I2(rx_data_ready_keep), 
            .I3(GND_net), .O(n1998));   // coms.v(146[10] 154[6])
    defparam i1777_3_lut.LUT_INIT = 16'hcaca;
    SB_LUT4 i1765_3_lut (.I0(\data_in[2] [3]), .I1(\data_in[3] [3]), .I2(rx_data_ready_keep), 
            .I3(GND_net), .O(n1986));   // coms.v(146[10] 154[6])
    defparam i1765_3_lut.LUT_INIT = 16'hcaca;
    SB_LUT4 i1684_2_lut (.I0(n1553), .I1(data_out_field_2), .I2(GND_net), 
            .I3(GND_net), .O(n1905));   // coms.v(115[10] 136[6])
    defparam i1684_2_lut.LUT_INIT = 16'h4444;
    SB_LUT4 i1683_2_lut (.I0(n1553), .I1(data_out_field_3), .I2(GND_net), 
            .I3(GND_net), .O(n1904));   // coms.v(115[10] 136[6])
    defparam i1683_2_lut.LUT_INIT = 16'heeee;
    SB_CARRY blink_counter_308_add_4_5 (.CI(n3837), .I0(GND_net), .I1(n23), 
            .CO(n3838));
    SB_LUT4 blink_counter_308_add_4_4_lut (.I0(GND_net), .I1(GND_net), .I2(n24), 
            .I3(n3836), .O(n133)) /* synthesis syn_instantiated=1 */ ;
    defparam blink_counter_308_add_4_4_lut.LUT_INIT = 16'hC33C;
    SB_LUT4 i1623_4_lut (.I0(tx2_active), .I1(r_SM_Main_adj_974[1]), .I2(r_SM_Main_adj_974[2]), 
            .I3(n4_adj_928), .O(n1844));   // roboy_fpga_code/roboy_fpga_code/uart/uart_tx.v(37[10] 140[8])
    defparam i1623_4_lut.LUT_INIT = 16'ha3aa;
    SB_IO USBPU_pad (.PACKAGE_PIN(USBPU), .OUTPUT_ENABLE(VCC_net), .D_OUT_0(GND_net));   // /home/letrend/lscc/iCEcube2.2017.08/LSE/userware/unix/SYNTHESIS_HEADERS/sb_ice40.v(502[8:13])
    defparam USBPU_pad.PIN_TYPE = 6'b011001;
    defparam USBPU_pad.PULLUP = 1'b0;
    defparam USBPU_pad.NEG_TRIGGER = 1'b0;
    defparam USBPU_pad.IO_STANDARD = "SB_LVCMOS";
    SB_CARRY blink_counter_308_add_4_4 (.CI(n3836), .I0(GND_net), .I1(n24), 
            .CO(n3837));
    SB_LUT4 blink_counter_308_add_4_3_lut (.I0(GND_net), .I1(GND_net), .I2(n25), 
            .I3(n3835), .O(n134)) /* synthesis syn_instantiated=1 */ ;
    defparam blink_counter_308_add_4_3_lut.LUT_INIT = 16'hC33C;
    SB_LUT4 i1778_3_lut (.I0(\data_in[4] [0]), .I1(\data_in[5] [0]), .I2(rx_data_ready_keep), 
            .I3(GND_net), .O(n1999));   // coms.v(146[10] 154[6])
    defparam i1778_3_lut.LUT_INIT = 16'hcaca;
    SB_LUT4 i1766_3_lut (.I0(\data_in[2] [4]), .I1(\data_in[3] [4]), .I2(rx_data_ready_keep), 
            .I3(GND_net), .O(n1987));   // coms.v(146[10] 154[6])
    defparam i1766_3_lut.LUT_INIT = 16'hcaca;
    SB_LUT4 i1544_4_lut (.I0(n1776), .I1(r_Clock_Count[8]), .I2(n312), 
            .I3(r_SM_Main[2]), .O(n1765));   // roboy_fpga_code/roboy_fpga_code/uart/uart_tx.v(37[10] 140[8])
    defparam i1544_4_lut.LUT_INIT = 16'h88a0;
    SB_LUT4 i1739_3_lut (.I0(r_Tx_Data_adj_977[2]), .I1(i_Tx_Byte_adj_973[2]), 
            .I2(n1049), .I3(GND_net), .O(n1960));   // roboy_fpga_code/roboy_fpga_code/uart/uart_tx.v(37[10] 140[8])
    defparam i1739_3_lut.LUT_INIT = 16'hcaca;
    SB_LUT4 i1_2_lut (.I0(r_SM_Main_adj_974[1]), .I1(r_SM_Main_adj_974[0]), 
            .I2(GND_net), .I3(GND_net), .O(n11));   // roboy_fpga_code/roboy_fpga_code/uart/uart_tx.v(37[10] 140[8])
    defparam i1_2_lut.LUT_INIT = 16'heeee;
    SB_CARRY blink_counter_308_add_4_3 (.CI(n3835), .I0(GND_net), .I1(n25), 
            .CO(n3836));
    SB_LUT4 blink_counter_308_add_4_2_lut (.I0(GND_net), .I1(GND_net), .I2(n26), 
            .I3(VCC_net), .O(n135)) /* synthesis syn_instantiated=1 */ ;
    defparam blink_counter_308_add_4_2_lut.LUT_INIT = 16'hC33C;
    SB_CARRY blink_counter_308_add_4_2 (.CI(VCC_net), .I0(GND_net), .I1(n26), 
            .CO(n3835));
    SB_IO LED_pad (.PACKAGE_PIN(LED), .OUTPUT_ENABLE(VCC_net), .D_OUT_0(LED_c));   // /home/letrend/lscc/iCEcube2.2017.08/LSE/userware/unix/SYNTHESIS_HEADERS/sb_ice40.v(502[8:13])
    defparam LED_pad.PIN_TYPE = 6'b011001;
    defparam LED_pad.PULLUP = 1'b0;
    defparam LED_pad.NEG_TRIGGER = 1'b0;
    defparam LED_pad.IO_STANDARD = "SB_LVCMOS";
    SB_GB_IO CLK_pad (.PACKAGE_PIN(CLK), .OUTPUT_ENABLE(VCC_net), .GLOBAL_BUFFER_OUTPUT(CLK_c));   // verilog/TinyFPGA_B.v(3[9:12])
    defparam CLK_pad.PIN_TYPE = 6'b000001;
    defparam CLK_pad.PULLUP = 1'b0;
    defparam CLK_pad.NEG_TRIGGER = 1'b0;
    defparam CLK_pad.IO_STANDARD = "SB_LVCMOS";
    SB_DFF blink_counter_308__i0 (.Q(n26), .C(CLK_c), .D(n135));   // verilog/TinyFPGA_B.v(46[24:41])
    SB_LUT4 i1682_2_lut (.I0(n1553), .I1(data_out_field_4), .I2(GND_net), 
            .I3(GND_net), .O(n1903));   // coms.v(115[10] 136[6])
    defparam i1682_2_lut.LUT_INIT = 16'heeee;
    SB_LUT4 i1741_3_lut (.I0(r_Tx_Data_adj_977[4]), .I1(i_Tx_Byte_adj_973[4]), 
            .I2(n1049), .I3(GND_net), .O(n1962));   // roboy_fpga_code/roboy_fpga_code/uart/uart_tx.v(37[10] 140[8])
    defparam i1741_3_lut.LUT_INIT = 16'hcaca;
    SB_LUT4 i1_4_lut (.I0(tx2_done), .I1(n4256), .I2(n11), .I3(r_SM_Main_adj_974[2]), 
            .O(n4108));   // roboy_fpga_code/roboy_fpga_code/uart/uart_tx.v(37[10] 140[8])
    defparam i1_4_lut.LUT_INIT = 16'hafec;
    SB_LUT4 i1681_2_lut (.I0(n1553), .I1(data_out_field_5), .I2(GND_net), 
            .I3(GND_net), .O(n1902));   // coms.v(115[10] 136[6])
    defparam i1681_2_lut.LUT_INIT = 16'h4444;
    SB_LUT4 i1680_2_lut (.I0(n1553), .I1(data_out_field_6), .I2(GND_net), 
            .I3(GND_net), .O(n1901));   // coms.v(115[10] 136[6])
    defparam i1680_2_lut.LUT_INIT = 16'heeee;
    SB_LUT4 i1679_2_lut (.I0(n1553), .I1(data_out_field_7), .I2(GND_net), 
            .I3(GND_net), .O(n1900));   // coms.v(115[10] 136[6])
    defparam i1679_2_lut.LUT_INIT = 16'heeee;
    SB_LUT4 i1678_2_lut (.I0(n1553), .I1(data_out_field_8), .I2(GND_net), 
            .I3(GND_net), .O(n1899));   // coms.v(115[10] 136[6])
    defparam i1678_2_lut.LUT_INIT = 16'heeee;
    SB_LUT4 i4118_4_lut (.I0(blink_counter[22]), .I1(blink_counter[23]), 
            .I2(blink_counter[24]), .I3(blink_counter[21]), .O(n4449));
    defparam i4118_4_lut.LUT_INIT = 16'hfec4;
    SB_LUT4 i1677_2_lut (.I0(n1553), .I1(data_out_field_9), .I2(GND_net), 
            .I3(GND_net), .O(n1898));   // coms.v(115[10] 136[6])
    defparam i1677_2_lut.LUT_INIT = 16'heeee;
    SB_LUT4 i4117_4_lut (.I0(blink_counter[23]), .I1(blink_counter[22]), 
            .I2(blink_counter[24]), .I3(blink_counter[21]), .O(n4448));
    defparam i4117_4_lut.LUT_INIT = 16'hcf08;
    SB_LUT4 i1676_2_lut (.I0(n1553), .I1(data_out_field_10), .I2(GND_net), 
            .I3(GND_net), .O(n1897));   // coms.v(115[10] 136[6])
    defparam i1676_2_lut.LUT_INIT = 16'h4444;
    SB_LUT4 i4119_3_lut (.I0(n4448), .I1(n4449), .I2(blink_counter[25]), 
            .I3(GND_net), .O(LED_c));
    defparam i4119_3_lut.LUT_INIT = 16'h3535;
    SB_LUT4 i1786_3_lut (.I0(\data_in[5] [0]), .I1(\data_in[6] [0]), .I2(rx_data_ready_keep), 
            .I3(GND_net), .O(n2007));   // coms.v(146[10] 154[6])
    defparam i1786_3_lut.LUT_INIT = 16'hcaca;
    SB_LUT4 i1675_2_lut (.I0(n1553), .I1(data_out_field_11), .I2(GND_net), 
            .I3(GND_net), .O(n1896));   // coms.v(115[10] 136[6])
    defparam i1675_2_lut.LUT_INIT = 16'heeee;
    SB_IO PIN_2_pad (.PACKAGE_PIN(PIN_2), .OUTPUT_ENABLE(VCC_net), .D_IN_0(PIN_2_c));   // /home/letrend/lscc/iCEcube2.2017.08/LSE/userware/unix/SYNTHESIS_HEADERS/sb_ice40.v(502[8:13])
    defparam PIN_2_pad.PIN_TYPE = 6'b000001;
    defparam PIN_2_pad.PULLUP = 1'b0;
    defparam PIN_2_pad.NEG_TRIGGER = 1'b0;
    defparam PIN_2_pad.IO_STANDARD = "SB_LVCMOS";
    SB_LUT4 i1674_2_lut (.I0(n1553), .I1(data_out_field_12), .I2(GND_net), 
            .I3(GND_net), .O(n1895));   // coms.v(115[10] 136[6])
    defparam i1674_2_lut.LUT_INIT = 16'heeee;
    SB_LUT4 i1673_2_lut (.I0(n1553), .I1(data_out_field_13), .I2(GND_net), 
            .I3(GND_net), .O(n1894));   // coms.v(115[10] 136[6])
    defparam i1673_2_lut.LUT_INIT = 16'heeee;
    SB_LUT4 i1672_2_lut (.I0(n1553), .I1(data_out_field_14), .I2(GND_net), 
            .I3(GND_net), .O(n1893));   // coms.v(115[10] 136[6])
    defparam i1672_2_lut.LUT_INIT = 16'h4444;
    SB_LUT4 i1671_2_lut (.I0(n1553), .I1(data_out_field_15), .I2(GND_net), 
            .I3(GND_net), .O(n1892));   // coms.v(115[10] 136[6])
    defparam i1671_2_lut.LUT_INIT = 16'heeee;
    SB_LUT4 i1670_2_lut (.I0(n1553), .I1(data_out_field_16), .I2(GND_net), 
            .I3(GND_net), .O(n1891));   // coms.v(115[10] 136[6])
    defparam i1670_2_lut.LUT_INIT = 16'heeee;
    SB_LUT4 i1669_2_lut (.I0(n1553), .I1(data_out_field_17), .I2(GND_net), 
            .I3(GND_net), .O(n1890));   // coms.v(115[10] 136[6])
    defparam i1669_2_lut.LUT_INIT = 16'h4444;
    SB_LUT4 i1668_2_lut (.I0(n1553), .I1(data_out_field_18), .I2(GND_net), 
            .I3(GND_net), .O(n1889));   // coms.v(115[10] 136[6])
    defparam i1668_2_lut.LUT_INIT = 16'heeee;
    SB_LUT4 i1667_2_lut (.I0(n1553), .I1(data_out_field_19), .I2(GND_net), 
            .I3(GND_net), .O(n1888));   // coms.v(115[10] 136[6])
    defparam i1667_2_lut.LUT_INIT = 16'heeee;
    SB_LUT4 i1666_2_lut (.I0(n1553), .I1(data_out_field_20), .I2(GND_net), 
            .I3(GND_net), .O(n1887));   // coms.v(115[10] 136[6])
    defparam i1666_2_lut.LUT_INIT = 16'h4444;
    SB_LUT4 i1571_4_lut (.I0(n1788), .I1(r_Bit_Index_adj_968[1]), .I2(r_Bit_Index_adj_968[0]), 
            .I3(n4423), .O(n1792));   // roboy_fpga_code/roboy_fpga_code/uart/uart_rx.v(49[10] 144[8])
    defparam i1571_4_lut.LUT_INIT = 16'h8828;
    SB_LUT4 i1665_2_lut (.I0(n1553), .I1(data_out_field_21), .I2(GND_net), 
            .I3(GND_net), .O(n1886));   // coms.v(115[10] 136[6])
    defparam i1665_2_lut.LUT_INIT = 16'heeee;
    SB_LUT4 i1664_2_lut (.I0(n1553), .I1(data_out_field_22), .I2(GND_net), 
            .I3(GND_net), .O(n1885));   // coms.v(115[10] 136[6])
    defparam i1664_2_lut.LUT_INIT = 16'h4444;
    SB_LUT4 i1663_2_lut (.I0(n1553), .I1(data_out_field_23), .I2(GND_net), 
            .I3(GND_net), .O(n1884));   // coms.v(115[10] 136[6])
    defparam i1663_2_lut.LUT_INIT = 16'heeee;
    SB_LUT4 i1662_2_lut (.I0(n1553), .I1(data_out_field_24), .I2(GND_net), 
            .I3(GND_net), .O(n1883));   // coms.v(115[10] 136[6])
    defparam i1662_2_lut.LUT_INIT = 16'h4444;
    SB_LUT4 i1757_3_lut (.I0(\data_in[1] [3]), .I1(\data_in[2] [3]), .I2(rx_data_ready_keep), 
            .I3(GND_net), .O(n1978));   // coms.v(146[10] 154[6])
    defparam i1757_3_lut.LUT_INIT = 16'hcaca;
    SB_LUT4 i1572_4_lut (.I0(r_Rx_Data), .I1(o_Rx_Byte[7]), .I2(n2717), 
            .I3(n1272), .O(n1793));   // roboy_fpga_code/roboy_fpga_code/uart/uart_rx.v(49[10] 144[8])
    defparam i1572_4_lut.LUT_INIT = 16'hccac;
    SB_LUT4 i1568_4_lut (.I0(n1788), .I1(r_Bit_Index_adj_968[2]), .I2(n607), 
            .I3(n4423), .O(n1789));   // roboy_fpga_code/roboy_fpga_code/uart/uart_rx.v(49[10] 144[8])
    defparam i1568_4_lut.LUT_INIT = 16'h8828;
    SB_IO PIN_3_pad (.PACKAGE_PIN(PIN_3), .OUTPUT_ENABLE(VCC_net), .D_OUT_0(PIN_3_c));   // /home/letrend/lscc/iCEcube2.2017.08/LSE/userware/unix/SYNTHESIS_HEADERS/sb_ice40.v(502[8:13])
    defparam PIN_3_pad.PIN_TYPE = 6'b011001;
    defparam PIN_3_pad.PULLUP = 1'b0;
    defparam PIN_3_pad.NEG_TRIGGER = 1'b0;
    defparam PIN_3_pad.IO_STANDARD = "SB_LVCMOS";
    SB_LUT4 i1661_2_lut (.I0(n1553), .I1(data_out_field_25), .I2(GND_net), 
            .I3(GND_net), .O(n1882));   // coms.v(115[10] 136[6])
    defparam i1661_2_lut.LUT_INIT = 16'h4444;
    SB_LUT4 i1574_4_lut (.I0(r_Rx_Data), .I1(o_Rx_Byte[6]), .I2(n2717), 
            .I3(n1267), .O(n1795));   // roboy_fpga_code/roboy_fpga_code/uart/uart_rx.v(49[10] 144[8])
    defparam i1574_4_lut.LUT_INIT = 16'hccac;
    SB_LUT4 i1575_4_lut (.I0(r_Rx_Data), .I1(o_Rx_Byte[5]), .I2(n4_adj_927), 
            .I3(n1272), .O(n1796));   // roboy_fpga_code/roboy_fpga_code/uart/uart_rx.v(49[10] 144[8])
    defparam i1575_4_lut.LUT_INIT = 16'hccca;
    SB_LUT4 i1767_3_lut (.I0(\data_in[2] [5]), .I1(\data_in[3] [5]), .I2(rx_data_ready_keep), 
            .I3(GND_net), .O(n1988));   // coms.v(146[10] 154[6])
    defparam i1767_3_lut.LUT_INIT = 16'hcaca;
    SB_LUT4 i1578_4_lut (.I0(r_Rx_Data), .I1(o_Rx_Byte[3]), .I2(n4), .I3(n1272), 
            .O(n1799));   // roboy_fpga_code/roboy_fpga_code/uart/uart_rx.v(49[10] 144[8])
    defparam i1578_4_lut.LUT_INIT = 16'hccca;
    SB_LUT4 i1779_3_lut (.I0(\data_in[4] [1]), .I1(\data_in[5] [1]), .I2(rx_data_ready_keep), 
            .I3(GND_net), .O(n2000));   // coms.v(146[10] 154[6])
    defparam i1779_3_lut.LUT_INIT = 16'hcaca;
    SB_LUT4 i1576_4_lut (.I0(r_Rx_Data), .I1(o_Rx_Byte[4]), .I2(n4_adj_927), 
            .I3(n1267), .O(n1797));   // roboy_fpga_code/roboy_fpga_code/uart/uart_rx.v(49[10] 144[8])
    defparam i1576_4_lut.LUT_INIT = 16'hccca;
    SB_LUT4 i1579_4_lut (.I0(r_Rx_Data), .I1(o_Rx_Byte[2]), .I2(n4), .I3(n1267), 
            .O(n1800));   // roboy_fpga_code/roboy_fpga_code/uart/uart_rx.v(49[10] 144[8])
    defparam i1579_4_lut.LUT_INIT = 16'hccca;
    SB_LUT4 i1744_3_lut (.I0(r_Tx_Data_adj_977[7]), .I1(i_Tx_Byte_adj_973[7]), 
            .I2(n1049), .I3(GND_net), .O(n1965));   // roboy_fpga_code/roboy_fpga_code/uart/uart_tx.v(37[10] 140[8])
    defparam i1744_3_lut.LUT_INIT = 16'hcaca;
    SB_LUT4 i1768_3_lut (.I0(\data_in[2] [6]), .I1(\data_in[3] [6]), .I2(rx_data_ready_keep), 
            .I3(GND_net), .O(n1989));   // coms.v(146[10] 154[6])
    defparam i1768_3_lut.LUT_INIT = 16'hcaca;
    SB_LUT4 i1519_4_lut (.I0(n1739), .I1(r_Clock_Count_adj_975[6]), .I2(n314_adj_945), 
            .I3(r_SM_Main_adj_974[2]), .O(n1740));   // roboy_fpga_code/roboy_fpga_code/uart/uart_tx.v(37[10] 140[8])
    defparam i1519_4_lut.LUT_INIT = 16'h88a0;
    SB_LUT4 i1714_3_lut (.I0(r_Tx_Data[1]), .I1(i_Tx_Byte[1]), .I2(n1149), 
            .I3(GND_net), .O(n1935));   // roboy_fpga_code/roboy_fpga_code/uart/uart_tx.v(37[10] 140[8])
    defparam i1714_3_lut.LUT_INIT = 16'hcaca;
    SB_LUT4 i1787_3_lut (.I0(\data_in[5] [1]), .I1(\data_in[6] [1]), .I2(rx_data_ready_keep), 
            .I3(GND_net), .O(n2008));   // coms.v(146[10] 154[6])
    defparam i1787_3_lut.LUT_INIT = 16'hcaca;
    SB_LUT4 i1789_3_lut (.I0(\data_in[5] [3]), .I1(\data_in[6] [3]), .I2(rx_data_ready_keep), 
            .I3(GND_net), .O(n2010));   // coms.v(146[10] 154[6])
    defparam i1789_3_lut.LUT_INIT = 16'hcaca;
    SB_LUT4 i1788_3_lut (.I0(\data_in[5] [2]), .I1(\data_in[6] [2]), .I2(rx_data_ready_keep), 
            .I3(GND_net), .O(n2009));   // coms.v(146[10] 154[6])
    defparam i1788_3_lut.LUT_INIT = 16'hcaca;
    SB_LUT4 i1791_3_lut (.I0(\data_in[5] [5]), .I1(\data_in[6] [5]), .I2(rx_data_ready_keep), 
            .I3(GND_net), .O(n2012));   // coms.v(146[10] 154[6])
    defparam i1791_3_lut.LUT_INIT = 16'hcaca;
    SB_LUT4 i1790_3_lut (.I0(\data_in[5] [4]), .I1(\data_in[6] [4]), .I2(rx_data_ready_keep), 
            .I3(GND_net), .O(n2011));   // coms.v(146[10] 154[6])
    defparam i1790_3_lut.LUT_INIT = 16'hcaca;
    SB_LUT4 i1793_3_lut (.I0(\data_in[5] [7]), .I1(\data_in[6] [7]), .I2(rx_data_ready_keep), 
            .I3(GND_net), .O(n2014));   // coms.v(146[10] 154[6])
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
    defparam i1634_4_lut.LUT_INIT = 16'hccca;
    SB_LUT4 i1752_3_lut (.I0(\data_in[0] [6]), .I1(\data_in[1] [6]), .I2(rx_data_ready_keep), 
            .I3(GND_net), .O(n1973));   // coms.v(146[10] 154[6])
    defparam i1752_3_lut.LUT_INIT = 16'hcaca;
    SB_LUT4 i1753_3_lut (.I0(\data_in[0] [7]), .I1(\data_in[1] [7]), .I2(rx_data_ready_keep), 
            .I3(GND_net), .O(n1974));   // coms.v(146[10] 154[6])
    defparam i1753_3_lut.LUT_INIT = 16'hcaca;
    SB_LUT4 i1755_3_lut (.I0(\data_in[1] [1]), .I1(\data_in[2] [1]), .I2(rx_data_ready_keep), 
            .I3(GND_net), .O(n1976));   // coms.v(146[10] 154[6])
    defparam i1755_3_lut.LUT_INIT = 16'hcaca;
    SB_LUT4 i1758_3_lut (.I0(\data_in[1] [4]), .I1(\data_in[2] [4]), .I2(rx_data_ready_keep), 
            .I3(GND_net), .O(n1979));   // coms.v(146[10] 154[6])
    defparam i1758_3_lut.LUT_INIT = 16'hcaca;
    SB_LUT4 i1748_3_lut (.I0(\data_in[0] [2]), .I1(\data_in[1] [2]), .I2(rx_data_ready_keep), 
            .I3(GND_net), .O(n1969));   // coms.v(146[10] 154[6])
    defparam i1748_3_lut.LUT_INIT = 16'hcaca;
    SB_LUT4 i1553_4_lut (.I0(n1776), .I1(r_Clock_Count[5]), .I2(n315), 
            .I3(r_SM_Main[2]), .O(n1774));   // roboy_fpga_code/roboy_fpga_code/uart/uart_tx.v(37[10] 140[8])
    defparam i1553_4_lut.LUT_INIT = 16'h88a0;
    SB_LUT4 i1769_3_lut (.I0(\data_in[2] [7]), .I1(\data_in[3] [7]), .I2(rx_data_ready_keep), 
            .I3(GND_net), .O(n1990));   // coms.v(146[10] 154[6])
    defparam i1769_3_lut.LUT_INIT = 16'hcaca;
    SB_LUT4 i2_3_lut (.I0(r_SM_Main[0]), .I1(r_SM_Main[1]), .I2(r_SM_Main_2__N_733[1]), 
            .I3(GND_net), .O(n4258));   // roboy_fpga_code/roboy_fpga_code/uart/uart_tx.v(37[10] 140[8])
    defparam i2_3_lut.LUT_INIT = 16'h8080;
    SB_DFF blink_counter_308__i3 (.Q(n23), .C(CLK_c), .D(n132));   // verilog/TinyFPGA_B.v(46[24:41])
    SB_DFF blink_counter_308__i4 (.Q(n22), .C(CLK_c), .D(n131));   // verilog/TinyFPGA_B.v(46[24:41])
    SB_DFF blink_counter_308__i5 (.Q(n21), .C(CLK_c), .D(n130));   // verilog/TinyFPGA_B.v(46[24:41])
    SB_DFF blink_counter_308__i6 (.Q(n20), .C(CLK_c), .D(n129));   // verilog/TinyFPGA_B.v(46[24:41])
    SB_DFF blink_counter_308__i7 (.Q(n19), .C(CLK_c), .D(n128));   // verilog/TinyFPGA_B.v(46[24:41])
    SB_DFF blink_counter_308__i8 (.Q(n18), .C(CLK_c), .D(n127));   // verilog/TinyFPGA_B.v(46[24:41])
    SB_DFF blink_counter_308__i9 (.Q(n17), .C(CLK_c), .D(n126));   // verilog/TinyFPGA_B.v(46[24:41])
    SB_DFF blink_counter_308__i10 (.Q(n16), .C(CLK_c), .D(n125));   // verilog/TinyFPGA_B.v(46[24:41])
    SB_DFF blink_counter_308__i11 (.Q(n15), .C(CLK_c), .D(n124));   // verilog/TinyFPGA_B.v(46[24:41])
    SB_DFF blink_counter_308__i12 (.Q(n14), .C(CLK_c), .D(n123));   // verilog/TinyFPGA_B.v(46[24:41])
    SB_DFF blink_counter_308__i13 (.Q(n13), .C(CLK_c), .D(n122));   // verilog/TinyFPGA_B.v(46[24:41])
    SB_DFF blink_counter_308__i14 (.Q(n12), .C(CLK_c), .D(n121));   // verilog/TinyFPGA_B.v(46[24:41])
    SB_DFF blink_counter_308__i15 (.Q(n11_adj_926), .C(CLK_c), .D(n120));   // verilog/TinyFPGA_B.v(46[24:41])
    SB_DFF blink_counter_308__i16 (.Q(n10), .C(CLK_c), .D(n119));   // verilog/TinyFPGA_B.v(46[24:41])
    SB_DFF blink_counter_308__i17 (.Q(n9), .C(CLK_c), .D(n118));   // verilog/TinyFPGA_B.v(46[24:41])
    SB_DFF blink_counter_308__i18 (.Q(n8), .C(CLK_c), .D(n117));   // verilog/TinyFPGA_B.v(46[24:41])
    SB_DFF blink_counter_308__i19 (.Q(n7), .C(CLK_c), .D(n116));   // verilog/TinyFPGA_B.v(46[24:41])
    SB_DFF blink_counter_308__i20 (.Q(n6), .C(CLK_c), .D(n115));   // verilog/TinyFPGA_B.v(46[24:41])
    SB_DFF blink_counter_308__i21 (.Q(blink_counter[21]), .C(CLK_c), .D(n114));   // verilog/TinyFPGA_B.v(46[24:41])
    SB_DFF blink_counter_308__i22 (.Q(blink_counter[22]), .C(CLK_c), .D(n113));   // verilog/TinyFPGA_B.v(46[24:41])
    SB_DFF blink_counter_308__i23 (.Q(blink_counter[23]), .C(CLK_c), .D(n112));   // verilog/TinyFPGA_B.v(46[24:41])
    SB_DFF blink_counter_308__i24 (.Q(blink_counter[24]), .C(CLK_c), .D(n111));   // verilog/TinyFPGA_B.v(46[24:41])
    SB_DFF blink_counter_308__i25 (.Q(blink_counter[25]), .C(CLK_c), .D(n110));   // verilog/TinyFPGA_B.v(46[24:41])
    SB_LUT4 i1534_4_lut (.I0(n1739), .I1(r_Clock_Count_adj_975[1]), .I2(n319), 
            .I3(r_SM_Main_adj_974[2]), .O(n1755));   // roboy_fpga_code/roboy_fpga_code/uart/uart_tx.v(37[10] 140[8])
    defparam i1534_4_lut.LUT_INIT = 16'h88a0;
    SB_LUT4 i1_4_lut_adj_382 (.I0(tx_done), .I1(n4258), .I2(n859), .I3(r_SM_Main[2]), 
            .O(n4116));   // roboy_fpga_code/roboy_fpga_code/uart/uart_tx.v(37[10] 140[8])
    defparam i1_4_lut_adj_382.LUT_INIT = 16'hafec;
    SB_LUT4 i1580_4_lut (.I0(r_Rx_Data), .I1(o_Rx_Byte[1]), .I2(n4_adj_929), 
            .I3(n1272), .O(n1801));   // roboy_fpga_code/roboy_fpga_code/uart/uart_rx.v(49[10] 144[8])
    defparam i1580_4_lut.LUT_INIT = 16'hccca;
    SB_LUT4 i1638_4_lut (.I0(\data_out[7] [7]), .I1(n9_adj_965), .I2(n1553), 
            .I3(n10_adj_958), .O(n1859));   // coms.v(115[10] 136[6])
    defparam i1638_4_lut.LUT_INIT = 16'hca3a;
    SB_LUT4 i1550_4_lut (.I0(n1776), .I1(r_Clock_Count[6]), .I2(n314), 
            .I3(r_SM_Main[2]), .O(n1771));   // roboy_fpga_code/roboy_fpga_code/uart/uart_tx.v(37[10] 140[8])
    defparam i1550_4_lut.LUT_INIT = 16'h88a0;
    SB_LUT4 i1531_4_lut (.I0(n1739), .I1(r_Clock_Count_adj_975[2]), .I2(n318), 
            .I3(r_SM_Main_adj_974[2]), .O(n1752));   // roboy_fpga_code/roboy_fpga_code/uart/uart_tx.v(37[10] 140[8])
    defparam i1531_4_lut.LUT_INIT = 16'h88a0;
    SB_LUT4 i1640_4_lut (.I0(\data_out[7] [6]), .I1(n9_adj_960), .I2(n1553), 
            .I3(n10_adj_959), .O(n1861));   // coms.v(115[10] 136[6])
    defparam i1640_4_lut.LUT_INIT = 16'hca3a;
    SB_LUT4 i1641_3_lut (.I0(\data_out[7] [5]), .I1(n1347), .I2(n1553), 
            .I3(GND_net), .O(n1862));   // coms.v(115[10] 136[6])
    defparam i1641_3_lut.LUT_INIT = 16'hcaca;
    SB_LUT4 i1642_4_lut (.I0(\data_out[7] [4]), .I1(n9_adj_949), .I2(n1553), 
            .I3(n10_adj_946), .O(n1863));   // coms.v(115[10] 136[6])
    defparam i1642_4_lut.LUT_INIT = 16'hca3a;
    SB_LUT4 i1643_3_lut (.I0(\data_out[7] [3]), .I1(n4326), .I2(n1553), 
            .I3(GND_net), .O(n1864));   // coms.v(115[10] 136[6])
    defparam i1643_3_lut.LUT_INIT = 16'h3a3a;
    SB_LUT4 i1624_3_lut (.I0(r_Tx_Data_adj_977[0]), .I1(i_Tx_Byte_adj_973[0]), 
            .I2(n1049), .I3(GND_net), .O(n1845));   // roboy_fpga_code/roboy_fpga_code/uart/uart_tx.v(37[10] 140[8])
    defparam i1624_3_lut.LUT_INIT = 16'hcaca;
    SB_LUT4 i1556_4_lut (.I0(n1776), .I1(r_Clock_Count[4]), .I2(n316), 
            .I3(r_SM_Main[2]), .O(n1777));   // roboy_fpga_code/roboy_fpga_code/uart/uart_tx.v(37[10] 140[8])
    defparam i1556_4_lut.LUT_INIT = 16'h88a0;
    SB_LUT4 i1656_2_lut (.I0(n1553), .I1(data_out_field_30), .I2(GND_net), 
            .I3(GND_net), .O(n1877));   // coms.v(115[10] 136[6])
    defparam i1656_2_lut.LUT_INIT = 16'h4444;
    SB_LUT4 i1759_3_lut (.I0(\data_in[1] [5]), .I1(\data_in[2] [5]), .I2(rx_data_ready_keep), 
            .I3(GND_net), .O(n1980));   // coms.v(146[10] 154[6])
    defparam i1759_3_lut.LUT_INIT = 16'hcaca;
    SB_LUT4 i1644_4_lut (.I0(\data_out[7] [2]), .I1(n7_adj_948), .I2(n1553), 
            .I3(n8_adj_947), .O(n1865));   // coms.v(115[10] 136[6])
    defparam i1644_4_lut.LUT_INIT = 16'h3aca;
    SB_LUT4 blink_counter_308_add_4_25_lut (.I0(GND_net), .I1(GND_net), 
            .I2(blink_counter[23]), .I3(n3857), .O(n112)) /* synthesis syn_instantiated=1 */ ;
    defparam blink_counter_308_add_4_25_lut.LUT_INIT = 16'hC33C;
    SB_CARRY blink_counter_308_add_4_25 (.CI(n3857), .I0(GND_net), .I1(blink_counter[23]), 
            .CO(n3858));
    SB_LUT4 blink_counter_308_add_4_24_lut (.I0(GND_net), .I1(GND_net), 
            .I2(blink_counter[22]), .I3(n3856), .O(n113)) /* synthesis syn_instantiated=1 */ ;
    defparam blink_counter_308_add_4_24_lut.LUT_INIT = 16'hC33C;
    SB_CARRY blink_counter_308_add_4_24 (.CI(n3856), .I0(GND_net), .I1(blink_counter[22]), 
            .CO(n3857));
    SB_LUT4 i1657_2_lut (.I0(n1553), .I1(data_out_field_29), .I2(GND_net), 
            .I3(GND_net), .O(n1878));   // coms.v(115[10] 136[6])
    defparam i1657_2_lut.LUT_INIT = 16'h4444;
    SB_LUT4 i1645_4_lut (.I0(\data_out[7] [1]), .I1(n7_adj_955), .I2(n1553), 
            .I3(n8_adj_954), .O(n1866));   // coms.v(115[10] 136[6])
    defparam i1645_4_lut.LUT_INIT = 16'h3aca;
    SB_LUT4 blink_counter_308_add_4_23_lut (.I0(GND_net), .I1(GND_net), 
            .I2(blink_counter[21]), .I3(n3855), .O(n114)) /* synthesis syn_instantiated=1 */ ;
    defparam blink_counter_308_add_4_23_lut.LUT_INIT = 16'hC33C;
    SB_LUT4 i1740_3_lut (.I0(r_Tx_Data_adj_977[3]), .I1(i_Tx_Byte_adj_973[3]), 
            .I2(n1049), .I3(GND_net), .O(n1961));   // roboy_fpga_code/roboy_fpga_code/uart/uart_tx.v(37[10] 140[8])
    defparam i1740_3_lut.LUT_INIT = 16'hcaca;
    SB_LUT4 i1646_4_lut (.I0(\data_out[7] [0]), .I1(n7_adj_953), .I2(n1553), 
            .I3(n8_adj_952), .O(n1867));   // coms.v(115[10] 136[6])
    defparam i1646_4_lut.LUT_INIT = 16'h3aca;
    SB_CARRY blink_counter_308_add_4_23 (.CI(n3855), .I0(GND_net), .I1(blink_counter[21]), 
            .CO(n3856));
    SB_LUT4 i1711_3_lut_3_lut_4_lut (.I0(n1556), .I1(r_SM_Main[1]), .I2(n21_adj_964), 
            .I3(r_Bit_Index[0]), .O(n1932));   // roboy_fpga_code/roboy_fpga_code/uart/uart_tx.v(37[10] 140[8])
    defparam i1711_3_lut_3_lut_4_lut.LUT_INIT = 16'h5508;
    SB_LUT4 blink_counter_308_add_4_22_lut (.I0(GND_net), .I1(GND_net), 
            .I2(n6), .I3(n3854), .O(n115)) /* synthesis syn_instantiated=1 */ ;
    defparam blink_counter_308_add_4_22_lut.LUT_INIT = 16'hC33C;
    SB_CARRY blink_counter_308_add_4_22 (.CI(n3854), .I0(GND_net), .I1(n6), 
            .CO(n3855));
    SB_LUT4 blink_counter_308_add_4_21_lut (.I0(GND_net), .I1(GND_net), 
            .I2(n7), .I3(n3853), .O(n116)) /* synthesis syn_instantiated=1 */ ;
    defparam blink_counter_308_add_4_21_lut.LUT_INIT = 16'hC33C;
    SB_CARRY blink_counter_308_add_4_21 (.CI(n3853), .I0(GND_net), .I1(n7), 
            .CO(n3854));
    SB_LUT4 blink_counter_308_add_4_20_lut (.I0(GND_net), .I1(GND_net), 
            .I2(n8), .I3(n3852), .O(n117)) /* synthesis syn_instantiated=1 */ ;
    defparam blink_counter_308_add_4_20_lut.LUT_INIT = 16'hC33C;
    SB_CARRY blink_counter_308_add_4_20 (.CI(n3852), .I0(GND_net), .I1(n8), 
            .CO(n3853));
    SB_LUT4 i1588_4_lut_4_lut (.I0(n1556), .I1(n1671), .I2(r_Bit_Index[1]), 
            .I3(r_Bit_Index[0]), .O(n1809));   // roboy_fpga_code/roboy_fpga_code/uart/uart_tx.v(37[10] 140[8])
    defparam i1588_4_lut_4_lut.LUT_INIT = 16'h58d0;
    SB_LUT4 blink_counter_308_add_4_19_lut (.I0(GND_net), .I1(GND_net), 
            .I2(n9), .I3(n3851), .O(n118)) /* synthesis syn_instantiated=1 */ ;
    defparam blink_counter_308_add_4_19_lut.LUT_INIT = 16'hC33C;
    SB_CARRY blink_counter_308_add_4_19 (.CI(n3851), .I0(GND_net), .I1(n9), 
            .CO(n3852));
    SB_LUT4 i1738_3_lut (.I0(r_Tx_Data_adj_977[1]), .I1(i_Tx_Byte_adj_973[1]), 
            .I2(n1049), .I3(GND_net), .O(n1959));   // roboy_fpga_code/roboy_fpga_code/uart/uart_tx.v(37[10] 140[8])
    defparam i1738_3_lut.LUT_INIT = 16'hcaca;
    SB_LUT4 i1647_4_lut (.I0(\data_out[6] [7]), .I1(n11_adj_957), .I2(n1553), 
            .I3(n12_adj_956), .O(n1868));   // coms.v(115[10] 136[6])
    defparam i1647_4_lut.LUT_INIT = 16'h3aca;
    SB_LUT4 i1658_2_lut (.I0(n1553), .I1(data_out_field_28), .I2(GND_net), 
            .I3(GND_net), .O(n1879));   // coms.v(115[10] 136[6])
    defparam i1658_2_lut.LUT_INIT = 16'h4444;
    SB_LUT4 i4290_4_lut (.I0(data_out_field_43), .I1(n4300), .I2(data_out_field_26), 
            .I3(n4331), .O(n4573));   // coms.v(115[10] 136[6])
    defparam i4290_4_lut.LUT_INIT = 16'h6996;
    GND i1 (.Y(GND_net));
    SB_LUT4 i1648_3_lut (.I0(\data_out[6] [6]), .I1(n4573), .I2(n1553), 
            .I3(GND_net), .O(n1869));   // coms.v(115[10] 136[6])
    defparam i1648_3_lut.LUT_INIT = 16'hcaca;
    SB_LUT4 i1659_2_lut (.I0(n1553), .I1(data_out_field_27), .I2(GND_net), 
            .I3(GND_net), .O(n1880));   // coms.v(115[10] 136[6])
    defparam i1659_2_lut.LUT_INIT = 16'h4444;
    SB_LUT4 blink_counter_308_add_4_18_lut (.I0(GND_net), .I1(GND_net), 
            .I2(n10), .I3(n3850), .O(n119)) /* synthesis syn_instantiated=1 */ ;
    defparam blink_counter_308_add_4_18_lut.LUT_INIT = 16'hC33C;
    SB_LUT4 i1660_2_lut (.I0(n1553), .I1(data_out_field_26), .I2(GND_net), 
            .I3(GND_net), .O(n1881));   // coms.v(115[10] 136[6])
    defparam i1660_2_lut.LUT_INIT = 16'h4444;
    SB_CARRY blink_counter_308_add_4_18 (.CI(n3850), .I0(GND_net), .I1(n10), 
            .CO(n3851));
    SB_LUT4 i1_2_lut_4_lut (.I0(r_SM_Main[0]), .I1(r_SM_Main[1]), .I2(r_SM_Main_2__N_733[1]), 
            .I3(r_SM_Main[2]), .O(n4259));   // roboy_fpga_code/roboy_fpga_code/uart/uart_tx.v(37[10] 140[8])
    defparam i1_2_lut_4_lut.LUT_INIT = 16'h0080;
    SB_LUT4 blink_counter_308_add_4_17_lut (.I0(GND_net), .I1(GND_net), 
            .I2(n11_adj_926), .I3(n3849), .O(n120)) /* synthesis syn_instantiated=1 */ ;
    defparam blink_counter_308_add_4_17_lut.LUT_INIT = 16'hC33C;
    SB_CARRY blink_counter_308_add_4_17 (.CI(n3849), .I0(GND_net), .I1(n11_adj_926), 
            .CO(n3850));
    SB_LUT4 blink_counter_308_add_4_16_lut (.I0(GND_net), .I1(GND_net), 
            .I2(n12), .I3(n3848), .O(n121)) /* synthesis syn_instantiated=1 */ ;
    defparam blink_counter_308_add_4_16_lut.LUT_INIT = 16'hC33C;
    SB_CARRY blink_counter_308_add_4_16 (.CI(n3848), .I0(GND_net), .I1(n12), 
            .CO(n3849));
    SB_LUT4 i1760_3_lut (.I0(\data_in[1] [6]), .I1(\data_in[2] [6]), .I2(rx_data_ready_keep), 
            .I3(GND_net), .O(n1981));   // coms.v(146[10] 154[6])
    defparam i1760_3_lut.LUT_INIT = 16'hcaca;
    SB_LUT4 i1770_3_lut (.I0(\data_in[3] [0]), .I1(\data_in[4] [0]), .I2(rx_data_ready_keep), 
            .I3(GND_net), .O(n1991));   // coms.v(146[10] 154[6])
    defparam i1770_3_lut.LUT_INIT = 16'hcaca;
    SB_LUT4 i1649_4_lut (.I0(\data_out[6] [5]), .I1(n4_adj_966), .I2(n1553), 
            .I3(n4331), .O(n1870));   // coms.v(115[10] 136[6])
    defparam i1649_4_lut.LUT_INIT = 16'h3aca;
    SB_LUT4 i1742_3_lut (.I0(r_Tx_Data_adj_977[5]), .I1(i_Tx_Byte_adj_973[5]), 
            .I2(n1049), .I3(GND_net), .O(n1963));   // roboy_fpga_code/roboy_fpga_code/uart/uart_tx.v(37[10] 140[8])
    defparam i1742_3_lut.LUT_INIT = 16'hcaca;
    SB_LUT4 i1743_3_lut (.I0(r_Tx_Data_adj_977[6]), .I1(i_Tx_Byte_adj_973[6]), 
            .I2(n1049), .I3(GND_net), .O(n1964));   // roboy_fpga_code/roboy_fpga_code/uart/uart_tx.v(37[10] 140[8])
    defparam i1743_3_lut.LUT_INIT = 16'hcaca;
    SB_LUT4 i1650_3_lut (.I0(\data_out[6] [4]), .I1(n1300), .I2(n1553), 
            .I3(GND_net), .O(n1871));   // coms.v(115[10] 136[6])
    defparam i1650_3_lut.LUT_INIT = 16'hcaca;
    SB_LUT4 blink_counter_308_add_4_15_lut (.I0(GND_net), .I1(GND_net), 
            .I2(n13), .I3(n3847), .O(n122)) /* synthesis syn_instantiated=1 */ ;
    defparam blink_counter_308_add_4_15_lut.LUT_INIT = 16'hC33C;
    SB_CARRY blink_counter_308_add_4_15 (.CI(n3847), .I0(GND_net), .I1(n13), 
            .CO(n3848));
    SB_LUT4 blink_counter_308_add_4_14_lut (.I0(GND_net), .I1(GND_net), 
            .I2(n14), .I3(n3846), .O(n123)) /* synthesis syn_instantiated=1 */ ;
    defparam blink_counter_308_add_4_14_lut.LUT_INIT = 16'hC33C;
    SB_CARRY blink_counter_308_add_4_14 (.CI(n3846), .I0(GND_net), .I1(n14), 
            .CO(n3847));
    SB_LUT4 blink_counter_308_add_4_13_lut (.I0(GND_net), .I1(GND_net), 
            .I2(n15), .I3(n3845), .O(n124)) /* synthesis syn_instantiated=1 */ ;
    defparam blink_counter_308_add_4_13_lut.LUT_INIT = 16'hC33C;
    SB_CARRY blink_counter_308_add_4_13 (.CI(n3845), .I0(GND_net), .I1(n15), 
            .CO(n3846));
    SB_LUT4 i1651_4_lut (.I0(\data_out[6] [3]), .I1(n7_adj_951), .I2(n1553), 
            .I3(n8_adj_950), .O(n1872));   // coms.v(115[10] 136[6])
    defparam i1651_4_lut.LUT_INIT = 16'h3aca;
    SB_LUT4 i20_4_lut_4_lut (.I0(r_SM_Main_adj_969[1]), .I1(r_SM_Main_adj_969[2]), 
            .I2(r_SM_Main_2__N_789[2]), .I3(r_SM_Main_adj_969[0]), .O(n1522));   // roboy_fpga_code/roboy_fpga_code/uart/uart_rx.v(49[10] 144[8])
    defparam i20_4_lut_4_lut.LUT_INIT = 16'h2055;
    SB_LUT4 i12_3_lut_4_lut (.I0(r_SM_Main_adj_969[1]), .I1(r_SM_Main_adj_969[2]), 
            .I2(n1522), .I3(rx_data_ready), .O(n4078));   // roboy_fpga_code/roboy_fpga_code/uart/uart_rx.v(49[10] 144[8])
    defparam i12_3_lut_4_lut.LUT_INIT = 16'h2f20;
    SB_LUT4 blink_counter_308_add_4_12_lut (.I0(GND_net), .I1(GND_net), 
            .I2(n16), .I3(n3844), .O(n125)) /* synthesis syn_instantiated=1 */ ;
    defparam blink_counter_308_add_4_12_lut.LUT_INIT = 16'hC33C;
    SB_LUT4 i1652_4_lut (.I0(\data_out[6] [2]), .I1(n7_adj_962), .I2(n1553), 
            .I3(n8_adj_961), .O(n1873));   // coms.v(115[10] 136[6])
    defparam i1652_4_lut.LUT_INIT = 16'h3aca;
    SB_LUT4 i1594_4_lut (.I0(n1739), .I1(r_Clock_Count_adj_975[0]), .I2(n320), 
            .I3(r_SM_Main_adj_974[2]), .O(n1815));   // roboy_fpga_code/roboy_fpga_code/uart/uart_tx.v(37[10] 140[8])
    defparam i1594_4_lut.LUT_INIT = 16'h88a0;
    SB_CARRY blink_counter_308_add_4_12 (.CI(n3844), .I0(GND_net), .I1(n16), 
            .CO(n3845));
    SB_LUT4 i1780_3_lut (.I0(\data_in[4] [2]), .I1(\data_in[5] [2]), .I2(rx_data_ready_keep), 
            .I3(GND_net), .O(n2001));   // coms.v(146[10] 154[6])
    defparam i1780_3_lut.LUT_INIT = 16'hcaca;
    SB_LUT4 i1653_4_lut (.I0(\data_out[6] [1]), .I1(n4_adj_963), .I2(n1553), 
            .I3(n4322), .O(n1874));   // coms.v(115[10] 136[6])
    defparam i1653_4_lut.LUT_INIT = 16'h3aca;
    coms c0 (.\data_in[7] ({\data_in[7] }), .GND_net(GND_net), .\data_in[3] ({\data_in[3] }), 
         .\data_in[2] ({\data_in[2] }), .\data_in[0] ({\data_in[0] }), .n1882(n1882), 
         .CLK_c(CLK_c), .n1883(n1883), .n1884(n1884), .n1885(n1885), 
         .n1886(n1886), .n1887(n1887), .n1888(n1888), .n1889(n1889), 
         .n1890(n1890), .n1891(n1891), .n1892(n1892), .n1893(n1893), 
         .n1894(n1894), .n1895(n1895), .n1896(n1896), .n1897(n1897), 
         .n1898(n1898), .n1899(n1899), .n1900(n1900), .n1901(n1901), 
         .n1902(n1902), .n1903(n1903), .n1904(n1904), .n1905(n1905), 
         .n1906(n1906), .\data_out_field[22] (data_out_field_22), .\data_out_field[6] (data_out_field_6), 
         .n4334(n4334), .n1553(n1553), .\data_in[4] ({\data_in[4] }), 
         .\data_out[6] ({\data_out[6] }), .\data_out[7] ({\data_out[7] }), 
         .n2006(n2006), .VCC_net(VCC_net), .\data_out_field[14] (data_out_field_14), 
         .n2001(n2001), .\data_out_field[30] (data_out_field_30), .\data_in[6] ({\data_in[6] }), 
         .\data_out_field[3] (data_out_field_3), .\data_out_field[11] (data_out_field_11), 
         .\data_out_field[19] (data_out_field_19), .\data_out_field[27] (data_out_field_27), 
         .n1991(n1991), .\data_out_field[7] (data_out_field_7), .\data_out_field[15] (data_out_field_15), 
         .\data_out_field[23] (data_out_field_23), .\data_out_field[31] (data_out_field_31), 
         .n1981(n1981), .\data_in[1] ({\data_in[1] }), .n1881(n1881), 
         .n1880(n1880), .n1879(n1879), .\data_out_field[43] (data_out_field_43), 
         .\data_out_field[34] (data_out_field_34), .\data_out_field[29] (data_out_field_29), 
         .\data_out_field[28] (data_out_field_28), .\data_out_field[26] (data_out_field_26), 
         .\data_out_field[25] (data_out_field_25), .\data_out_field[24] (data_out_field_24), 
         .\data_out_field[21] (data_out_field_21), .\data_out_field[20] (data_out_field_20), 
         .\data_out_field[18] (data_out_field_18), .\data_out_field[17] (data_out_field_17), 
         .\data_out_field[16] (data_out_field_16), .\data_out_field[13] (data_out_field_13), 
         .\data_out_field[12] (data_out_field_12), .\data_out_field[10] (data_out_field_10), 
         .\data_out_field[9] (data_out_field_9), .\data_out_field[8] (data_out_field_8), 
         .\data_out_field[5] (data_out_field_5), .\data_out_field[4] (data_out_field_4), 
         .\data_out_field[2] (data_out_field_2), .\data_out_field[1] (data_out_field_1), 
         .\data_out_field[0] (data_out_field_0), .\tx_data[6]_keep (i_Tx_Byte[6]), 
         .\tx_data[5]_keep (i_Tx_Byte[5]), .\tx_data[4]_keep (i_Tx_Byte[4]), 
         .\tx_data[2]_keep (i_Tx_Byte[2]), .\tx_data[1]_keep (i_Tx_Byte[1]), 
         .\tx_data[0]_keep (i_Tx_Byte[0]), .n1880_adj_3(n1880_adj_924), 
         .n1882_adj_4(n1882_adj_917), .n1884_adj_5(n1884_adj_918), .n1886_adj_6(n1886_adj_919), 
         .n1888_adj_7(n1888_adj_920), .n1890_adj_8(n1890_adj_921), .n1892_adj_9(n1892_adj_922), 
         .n1894_adj_10(n1894_adj_923), .i_Tx_Byte({i_Tx_Byte_adj_973}), 
         .tx_active(tx_active), .PIN_1_c(PIN_1_c), .tx_o(tx_o), .tx_done(tx_done), 
         .PIN_2_c(PIN_2_c), .rx_data_ready_keep(rx_data_ready_keep), .rx_data_ready(rx_data_ready), 
         .o_Rx_Byte({o_Rx_Byte}), .tx2_active(tx2_active), .PIN_3_c(PIN_3_c), 
         .tx2_o(tx2_o), .tx2_done(tx2_done), .n1878(n1878), .n1980(n1980), 
         .n1877(n1877), .n1990(n1990), .n1969(n1969), .n1979(n1979), 
         .n1976(n1976), .n1974(n1974), .n1973(n1973), .n1975(n1975), 
         .n1972(n1972), .n1989(n1989), .n2000(n2000), .n1988(n1988), 
         .n1978(n1978), .n1987(n1987), .n1999(n1999), .n1986(n1986), 
         .n1998(n1998), .n2005(n2005), .n1997(n1997), .n1985(n1985), 
         .n1977(n1977), .n1984(n1984), .n1996(n1996), .n1983(n1983), 
         .n1995(n1995), .n2004(n2004), .n1994(n1994), .n1982(n1982), 
         .n1993(n1993), .n2003(n2003), .n1992(n1992), .n2002(n2002), 
         .n1971(n1971), .n1970(n1970), .n1968(n1968), .\data_in[5] ({\data_in[5] }), 
         .n2030(n2030), .n2029(n2029), .n2028(n2028), .n10(n10_adj_958), 
         .n10_adj_11(n10_adj_959), .n10_adj_12(n10_adj_946), .n4(n4_adj_963), 
         .n4326(n4326), .n8(n8_adj_947), .n7(n7_adj_962), .n2027(n2027), 
         .n2026(n2026), .n7_adj_13(n7_adj_951), .n1300(n1300), .n8_adj_14(n8_adj_952), 
         .n8_adj_15(n8_adj_950), .n1347(n1347), .n7_adj_16(n7_adj_953), 
         .n4_adj_17(n4_adj_966), .n1876(n1876), .n1875(n1875), .n1874(n1874), 
         .n1873(n1873), .n1872(n1872), .n1871(n1871), .n1870(n1870), 
         .n1869(n1869), .n1868(n1868), .n1867(n1867), .n1866(n1866), 
         .n1865(n1865), .n1864(n1864), .n1863(n1863), .n1862(n1862), 
         .n1861(n1861), .n1859(n1859), .n4322(n4322), .n1853(n1853), 
         .n7_adj_18(n7_adj_948), .n9(n9_adj_960), .n1737(n1737), .n2024(n2024), 
         .n2025(n2025), .n2023(n2023), .n12(n12_adj_956), .n2021(n2021), 
         .n2022(n2022), .n2019(n2019), .n2020(n2020), .n2017(n2017), 
         .n2018(n2018), .n2015(n2015), .n2016(n2016), .n2013(n2013), 
         .n2014(n2014), .n2011(n2011), .n2012(n2012), .n2009(n2009), 
         .n11(n11_adj_957), .n2010(n2010), .n2008(n2008), .n4300(n4300), 
         .n2007(n2007), .n4331(n4331), .n1291(n1291), .n8_adj_19(n8_adj_954), 
         .n9_adj_20(n9_adj_965), .n9_adj_21(n9_adj_949), .n7_adj_22(n7_adj_955), 
         .n8_adj_23(n8_adj_961), .n1776(n1776), .n1834(n1834), .r_SM_Main({r_SM_Main}), 
         .n1833(n1833), .\r_Tx_Data[0] (r_Tx_Data[0]), .n1832(n1832), 
         .n1831(n1831), .n1149(n1149), .n314(n314), .\r_Clock_Count[6] (r_Clock_Count[6]), 
         .\r_Bit_Index[0] (r_Bit_Index[0]), .n3(n3), .\r_Bit_Index[1] (r_Bit_Index[1]), 
         .n21(n21_adj_964), .\r_Clock_Count[5] (r_Clock_Count[5]), .\r_Clock_Count[4] (r_Clock_Count[4]), 
         .\r_Clock_Count[7] (r_Clock_Count[7]), .\r_Clock_Count[8] (r_Clock_Count[8]), 
         .\r_SM_Main_2__N_733[1] (r_SM_Main_2__N_733[1]), .n41(n41), .n4270(n4270), 
         .n1809(n1809), .\r_Tx_Data[5] (r_Tx_Data[5]), .\r_Tx_Data[1] (r_Tx_Data[1]), 
         .n1777(n1777), .n315(n315), .n1765(n1765), .n859(n859), .n1940(n1940), 
         .\r_Tx_Data[6] (r_Tx_Data[6]), .n1939(n1939), .n1938(n1938), 
         .\r_Tx_Data[4] (r_Tx_Data[4]), .n1936(n1936), .\r_Tx_Data[2] (r_Tx_Data[2]), 
         .n1556(n1556), .n1768(n1768), .n1771(n1771), .n4116(n4116), 
         .n1774(n1774), .n1932(n1932), .n1935(n1935), .n4259(n4259), 
         .n1671(n1671), .n316(n316), .n312(n312), .n313(n313), .r_Tx_Data({r_Tx_Data_adj_977}), 
         .\r_Clock_Count[0] (r_Clock_Count_adj_975[0]), .\r_Clock_Count[1] (r_Clock_Count_adj_975[1]), 
         .\r_Clock_Count[2] (r_Clock_Count_adj_975[2]), .\r_Clock_Count[3] (r_Clock_Count_adj_975[3]), 
         .r_SM_Main_adj_45({r_SM_Main_adj_974}), .n1739(n1739), .n3_adj_33(n3_adj_925), 
         .n1959(n1959), .n314_adj_34(n314_adj_945), .\r_Clock_Count[6]_adj_35 (r_Clock_Count_adj_975[6]), 
         .n1965(n1965), .n1962(n1962), .n4256(n4256), .n1960(n1960), 
         .n1749(n1749), .n317(n317), .n1815(n1815), .n1964(n1964), .n1963(n1963), 
         .n1961(n1961), .n1845(n1845), .n1752(n1752), .n1755(n1755), 
         .n4108(n4108), .n318(n318), .n1844(n1844), .n319(n319), .n1843(n1843), 
         .n320(n320), .n1740(n1740), .n4_adj_36(n4_adj_928), .n1049(n1049), 
         .n1801(n1801), .n1800(n1800), .n1799(n1799), .n1797(n1797), 
         .n1796(n1796), .n1795(n1795), .n1789(n1789), .r_Bit_Index({r_Bit_Index_adj_968}), 
         .n1793(n1793), .n1792(n1792), .\r_SM_Main_2__N_789[2] (r_SM_Main_2__N_789[2]), 
         .r_SM_Main_adj_46({r_SM_Main_adj_969}), .r_Rx_Data(r_Rx_Data), 
         .n4078(n4078), .n4423(n4423), .n607(n607), .n2717(n2717), .n1267(n1267), 
         .n4_adj_42(n4), .n4_adj_43(n4_adj_927), .n1828(n1828), .n1272(n1272), 
         .n4_adj_44(n4_adj_929), .n1855(n1855), .n1788(n1788)) /* synthesis lattice_noprune=1, syn_preserve=0, syn_module_defined=1, syn_noprune=0 */ ;   // verilog/TinyFPGA_B.v(52[8] 57[4])
    SB_LUT4 i1747_3_lut (.I0(\data_in[0] [1]), .I1(\data_in[1] [1]), .I2(rx_data_ready_keep), 
            .I3(GND_net), .O(n1968));   // coms.v(146[10] 154[6])
    defparam i1747_3_lut.LUT_INIT = 16'hcaca;
    
endmodule
//
// Verilog Description of module coms
//
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
