Roboy/iceboard/software/adc_lvds/template_Implmnt/sbt/outputs/packer/TinyFPGA_B_lgc_sbt.pcf

set_location IN_MUX_bfv_1_18_0_ 1 18 0 #ICE_CARRY_IN_MUX
set_location IN_MUX_bfv_1_19_0_ 1 19 0 #ICE_CARRY_IN_MUX
set_location IN_MUX_bfv_1_20_0_ 1 20 0 #ICE_CARRY_IN_MUX
set_location IN_MUX_bfv_1_21_0_ 1 21 0 #ICE_CARRY_IN_MUX
set_location IN_MUX_bfv_5_23_0_ 5 23 0 #ICE_CARRY_IN_MUX
set_location IN_MUX_bfv_3_22_0_ 3 22 0 #ICE_CARRY_IN_MUX
set_location IN_MUX_bfv_3_23_0_ 3 23 0 #ICE_CARRY_IN_MUX
set_location IN_MUX_bfv_3_24_0_ 3 24 0 #ICE_CARRY_IN_MUX
set_location IN_MUX_bfv_3_25_0_ 3 25 0 #ICE_CARRY_IN_MUX
set_location IN_MUX_bfv_1_22_0_ 1 22 0 #ICE_CARRY_IN_MUX
set_location IN_MUX_bfv_1_23_0_ 1 23 0 #ICE_CARRY_IN_MUX
set_location IN_MUX_bfv_1_24_0_ 1 24 0 #ICE_CARRY_IN_MUX
set_location IN_MUX_bfv_1_25_0_ 1 25 0 #ICE_CARRY_IN_MUX
set_location IN_MUX_bfv_2_23_0_ 2 23 0 #ICE_CARRY_IN_MUX
set_location IN_MUX_bfv_2_24_0_ 2 24 0 #ICE_CARRY_IN_MUX
set_location IN_MUX_bfv_2_25_0_ 2 25 0 #ICE_CARRY_IN_MUX
set_location IN_MUX_bfv_2_26_0_ 2 26 0 #ICE_CARRY_IN_MUX
set_location i710_4_lut_send_29_REP_LUT4_0 4 23 6 #SB_LUT4
set_location i708_4_lut_clk_slow_25_REP_LUT4_0 2 22 7 #SB_LUT4
set_location uart.r_Tx_Data_i7 4 21 5 #SB_DFF
set_location uart.r_Tx_Data_i6 4 20 6 #SB_DFF
set_location uart.r_Tx_Data_i5 4 20 3 #SB_DFF
set_location uart.r_Tx_Data_i4 4 20 0 #SB_DFF
set_location uart.r_Tx_Data_i3 4 21 3 #SB_DFF
set_location uart.r_Tx_Data_i2 4 21 7 #SB_DFF
set_location uart.r_Tx_Data_i1 4 21 2 #SB_DFF
set_location uart.r_Tx_Data_i0 4 21 6 #SB_DFF
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
set_location blink_counter_119__i11 2 24 3 #SB_DFF
set_location blink_counter_119__i10 2 24 2 #SB_DFF
set_location blink_counter_119__i1 2 23 1 #SB_DFF
set_location blink_counter_119__i0 2 23 0 #SB_DFF
set_io PIN_2 A1
set_io PIN_18 A9
set_io PIN_13 H2
set_io LED B3
set_io CLK B2
