Roboy/iceboard/software/adc_lvds/quad_prim.v

// Verilog netlist produced by program LSE :  version Diamond Version 0.0.0
// Netlist written on Sun Aug 25 18:39:20 2019
//
// Verilog Description of module quad
//

module quad (clk, quadA, quadB, count) /* synthesis syn_module_defined=1 */ ;   // quad.v(3[8:12])
    input clk;   // quad.v(4[9:12])
    input quadA;   // quad.v(5[9:14])
    input quadB;   // quad.v(6[9:14])
    output [31:0]count;   // quad.v(7[21:26])
    
    wire clk_c /* synthesis is_clock=1, SET_AS_NETWORK=clk_c */ ;   // quad.v(4[9:12])
    
    wire GND_net, VCC_net, quadA_c, quadB_c, count_c_31, count_c_30, 
        count_c_29, count_c_28, count_c_27, count_c_26, count_c_25, 
        count_c_24, count_c_23, count_c_22, count_c_21, count_c_20, 
        count_c_19, count_c_18, count_c_17, count_c_16, count_c_15, 
        count_c_14, count_c_13, count_c_12, count_c_11, count_c_10, 
        count_c_9, count_c_8, count_c_7, count_c_6, count_c_5, count_c_4, 
        count_c_3, count_c_2, count_c_1, count_c_0, quadA_delayed, 
        quadB_delayed, count_enable, count_direction, n450, n449, 
        n356, n355, n448, n447, n446, n323, n445, n444, n443, 
        n442, n441, n440, n439, n438, n437, n436, n435, n434, 
        n433, n432, n431, n430, n429, n428, n427, n426, n425, 
        n424, n423, n422, n421, n420, n419, n353, n354, n384, 
        n383, n382, n381, n380, n379, n378, n377, n376, n375, 
        n374, n373, n372, n371, n370, n369, n368, n367, n366, 
        n365, n364, n363, n362, n361, n360, n359, n358, n357;
    
    VCC i100 (.Y(VCC_net));
    SB_DFFE count_i0_i1 (.Q(count_c_0), .C(clk_c), .E(count_enable), .D(n384));   // quad.v(16[10] 22[6])
    SB_IO quadB_pad (.PACKAGE_PIN(quadB), .OUTPUT_ENABLE(VCC_net), .D_IN_0(quadB_c));   // /home/letrend/lscc/iCEcube2.2017.08/LSE/userware/unix/SYNTHESIS_HEADERS/sb_ice40.v(502[8:13])
    defparam quadB_pad.PIN_TYPE = 6'b000001;
    defparam quadB_pad.PULLUP = 1'b0;
    defparam quadB_pad.NEG_TRIGGER = 1'b0;
    defparam quadB_pad.IO_STANDARD = "SB_LVCMOS";
    SB_LUT4 i72_1_lut_2_lut (.I0(quadA_c), .I1(quadB_delayed), .I2(GND_net), 
            .I3(GND_net), .O(n323));   // quad.v(18[5] 21[8])
    defparam i72_1_lut_2_lut.LUT_INIT = 16'h9999;
    GND i143 (.Y(GND_net));
    SB_IO quadA_pad (.PACKAGE_PIN(quadA), .OUTPUT_ENABLE(VCC_net), .D_IN_0(quadA_c));   // /home/letrend/lscc/iCEcube2.2017.08/LSE/userware/unix/SYNTHESIS_HEADERS/sb_ice40.v(502[8:13])
    defparam quadA_pad.PIN_TYPE = 6'b000001;
    defparam quadA_pad.PULLUP = 1'b0;
    defparam quadA_pad.NEG_TRIGGER = 1'b0;
    defparam quadA_pad.IO_STANDARD = "SB_LVCMOS";
    SB_IO count_pad_2 (.PACKAGE_PIN(count[2]), .OUTPUT_ENABLE(VCC_net), 
          .D_OUT_0(count_c_2));   // /home/letrend/lscc/iCEcube2.2017.08/LSE/userware/unix/SYNTHESIS_HEADERS/sb_ice40.v(502[8:13])
    defparam count_pad_2.PIN_TYPE = 6'b011001;
    defparam count_pad_2.PULLUP = 1'b0;
    defparam count_pad_2.NEG_TRIGGER = 1'b0;
    defparam count_pad_2.IO_STANDARD = "SB_LVCMOS";
    SB_IO count_pad_3 (.PACKAGE_PIN(count[3]), .OUTPUT_ENABLE(VCC_net), 
          .D_OUT_0(count_c_3));   // /home/letrend/lscc/iCEcube2.2017.08/LSE/userware/unix/SYNTHESIS_HEADERS/sb_ice40.v(502[8:13])
    defparam count_pad_3.PIN_TYPE = 6'b011001;
    defparam count_pad_3.PULLUP = 1'b0;
    defparam count_pad_3.NEG_TRIGGER = 1'b0;
    defparam count_pad_3.IO_STANDARD = "SB_LVCMOS";
    SB_IO count_pad_4 (.PACKAGE_PIN(count[4]), .OUTPUT_ENABLE(VCC_net), 
          .D_OUT_0(count_c_4));   // /home/letrend/lscc/iCEcube2.2017.08/LSE/userware/unix/SYNTHESIS_HEADERS/sb_ice40.v(502[8:13])
    defparam count_pad_4.PIN_TYPE = 6'b011001;
    defparam count_pad_4.PULLUP = 1'b0;
    defparam count_pad_4.NEG_TRIGGER = 1'b0;
    defparam count_pad_4.IO_STANDARD = "SB_LVCMOS";
    SB_DFFE count_i0_i2 (.Q(count_c_1), .C(clk_c), .E(count_enable), .D(n383));   // quad.v(16[10] 22[6])
    SB_IO count_pad_5 (.PACKAGE_PIN(count[5]), .OUTPUT_ENABLE(VCC_net), 
          .D_OUT_0(count_c_5));   // /home/letrend/lscc/iCEcube2.2017.08/LSE/userware/unix/SYNTHESIS_HEADERS/sb_ice40.v(502[8:13])
    defparam count_pad_5.PIN_TYPE = 6'b011001;
    defparam count_pad_5.PULLUP = 1'b0;
    defparam count_pad_5.NEG_TRIGGER = 1'b0;
    defparam count_pad_5.IO_STANDARD = "SB_LVCMOS";
    SB_LUT4 i2_3_lut_4_lut (.I0(quadA_delayed), .I1(quadA_c), .I2(quadB_delayed), 
            .I3(quadB_c), .O(count_enable));   // quad.v(13[23:68])
    defparam i2_3_lut_4_lut.LUT_INIT = 16'h6996;
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
    defparam count_pad_29.PIN_TYPE = 6'b011001;
    defparam count_pad_29.PULLUP = 1'b0;
    defparam count_pad_29.NEG_TRIGGER = 1'b0;
    defparam count_pad_29.IO_STANDARD = "SB_LVCMOS";
    SB_IO count_pad_30 (.PACKAGE_PIN(count[30]), .OUTPUT_ENABLE(VCC_net), 
          .D_OUT_0(count_c_30));   // /home/letrend/lscc/iCEcube2.2017.08/LSE/userware/unix/SYNTHESIS_HEADERS/sb_ice40.v(502[8:13])
    defparam count_pad_30.PIN_TYPE = 6'b011001;
    defparam count_pad_30.PULLUP = 1'b0;
    defparam count_pad_30.NEG_TRIGGER = 1'b0;
    defparam count_pad_30.IO_STANDARD = "SB_LVCMOS";
    SB_GB_IO clk_pad (.PACKAGE_PIN(clk), .OUTPUT_ENABLE(VCC_net), .GLOBAL_BUFFER_OUTPUT(clk_c));   // quad.v(4[9:12])
    defparam clk_pad.PIN_TYPE = 6'b000001;
    defparam clk_pad.PULLUP = 1'b0;
    defparam clk_pad.NEG_TRIGGER = 1'b0;
    defparam clk_pad.IO_STANDARD = "SB_LVCMOS";
    SB_DFF quadB_delayed_16 (.Q(quadB_delayed), .C(clk_c), .D(quadB_c));   // quad.v(11[10:48])
    SB_IO count_pad_31 (.PACKAGE_PIN(count[31]), .OUTPUT_ENABLE(VCC_net), 
          .D_OUT_0(count_c_31));   // /home/letrend/lscc/iCEcube2.2017.08/LSE/userware/unix/SYNTHESIS_HEADERS/sb_ice40.v(502[8:13])
    defparam count_pad_31.PIN_TYPE = 6'b011001;
    defparam count_pad_31.PULLUP = 1'b0;
    defparam count_pad_31.NEG_TRIGGER = 1'b0;
    defparam count_pad_31.IO_STANDARD = "SB_LVCMOS";
    SB_CARRY add_66_17 (.CI(n434), .I0(count_c_15), .I1(n323), .CO(n435));
    SB_DFFE count_i0_i3 (.Q(count_c_2), .C(clk_c), .E(count_enable), .D(n382));   // quad.v(16[10] 22[6])
    SB_LUT4 add_66_16_lut (.I0(GND_net), .I1(count_c_14), .I2(n323), .I3(n433), 
            .O(n370)) /* synthesis syn_instantiated=1 */ ;
    defparam add_66_16_lut.LUT_INIT = 16'hC33C;
    SB_CARRY add_66_16 (.CI(n433), .I0(count_c_14), .I1(n323), .CO(n434));
    SB_LUT4 add_66_15_lut (.I0(GND_net), .I1(count_c_13), .I2(n323), .I3(n432), 
            .O(n371)) /* synthesis syn_instantiated=1 */ ;
    defparam add_66_15_lut.LUT_INIT = 16'hC33C;
    SB_CARRY add_66_15 (.CI(n432), .I0(count_c_13), .I1(n323), .CO(n433));
    SB_LUT4 add_66_14_lut (.I0(GND_net), .I1(count_c_12), .I2(n323), .I3(n431), 
            .O(n372)) /* synthesis syn_instantiated=1 */ ;
    defparam add_66_14_lut.LUT_INIT = 16'hC33C;
    SB_CARRY add_66_14 (.CI(n431), .I0(count_c_12), .I1(n323), .CO(n432));
    SB_LUT4 add_66_13_lut (.I0(GND_net), .I1(count_c_11), .I2(n323), .I3(n430), 
            .O(n373)) /* synthesis syn_instantiated=1 */ ;
    defparam add_66_13_lut.LUT_INIT = 16'hC33C;
    SB_CARRY add_66_13 (.CI(n430), .I0(count_c_11), .I1(n323), .CO(n431));
    SB_LUT4 add_66_12_lut (.I0(GND_net), .I1(count_c_10), .I2(n323), .I3(n429), 
            .O(n374)) /* synthesis syn_instantiated=1 */ ;
    defparam add_66_12_lut.LUT_INIT = 16'hC33C;
    SB_CARRY add_66_12 (.CI(n429), .I0(count_c_10), .I1(n323), .CO(n430));
    SB_LUT4 add_66_11_lut (.I0(GND_net), .I1(count_c_9), .I2(n323), .I3(n428), 
            .O(n375)) /* synthesis syn_instantiated=1 */ ;
    defparam add_66_11_lut.LUT_INIT = 16'hC33C;
    SB_CARRY add_66_11 (.CI(n428), .I0(count_c_9), .I1(n323), .CO(n429));
    SB_LUT4 add_66_10_lut (.I0(GND_net), .I1(count_c_8), .I2(n323), .I3(n427), 
            .O(n376)) /* synthesis syn_instantiated=1 */ ;
    defparam add_66_10_lut.LUT_INIT = 16'hC33C;
    SB_CARRY add_66_10 (.CI(n427), .I0(count_c_8), .I1(n323), .CO(n428));
    SB_LUT4 add_66_9_lut (.I0(GND_net), .I1(count_c_7), .I2(n323), .I3(n426), 
            .O(n377)) /* synthesis syn_instantiated=1 */ ;
    defparam add_66_9_lut.LUT_INIT = 16'hC33C;
    SB_CARRY add_66_9 (.CI(n426), .I0(count_c_7), .I1(n323), .CO(n427));
    SB_LUT4 add_66_8_lut (.I0(GND_net), .I1(count_c_6), .I2(n323), .I3(n425), 
            .O(n378)) /* synthesis syn_instantiated=1 */ ;
    defparam add_66_8_lut.LUT_INIT = 16'hC33C;
    SB_CARRY add_66_8 (.CI(n425), .I0(count_c_6), .I1(n323), .CO(n426));
    SB_LUT4 add_66_7_lut (.I0(GND_net), .I1(count_c_5), .I2(n323), .I3(n424), 
            .O(n379)) /* synthesis syn_instantiated=1 */ ;
    defparam add_66_7_lut.LUT_INIT = 16'hC33C;
    SB_CARRY add_66_7 (.CI(n424), .I0(count_c_5), .I1(n323), .CO(n425));
    SB_LUT4 add_66_6_lut (.I0(GND_net), .I1(count_c_4), .I2(n323), .I3(n423), 
            .O(n380)) /* synthesis syn_instantiated=1 */ ;
    defparam add_66_6_lut.LUT_INIT = 16'hC33C;
    SB_CARRY add_66_6 (.CI(n423), .I0(count_c_4), .I1(n323), .CO(n424));
    SB_LUT4 add_66_5_lut (.I0(GND_net), .I1(count_c_3), .I2(n323), .I3(n422), 
            .O(n381)) /* synthesis syn_instantiated=1 */ ;
    defparam add_66_5_lut.LUT_INIT = 16'hC33C;
    SB_CARRY add_66_5 (.CI(n422), .I0(count_c_3), .I1(n323), .CO(n423));
    SB_LUT4 add_66_4_lut (.I0(GND_net), .I1(count_c_2), .I2(n323), .I3(n421), 
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
    SB_CARRY add_66_28 (.CI(n445), .I0(count_c_26), .I1(n323), .CO(n446));
    SB_LUT4 add_66_28_lut (.I0(GND_net), .I1(count_c_26), .I2(n323), .I3(n445), 
            .O(n358)) /* synthesis syn_instantiated=1 */ ;
    defparam add_66_28_lut.LUT_INIT = 16'hC33C;
    SB_CARRY add_66_29 (.CI(n446), .I0(count_c_27), .I1(n323), .CO(n447));
    SB_LUT4 add_66_29_lut (.I0(GND_net), .I1(count_c_27), .I2(n323), .I3(n446), 
            .O(n357)) /* synthesis syn_instantiated=1 */ ;
    defparam add_66_29_lut.LUT_INIT = 16'hC33C;
    SB_CARRY add_66_30 (.CI(n447), .I0(count_c_28), .I1(n323), .CO(n448));
    SB_LUT4 add_66_30_lut (.I0(GND_net), .I1(count_c_28), .I2(n323), .I3(n447), 
            .O(n356)) /* synthesis syn_instantiated=1 */ ;
    defparam add_66_30_lut.LUT_INIT = 16'hC33C;
    SB_CARRY add_66_31 (.CI(n448), .I0(count_c_29), .I1(n323), .CO(n449));
    SB_LUT4 add_66_31_lut (.I0(GND_net), .I1(count_c_29), .I2(n323), .I3(n448), 
            .O(n355)) /* synthesis syn_instantiated=1 */ ;
    defparam add_66_31_lut.LUT_INIT = 16'hC33C;
    SB_CARRY add_66_32 (.CI(n449), .I0(count_c_30), .I1(n323), .CO(n450));
    SB_LUT4 add_66_32_lut (.I0(GND_net), .I1(count_c_30), .I2(n323), .I3(n449), 
            .O(n354)) /* synthesis syn_instantiated=1 */ ;
    defparam add_66_32_lut.LUT_INIT = 16'hC33C;
    SB_LUT4 add_66_33_lut (.I0(GND_net), .I1(count_c_31), .I2(n323), .I3(n450), 
            .O(n353)) /* synthesis syn_instantiated=1 */ ;
    defparam add_66_33_lut.LUT_INIT = 16'hC33C;
    SB_LUT4 i1_2_lut (.I0(quadA_c), .I1(quadB_delayed), .I2(GND_net), 
            .I3(GND_net), .O(count_direction));   // quad.v(13[23:68])
    defparam i1_2_lut.LUT_INIT = 16'h6666;
    
endmodule
