Roboy/iceboard/software/adc_lvds/verilog/pll96MHz.v

module TinyFPGA_B_pll(REFERENCECLK,
                      PLLOUTCORE,
                      PLLOUTGLOBAL,
                      RESET);

input REFERENCECLK;
input RESET;    /* To initialize the simulation properly, the RESET signal (Active Low) must be asserted at the beginning of the simulation */ 
output PLLOUTCORE;
output PLLOUTGLOBAL;

SB_PLL40_CORE TinyFPGA_B_pll_inst(.REFERENCECLK(REFERENCECLK),
                                  .PLLOUTCORE(PLLOUTCORE),
                                  .PLLOUTGLOBAL(PLLOUTGLOBAL),
                                  .EXTFEEDBACK(),
                                  .DYNAMICDELAY(),
                                  .RESETB(RESET),
                                  .BYPASS(1'b0),
                                  .LATCHINPUTVALUE(),
                                  .LOCK(),
                                  .SDI(),
                                  .SDO(),
                                  .SCLK());

//\\ Fin=16, Fout=96;
defparam TinyFPGA_B_pll_inst.DIVR = 4'b0000;
defparam TinyFPGA_B_pll_inst.DIVF = 7'b0101111;
defparam TinyFPGA_B_pll_inst.DIVQ = 3'b011;
defparam TinyFPGA_B_pll_inst.FILTER_RANGE = 3'b001;
defparam TinyFPGA_B_pll_inst.FEEDBACK_PATH = "SIMPLE";
defparam TinyFPGA_B_pll_inst.DELAY_ADJUSTMENT_MODE_FEEDBACK = "FIXED";
defparam TinyFPGA_B_pll_inst.FDA_FEEDBACK = 4'b0000;
defparam TinyFPGA_B_pll_inst.DELAY_ADJUSTMENT_MODE_RELATIVE = "FIXED";
defparam TinyFPGA_B_pll_inst.FDA_RELATIVE = 4'b0000;
defparam TinyFPGA_B_pll_inst.SHIFTREG_DIV_MODE = 2'b00;
defparam TinyFPGA_B_pll_inst.PLLOUT_SELECT = "GENCLK";
defparam TinyFPGA_B_pll_inst.ENABLE_ICEGATE = 1'b0;

endmodule
