Roboy/iceboard/software/adc_lvds/template_Implmnt/sbt/outputs/simulation_netlist/TinyFPGA_B_sbt.v

// ******************************************************************************

// iCEcube Netlister

// Version:            2017.08.27940

// Build Date:         Sep 12 2017 08:25:46

// File Generated:     Mar 24 2020 18:54:39

// Purpose:            Post-Route Verilog/VHDL netlist for timing simulation

// Copyright (C) 2006-2010 by Lattice Semiconductor Corp. All rights reserved.

// ******************************************************************************

// Verilog file for cell "TinyFPGA_B" view "INTERFACE"

module TinyFPGA_B (
    USBPU,
    SPI_IO2,
    PIN_9,
    PIN_8,
    PIN_7,
    PIN_6,
    PIN_5,
    PIN_4,
    PIN_3,
    PIN_24,
    PIN_23,
    PIN_22,
    PIN_21,
    PIN_20,
    PIN_2,
    PIN_19,
    PIN_18,
    PIN_17,
    PIN_16,
    PIN_15,
    PIN_14,
    PIN_13,
    PIN_12,
    PIN_11,
    PIN_10,
    PIN_1,
    LED,
    CLK);

    input USBPU;
    input SPI_IO2;
    input PIN_9;
    input PIN_8;
    input PIN_7;
    input PIN_6;
    input PIN_5;
    input PIN_4;
    input PIN_3;
    input PIN_24;
    input PIN_23;
    input PIN_22;
    input PIN_21;
    input PIN_20;
    output PIN_2;
    input PIN_19;
    output PIN_18;
    input PIN_17;
    input PIN_16;
    input PIN_15;
    input PIN_14;
    inout PIN_13;
    input PIN_12;
    input PIN_11;
    input PIN_10;
    input PIN_1;
    output LED;
    input CLK;

    wire N__5970;
    wire N__5969;
    wire N__5968;
    wire N__5961;
    wire N__5960;
    wire N__5959;
    wire N__5952;
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
    wire n2189;
    wire integrator_3;
    wire n2190;
    wire integrator_4;
    wire n2191;
    wire integrator_5;
    wire n2192;
    wire integrator_6;
    wire n2193;
    wire n2194;
    wire integrator_7;
    wire _gnd_net_;
    wire clk_slow;
    wire counter_31__N_172;

    defparam LED_pad_iopad.IO_STANDARD="SB_LVCMOS";
    defparam LED_pad_iopad.PULLUP=1'b0;
    IO_PAD LED_pad_iopad (
            .OE(N__5970),
            .DIN(N__5969),
            .DOUT(N__5968),
            .PACKAGEPIN(LED));
    defparam LED_pad_preio.PIN_TYPE=6'b011001;
    defparam LED_pad_preio.NEG_TRIGGER=1'b0;
    PRE_IO LED_pad_preio (
            .PADOEN(N__5970),
            .PADOUT(N__5969),
            .PADIN(N__5968),
            .CLOCKENABLE(),
            .DIN0(),
            .DIN1(),
            .DOUT0(N__4358),
            .DOUT1(),
            .INPUTCLK(),
            .LATCHINPUTVALUE(),
            .OUTPUTCLK(),
            .OUTPUTENABLE());
    defparam PIN_18_pad_iopad.IO_STANDARD="SB_LVCMOS";
    defparam PIN_18_pad_iopad.PULLUP=1'b0;
    IO_PAD PIN_18_pad_iopad (
            .OE(N__5961),
            .DIN(N__5960),
            .DOUT(N__5959),
            .PACKAGEPIN(PIN_18));
    defparam PIN_18_pad_preio.PIN_TYPE=6'b010101;
    defparam PIN_18_pad_preio.NEG_TRIGGER=1'b0;
    PRE_IO PIN_18_pad_preio (
            .PADOEN(N__5961),
            .PADOUT(N__5960),
            .PADIN(N__5959),
            .CLOCKENABLE(VCCG0),
            .DIN0(),
            .DIN1(),
            .DOUT0(N__5276),
            .DOUT1(),
            .INPUTCLK(),
            .LATCHINPUTVALUE(),
            .OUTPUTCLK(N__5825),
            .OUTPUTENABLE());
    defparam PIN_2_pad_iopad.IO_STANDARD="SB_LVCMOS";
    defparam PIN_2_pad_iopad.PULLUP=1'b0;
    IO_PAD PIN_2_pad_iopad (
            .OE(N__5952),
            .DIN(N__5951),
            .DOUT(N__5950),
            .PACKAGEPIN(PIN_2));
    defparam PIN_2_pad_preio.PIN_TYPE=6'b010101;
    defparam PIN_2_pad_preio.NEG_TRIGGER=1'b0;
    PRE_IO PIN_2_pad_preio (
            .PADOEN(N__5952),
            .PADOUT(N__5951),
            .PADIN(N__5950),
            .CLOCKENABLE(N__3107),
            .DIN0(),
            .DIN1(),
            .DOUT0(N__3911),
            .DOUT1(),
            .INPUTCLK(),
            .LATCHINPUTVALUE(),
            .OUTPUTCLK(N__5399),
            .OUTPUTENABLE());
    defparam differential_input_iopad.IO_STANDARD="SB_LVDS_INPUT";
    defparam differential_input_iopad.PULLUP=1'b0;
    IO_PAD differential_input_iopad (
            .OE(N__5943),
            .DIN(N__5942),
            .DOUT(N__5941),
            .PACKAGEPIN(PIN_13));
    defparam differential_input_preio.PIN_TYPE=6'b000001;
    defparam differential_input_preio.NEG_TRIGGER=1'b0;
    PRE_IO differential_input_preio (
            .PADOEN(N__5943),
            .PADOUT(N__5942),
            .PADIN(N__5941),
            .CLOCKENABLE(),
            .DIN0(diff_input),
            .DIN1(),
            .DOUT0(GNDG0),
            .DOUT1(GNDG0),
            .INPUTCLK(),
            .LATCHINPUTVALUE(),
            .OUTPUTCLK(),
            .OUTPUTENABLE());
    defparam CLK_pad_iopad.IO_STANDARD="SB_LVCMOS";
    defparam CLK_pad_iopad.PULLUP=1'b0;
    IO_PAD CLK_pad_iopad (
            .OE(N__5934),
            .DIN(N__5933),
            .DOUT(N__5932),
            .PACKAGEPIN(CLK));
    defparam CLK_pad_preio.PIN_TYPE=6'b000001;
    defparam CLK_pad_preio.NEG_TRIGGER=1'b0;
    PRE_IO CLK_pad_preio (
            .PADOEN(N__5934),
            .PADOUT(N__5933),
            .PADIN(N__5932),
            .CLOCKENABLE(),
            .DIN0(CLK_pad_gb_input),
            .DIN1(),
            .DOUT0(),
            .DOUT1(),
            .INPUTCLK(),
            .LATCHINPUTVALUE(),
            .OUTPUTCLK(),
            .OUTPUTENABLE());
    InMux I__1307 (
            .O(N__5915),
            .I(N__5911));
    InMux I__1306 (
            .O(N__5914),
            .I(N__5908));
    LocalMux I__1305 (
            .O(N__5911),
            .I(integrator_2));
    LocalMux I__1304 (
            .O(N__5908),
            .I(integrator_2));
    InMux I__1303 (
            .O(N__5903),
            .I(n2189));
    InMux I__1302 (
            .O(N__5900),
            .I(N__5896));
    InMux I__1301 (
            .O(N__5899),
            .I(N__5893));
    LocalMux I__1300 (
            .O(N__5896),
            .I(integrator_3));
    LocalMux I__1299 (
            .O(N__5893),
            .I(integrator_3));
    InMux I__1298 (
            .O(N__5888),
            .I(n2190));
    InMux I__1297 (
            .O(N__5885),
            .I(N__5881));
    InMux I__1296 (
            .O(N__5884),
            .I(N__5878));
    LocalMux I__1295 (
            .O(N__5881),
            .I(integrator_4));
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
            .in0(_gnd_net_),
            .in1(N__2936),
            .in2(_gnd_net_),
            .in3(N__2729),
            .lcout(\uart.r_Clock_Count_4 ),
            .ltout(),
            .carryin(\uart.n2135 ),
            .carryout(\uart.n2136 ),
            .clk(N__5379),
            .ce(N__3106),
            .sr(N__3216));
    defparam \uart.r_Clock_Count_121__i5_LC_1_18_5 .C_ON=1'b1;
    defparam \uart.r_Clock_Count_121__i5_LC_1_18_5 .SEQ_MODE=4'b1000;
    defparam \uart.r_Clock_Count_121__i5_LC_1_18_5 .LUT_INIT=16'b1100001100111100;
    LogicCell40 \uart.r_Clock_Count_121__i5_LC_1_18_5  (
            .in0(_gnd_net_),
            .in1(N__2948),
            .in2(_gnd_net_),
            .in3(N__2726),
            .lcout(\uart.r_Clock_Count_5 ),
            .ltout(),
            .carryin(\uart.n2136 ),
            .carryout(\uart.n2137 ),
            .clk(N__5379),
            .ce(N__3106),
            .sr(N__3216));
    defparam \uart.r_Clock_Count_121__i6_LC_1_18_6 .C_ON=1'b1;
    defparam \uart.r_Clock_Count_121__i6_LC_1_18_6 .SEQ_MODE=4'b1000;
    defparam \uart.r_Clock_Count_121__i6_LC_1_18_6 .LUT_INIT=16'b1100001100111100;
    LogicCell40 \uart.r_Clock_Count_121__i6_LC_1_18_6  (
            .in0(_gnd_net_),
            .in1(N__2921),
            .in2(_gnd_net_),
            .in3(N__2723),
            .lcout(\uart.r_Clock_Count_6 ),
            .ltout(),
            .carryin(\uart.n2137 ),
            .carryout(\uart.n2138 ),
            .clk(N__5379),
            .ce(N__3106),
            .sr(N__3216));
    defparam \uart.r_Clock_Count_121__i7_LC_1_18_7 .C_ON=1'b1;
    defparam \uart.r_Clock_Count_121__i7_LC_1_18_7 .SEQ_MODE=4'b1000;
    defparam \uart.r_Clock_Count_121__i7_LC_1_18_7 .LUT_INIT=16'b1100001100111100;
    LogicCell40 \uart.r_Clock_Count_121__i7_LC_1_18_7  (
            .in0(_gnd_net_),
            .in1(N__3248),
            .in2(_gnd_net_),
            .in3(N__2720),
            .lcout(\uart.r_Clock_Count_7 ),
            .ltout(),
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
