Roboy/iceboard/software/adc_lvds/template_Implmnt/sbt/outputs/simulation_netlist/TinyFPGA_B_sbt.vhd

-- ******************************************************************************

-- iCEcube Netlister

-- Version:            2017.08.27940

-- Build Date:         Sep 12 2017 08:26:01

-- File Generated:     Mar 24 2020 18:54:39

-- Purpose:            Post-Route Verilog/VHDL netlist for timing simulation

-- Copyright (C) 2006-2010 by Lattice Semiconductor Corp. All rights reserved.

-- ******************************************************************************

-- VHDL file for cell "TinyFPGA_B" view "INTERFACE"

library ieee;
use ieee.std_logic_1164.all;
use ieee.std_logic_arith.all;
use ieee.std_logic_unsigned.all;

library ice;
use ice.vcomponent_vital.all;

-- Entity of TinyFPGA_B
entity TinyFPGA_B is
port (
    USBPU : in std_logic;
    SPI_IO2 : in std_logic;
    PIN_9 : in std_logic;
    PIN_8 : in std_logic;
    PIN_7 : in std_logic;
    PIN_6 : in std_logic;
    PIN_5 : in std_logic;
    PIN_4 : in std_logic;
    PIN_3 : in std_logic;
    PIN_24 : in std_logic;
    PIN_23 : in std_logic;
    PIN_22 : in std_logic;
    PIN_21 : in std_logic;
    PIN_20 : in std_logic;
    PIN_2 : out std_logic;
    PIN_19 : in std_logic;
    PIN_18 : out std_logic;
    PIN_17 : in std_logic;
    PIN_16 : in std_logic;
    PIN_15 : in std_logic;
    PIN_14 : in std_logic;
    PIN_13 : inout std_logic;
    PIN_12 : in std_logic;
    PIN_11 : in std_logic;
    PIN_10 : in std_logic;
    PIN_1 : in std_logic;
    LED : out std_logic;
    CLK : in std_logic);
end TinyFPGA_B;

-- Architecture of TinyFPGA_B
-- View name is \INTERFACE\
architecture \INTERFACE\ of TinyFPGA_B is

signal \N__5970\ : std_logic;
signal \N__5969\ : std_logic;
signal \N__5968\ : std_logic;
signal \N__5961\ : std_logic;
signal \N__5960\ : std_logic;
signal \N__5959\ : std_logic;
signal \N__5952\ : std_logic;
signal \N__5951\ : std_logic;
signal \N__5950\ : std_logic;
signal \N__5943\ : std_logic;
signal \N__5942\ : std_logic;
signal \N__5941\ : std_logic;
signal \N__5934\ : std_logic;
signal \N__5933\ : std_logic;
signal \N__5932\ : std_logic;
signal \N__5915\ : std_logic;
signal \N__5914\ : std_logic;
signal \N__5911\ : std_logic;
signal \N__5908\ : std_logic;
signal \N__5903\ : std_logic;
signal \N__5900\ : std_logic;
signal \N__5899\ : std_logic;
signal \N__5896\ : std_logic;
signal \N__5893\ : std_logic;
signal \N__5888\ : std_logic;
signal \N__5885\ : std_logic;
signal \N__5884\ : std_logic;
signal \N__5881\ : std_logic;
signal \N__5878\ : std_logic;
signal \N__5873\ : std_logic;
signal \N__5870\ : std_logic;
signal \N__5869\ : std_logic;
signal \N__5866\ : std_logic;
signal \N__5863\ : std_logic;
signal \N__5858\ : std_logic;
signal \N__5855\ : std_logic;
signal \N__5854\ : std_logic;
signal \N__5851\ : std_logic;
signal \N__5848\ : std_logic;
signal \N__5843\ : std_logic;
signal \N__5840\ : std_logic;
signal \N__5837\ : std_logic;
signal \N__5836\ : std_logic;
signal \N__5833\ : std_logic;
signal \N__5830\ : std_logic;
signal \N__5825\ : std_logic;
signal \N__5822\ : std_logic;
signal \N__5819\ : std_logic;
signal \N__5816\ : std_logic;
signal \N__5815\ : std_logic;
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
signal n2207 : std_logic;
signal n2208 : std_logic;
signal n2209 : std_logic;
signal n2210 : std_logic;
signal \bfn_3_24_0_\ : std_logic;
signal n2211 : std_logic;
signal n2212 : std_logic;
signal n2213 : std_logic;
signal n2214 : std_logic;
signal n2215 : std_logic;
signal n2216 : std_logic;
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
