Roboy/iceboard/(commit log)

2019-09-22 with correct pinout for v0.3
    [TinyFPGA_B.v, TinyFPGA_B_prim.v]
2019-09-23 v0.4 ordered on pcbway
    [board-B_Cu.gbr, board-B_Mask.gbr, board-B_Paste.gbr, board-B_SilkS.gbr, board-Edge_Cuts.gbr, board-F_Cu.gbr, board-F_Mask.gbr, board-F_Paste.gbr]
2019-10-01 with v0.4 pin assignement
2019-10-01 ok the hall sensors are switched, FIX this next revision!
    [TinyFPGA_B.v, TinyFPGA_B_prim.v]
2019-10-04 fixed commutation for v0.4
    [TinyFPGA_B.v, TinyFPGA_B_prim.v, coms.v, motorControl.v]
2019-10-04 encoder works aswell
    [board.sch, inc_Sensor_interface.sch, mosfet_bridges.sch, power_conv.sch]
2019-10-04 fixed pwmlimit issue in motorcontroller
    [TinyFPGA_B_prim.v, motorControl.v]
2019-10-05 next version
    [4UCON_17809_02x10x1.27mm_Vertical.FCStd, 4UCON_17809_02x10x1.27mm_Vertical.step, 4UCON_17809_02x40x1.27mm_Vertical.FCStd, BGA-100_10x10_9.0x9.0mm_Pitch0.8mm.FCStd, BGA-100_10x10_9.0x9.0mm_Pitch0.8mm.step, BGA-1023_32x32_33.0x33.0mm_Pitch1.0mm.FCStd, BGA-1023_32x32_33.0x33.0mm_Pitch1.0mm.step, BGA-1156_34x34_35.0x35.0mm_Pitch1.0mm.FCStd]
2019-10-06 layout done
    [board.kicad_pcb, board.sch, inc_Sensor_interface.sch, mosfet_bridges.sch, transceiver.sch]
2019-10-11 with rf shield
    [board.kicad_pcb, board.sch, inc_Sensor_interface.sch, mosfet_bridges.sch, power_conv.sch]
2019-10-11 with inductor
    [board.kicad_pcb, power_conv.sch]
2019-10-11 ground optimisation
    [board.kicad_pcb]
2019-10-14 with more pics
    [board.kicad_pcb]
2019-10-23 with correct direction for encoder 0
    [TinyFPGA_B.v, TinyFPGA_B_prim.v]
2019-10-27 with id
    [board.kicad_pcb]
2019-11-20 with ltc422 driver enable fix and more diff comparators for the other encoder aswell
    [board.kicad_pcb, board.sch, inc_Sensor_interface.sch, mosfet_bridges.sch, power_conv.sch, transceiver.sch]
2019-11-21 layout also done
    [board.kicad_pcb, board.sch, inc_Sensor_interface.sch, mosfet_bridges.sch, power_conv.sch, transceiver.sch]
2019-12-05 drive enable bug fixed
    [bldc_board_v0.6.csv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]
2019-12-09 with ice40 on board
    [board.kicad_pcb, board.sch, iCE40LP.sch, inc_Sensor_interface.sch, mosfet_bridges.sch, power_conv.sch]
2019-12-10 with level shifter
    [board.kicad_pcb, board.sch, iCE40LP.sch, inc_Sensor_interface.sch]
2019-12-12 more progress on layout
    [board.kicad_pcb, board.sch, iCE40LP.sch, inc_Sensor_interface.sch, mosfet_bridges.sch, power_conv.sch]
2019-12-15 ready to review
    [board.kicad_pcb]
2019-12-16 final touch
    [board.kicad_pcb]
2019-12-16 with bom
    [BOM.csv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]
2019-12-20 revised after pcbway input
    [BOM.csv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]
2019-12-23 updated nothing
    [board-B.Cu.gbr, board-B.Mask.gbr, board-B.Paste.gbr, board-B.SilkS.gbr, board-Cmts.User.gbr, board-Edge.Cuts.gbr, board-F.Cu.gbr, board-F.Fab.gbr]
2020-01-02 with current sensor read out draft
2020-01-05 updated position file
    [board.kicad_pcb]
2020-01-06 with new pin assignements and neopxl control
2020-01-23 it turns, coms are up
    [TinyFPGA_B_pin_table.CSV, TinyFPGA_B_sbt.sdf, TinyFPGA_B_sbt_vital.sdf, encoder.sch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]
2020-01-28 with all ids
    [TinyFPGA_B_pin_table.CSV, TinyFPGA_B_sbt.sdf, TinyFPGA_B_sbt_vital.sdf]
2020-01-29 draft i2c eeprom
    [TinyFPGA_B_pin_table.CSV, TinyFPGA_B_sbt.sdf, TinyFPGA_B_sbt_vital.sdf]
2020-01-29 draft eeprom i2c readout
    [TinyFPGA_B_pin_table.CSV, TinyFPGA_B_sbt.sdf, TinyFPGA_B_sbt_vital.sdf]
2020-01-29 with reading eeprom
    [TinyFPGA_B_pin_table.CSV, TinyFPGA_B_sbt.sdf, TinyFPGA_B_sbt_vital.sdf]
2020-01-29 reading eeprom every second
    [TinyFPGA_B_pin_table.CSV, TinyFPGA_B_sbt.sdf, TinyFPGA_B_sbt_vital.sdf]
2020-01-29 with intial eeprom read not working for some reason
    [TinyFPGA_B_pin_table.CSV, TinyFPGA_B_sbt.sdf, TinyFPGA_B_sbt_vital.sdf]
2020-01-30 oh man, finally...
    [TinyFPGA_B_pin_table.CSV, TinyFPGA_B_sbt.sdf, TinyFPGA_B_sbt_vital.sdf]
2020-01-30 sampling on positive edge...
    [TinyFPGA_B_pin_table.CSV, TinyFPGA_B_sbt.sdf, TinyFPGA_B_sbt_vital.sdf]
2020-01-31 with correct encoder1 scale
    [TinyFPGA_B.v, TinyFPGA_B_prim.v]
2020-02-04 manual override
    [TinyFPGA_B_pin_table.CSV]
2020-02-04 still positive rotation causes problems
    [TinyFPGA_B_pin_table.CSV]
2020-02-17 fixed ph phase lock on slow velocities
    [TinyFPGA_B_pin_table.CSV]
2020-02-17 with tli4970 readout
    [TinyFPGA_B_pin_table.CSV]
2020-02-17 with current sensor readout
2020-02-17 with current limit
2020-02-24 pin control check
    [TinyFPGA_B_pin_table.CSV, TinyFPGA_B_sbt.sdf, TinyFPGA_B_sbt_vital.sdf]
2020-02-24 with cross talk check
    [TinyFPGA_B_pin_table.CSV, TinyFPGA_B_sbt.sdf, TinyFPGA_B_sbt_vital.sdf]
2020-02-26 rs485 converter
    [rs485_adapter.kicad_pcb, rs485_adapter.sch, rs485_usb_adapter.kicad_pcb, rs485_usb_adapter.sch]
2020-02-26 with panels ordered from aisler
    [output.rs485_adapter_panel-B.Cu.gbr, output.rs485_adapter_panel-B.Mask.gbr, output.rs485_adapter_panel-B.Paste.gbr, output.rs485_adapter_panel-B.SilkS.gbr, output.rs485_adapter_panel-Edge.Cuts.gbr, output.rs485_adapter_panel-F.Cu.gbr, output.rs485_adapter_panel-F.Mask.gbr, output.rs485_adapter_panel-F.Paste.gbr]
2020-02-28 faster and more frequent current readout
2020-03-06 fucking finally
    [template_TinyFPGA_B_timingviewer.cfg]
2020-03-09 2MHz working
    [template_TinyFPGA_B_timingviewer.cfg]
2020-03-09 integrated variable baudrate into motorboard
2020-03-21 with adc_lvds
    [TinyFPGA_B_pin_table.CSV, TinyFPGA_B_sbt.sdf, TinyFPGA_B_sbt_vital.sdf]
2020-03-24 simple integrator
    [TinyFPGA_B_pin_table.CSV, TinyFPGA_B_sbt.sdf, TinyFPGA_B_sbt_vital.sdf]
2020-04-04 different fpga footprint, fix of bugs that came up in v0.7
    [board-B_Cu.gbr, board-B_Mask.gbr, board-B_Paste.gbr, board-B_SilkS.gbr, board-Cmts_User.gbr, board-Edge_Cuts.gbr, board-F_Cu.gbr, board-F_Fab.gbr]
2020-04-13 updated BOM
    [BOM.csv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]
2020-04-15 U8 according to lattice recommendations
    [board-B_Cu.gbr, board-B_Mask.gbr, board-B_Paste.gbr, board-B_SilkS.gbr, board-Cmts_User.gbr, board-Edge_Cuts.gbr, board-F_Cu.gbr, board-F_Fab.gbr]
2020-04-29 with designators on silkscreen
    [BOM.csv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]
2020-05-04 adapter for correct wiring and optional uart switch
    [rs485_usb_adapter-B_Cu.gbr, rs485_usb_adapter-B_Mask.gbr, rs485_usb_adapter-B_Paste.gbr, rs485_usb_adapter-B_SilkS.gbr, rs485_usb_adapter-Edge_Cuts.gbr, rs485_usb_adapter-F_Cu.gbr, rs485_usb_adapter-F_Mask.gbr, rs485_usb_adapter-F_Paste.gbr]
2020-05-04 adapter for correct wiring
    [rs485_adapter-B_Cu.gbr, rs485_adapter-B_Mask.gbr, rs485_adapter-B_Paste.gbr, rs485_adapter-B_SilkS.gbr, rs485_adapter-Edge_Cuts.gbr, rs485_adapter-F_Cu.gbr, rs485_adapter-F_Mask.gbr, rs485_adapter-F_Paste.gbr]
2020-05-08 minor solder mask modifications and better export parameters for solder mask clearance
    [BOM.csv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]
2020-05-19 without encoder match
2020-05-19 up to track with master
2020-05-21 better scale factor to 4096 for both encoders er revolution
2020-07-29 pi controller error divided by 16, which enables smaller gains
    [TinyFPGA_B_prim.v, motorControl.v]
2020-07-29 with 0 debounce for the encoders
2020-09-08 with pwmlimit also for direct_pwm
2021-04-07 Small improvement to the messages printed by the arduino eeprom flashing utility. Exported a pdf for the board schematic.
2021-12-06 change the calculation from div53 to mul53 in scaked encoder calculation
2021-12-10 changed back to div and encoder0 and encoder1 values publish the raw data this was done as a fast compile
2022-01-14 reverted to original roboy3 branch commit 7051a6a and change the debounce_time of the quadrature_decoder to 16
    [TinyFPGA_B.v, TinyFPGA_B_prim.v, quadrature_decoder.vhd]
2022-01-17 fast compile raw encoder values, no LED, no Neopixle, Worst case max clock speed 3.74MHz
2022-01-17 uncommented direction otherwise not working
    [TinyFPGA_B.v, TinyFPGA_B_prim.v, coms.v]
2022-01-20 new software with new scaling of encoder0 and encoder1 because of different gear ratio now (3375/64)
2022-02-01 fixed typo so e1 is published right and compiled new version
    [TinyFPGA_B.v, TinyFPGA_B_prim.v]
2022-02-15 Revert "Roboy3 mul instead of div"
    [TinyFPGA_B.v, TinyFPGA_B_prim.v, quadrature_decoder.vhd]
