Roboy/iceboard/(notices)

Notices in the files:
parts and their libraries:
©2009 ROFA.cz - modified and updated by Robert Darlington ‹rdarlington@gmail.com›
